Felipedsi97/development-board-CAD/PG/esquematico/Models and Datasheets/LD1117S33/LD1117S33CTR.step

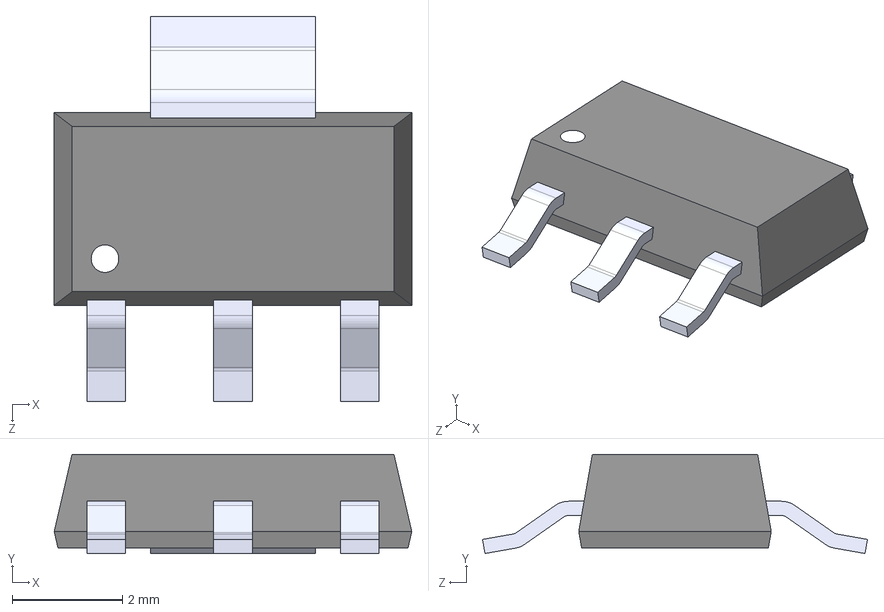
[picture p1: CAD file, 2023-08-02]
PG/esquematico/Models and Datasheets/LD1117S33/LD1117S33CTR.step
6.50 x 1.80 x 7.00 mm
