Felipedsi97/development-board-CAD/PG/esquematico/Models and Datasheets/PJ-002A/PJ-002A.step

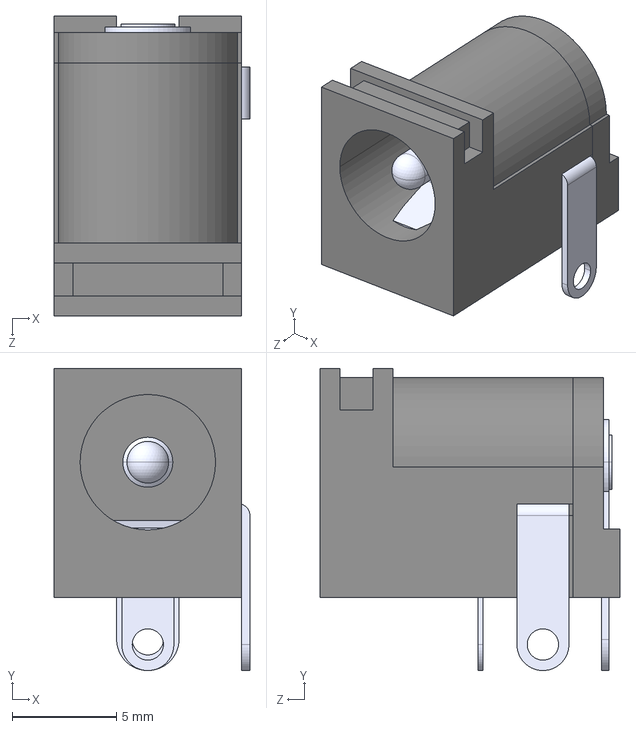
[picture p2: CAD file, 2023-08-02]
PG/esquematico/Models and Datasheets/PJ-002A/PJ-002A.step
9.40 x 14.5 x 14.4 mm
