Felipedsi97/development-board-CAD/PI/Schematics and Footprints/ATS08A-E/ATS08A-E.step

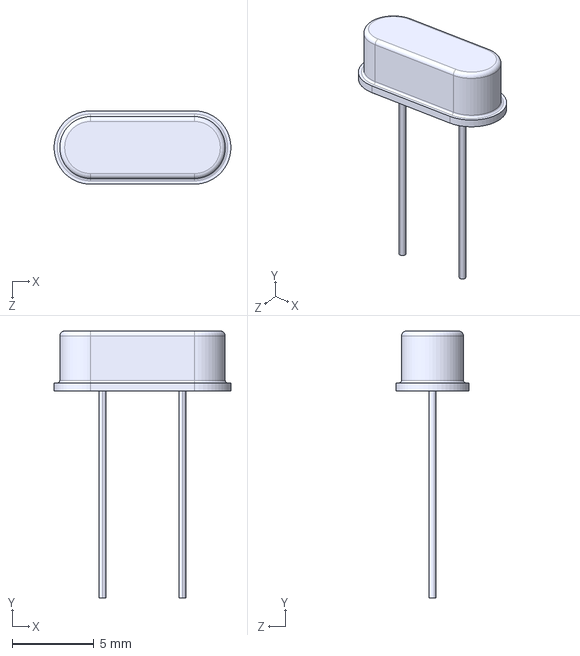
[picture p3: CAD file, 2023-08-02]
PI/Schematics and Footprints/ATS08A-E/ATS08A-E.step
10.9 x 16.4 x 4.50 mm
