Felipedsi97/development-board-CAD/PG/Manual.pdf

## PBLE01 Co-projeto de produtos eletrônicos

### Manual

Grupo 1

Rev 1 - Nov/2022

## Sumário

1 Introdução | 4
2 Requisitos | 4
3 Ambiente de desenvolvimento | 5
4 Esquema elétrico | 6
4.1 Circuito Geral | 6
4.2 Circuito de alimentação | 7
4.3 Circuito de gravação | 8
4.4 Circuito de relógio | 9
4.5 Circuito de chaves e LEDs | 9
4.6 Circuito de sinais analógicos | 10
4.7 Circuito do LCD | 11
4.8 Circuito de barras de expansão | 12
4.9 Relatório de verificação de erros de projeto elétrico | 13
5 Placa de circuito impresso | 14
5.1 Desenho da placa de circuito impresso | 15
5.2 Relatório de verificação de erros de projeto | 17
6 Características gerais | 18
6.1 Mapas de pinos | 18
6.1.1 Microcontrolador | 18
6.1.2 Interface | 19
6.2 Alimentação e consumo | 23
7 Programa embarcado de validação | 24
7.1 Modelo de operação geral | 24
7.2 Arquitetura | 24
7.3 Casos de uso | 30
8 Custos | 31
8.1 Materiais | 31
9 Apêndice | 32
9.1 Memorial de cálculos | 32
9.2 Código-fonte do programa de validação | 32
9.3 Lista de compras | 45
10 Bibliografia | 47
11 Anexo | 48
________________________________________________________________________ 2/49

## Identificação

Matrícula | Nome | Responsabilidade
2019002970 | Felipe dos Santos | Esquema elétrico
2017018748 | William Shoji Yokota | Placa de circuito impresso
2020025501 | Afonso Ambrósio Beiral Satolo Monteiro | Embarcado

Data:
28/11/22

________________________________________________________________________ 3/49

## 1 Introdução

Apresentar o objetivo deste documento.
O objetivo deste documento é apresentar os detalhes de projeto de uma placa de desenvolvimento de propósito geral desenvolvida ao decorrer do curso. Detalhes de projeto como cálculos das especificações de componentes, custos e modo de uso do circuito final serão explicitados.

## 2 Requisitos

Os requisitos elétricos do projeto estão dispostos na tabela a seguir.

Tabela 1: Requisitos técnicos quanto à alimentação
Requisito | Classe | Descrição
R1 | Alimentação | - Suportar tensão de entrada de 7 a 10V (CC); - Empregar conector de alimentação do tipo jack J4; - Possuir proteção contra tensão reversa; - Possuir regulador linear com saída de 5V (CC); - Possuir regulador linear com saída de 3.3V (CC); - Possuir LED de indicação de tensão de alimentação;
R2 | Operação/gravação do embarcado | - Empregar microcontrolador da família LCP1114; - Possuir barra de pinos para gravação do padrão JTAG; - Possuir circuito baseado em “jumper” para permitir a gravação serial através de transceptor USB-serial; - Chave tactil de reinício;
R3 | Interface de Usuário | - Possuir teclado numérico de cinco (5) teclas com disposição de controle (botões direcionais e de confirmação); - Possuir barra de pinos de conexão para visor LCD; - Possuir quatro (4) LEDs para sinalização diversa;
R4 | Periféricos e expansão | - Empregar relógio de tempo real; - Empregar conversor digital para analógico; - Possuir entrada para sinal analógico diferencial; - Possuir duas barras de expansão independentes cada qual com sinais de comunicação I²C, de referência (terra) e de alimentação; - Possuir barra de expansão de sinais para pinos não utilizados do microcontrolador e a contemplar os sinais de alimentação;
R5 | Comunicação | - Empregar conversor USB-serial;

________________________________________________________________________ 4/49

## 3 Ambiente de desenvolvimento

A tabela a seguir indica os recursos utilizados no projeto bem como suas versões,

Tabela 2: Recursos de desenvolvimento
Recurso | Descrição | Versão
1 | KiCad | 6.0.7
2 | MPLAB X IDE | 6.05
3 | PICSimLab | 0.8.11

________________________________________________________________________ 5/49

## 4 Esquema elétrico

A partir dos requisitos, uma representação do esquema elétrico foi montada na ferramenta KiCad. Todo o projeto pôde ser desenvolvido em uma única página, subdividido nos seguintes blocos funcionais: alimentação, gravação, periféricos (relógio, sinais analógicos e barras de expansão) e interface (visor LCD, teclado e LEDs). Tais blocos funcionais vêm descritos a seguir.

## 4.1 Circuito Geral

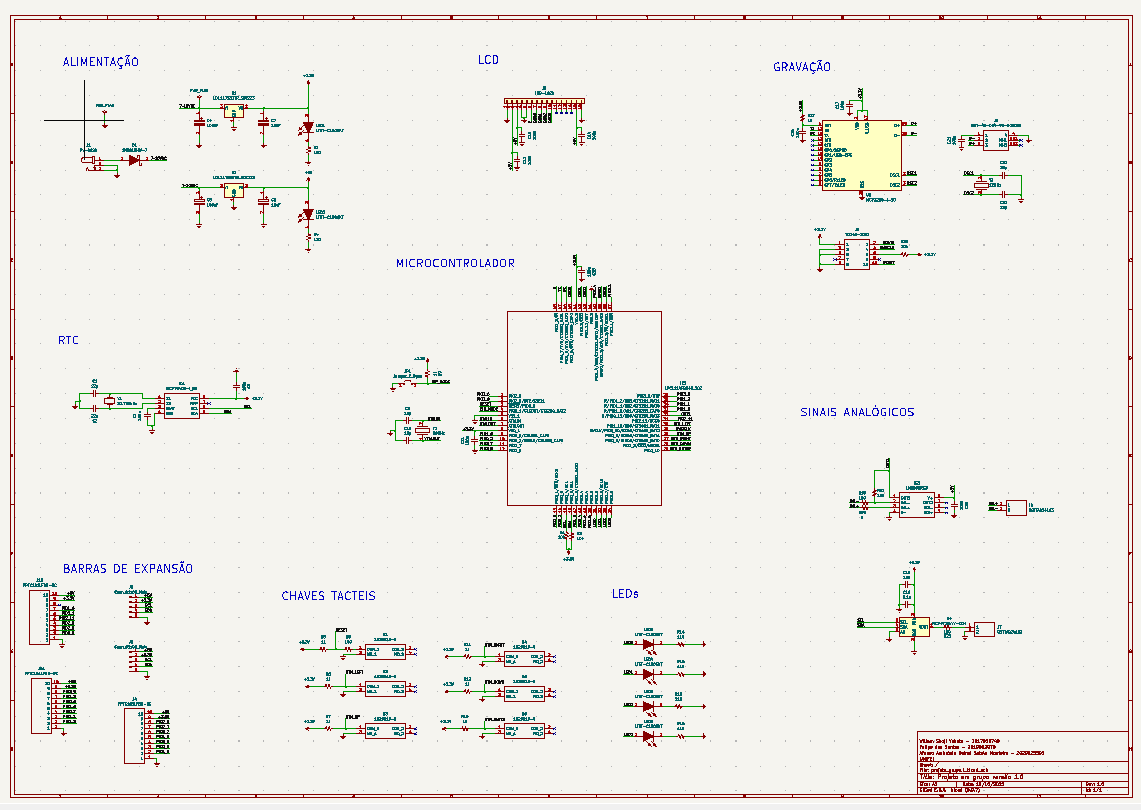
[picture p4: figure]

________________________________________________________________________ 6/49

## 4.2 Circuito de alimentação

O primeiro bloco funcional é responsável por receber a alimentação do sistema e gerar sinais estáveis de 5V e 3.3V em corrente contínua. Também conta com um diodo para proteção contra polarização reversa.

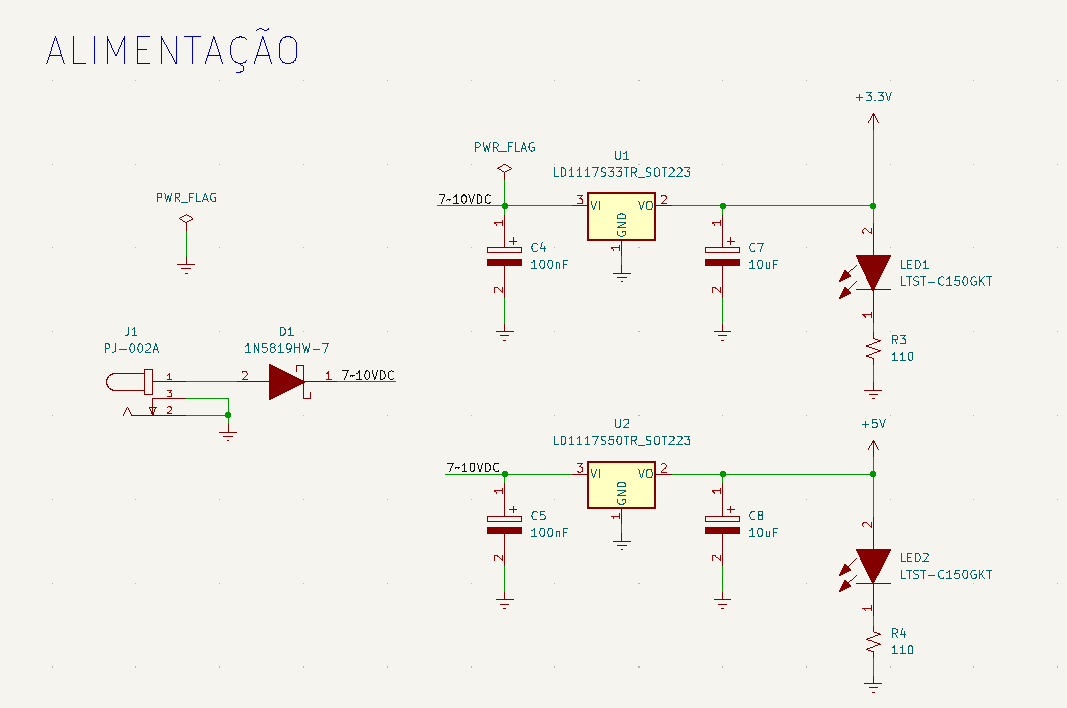
[picture p5: figure]

________________________________________________________________________ 7/49

## 4.3 Circuito de gravação

O circuito de gravação conta com conectores JTAG e USB possibilitando que o firmware possa ser gravado de duas formas diferentes no microcontrolador.

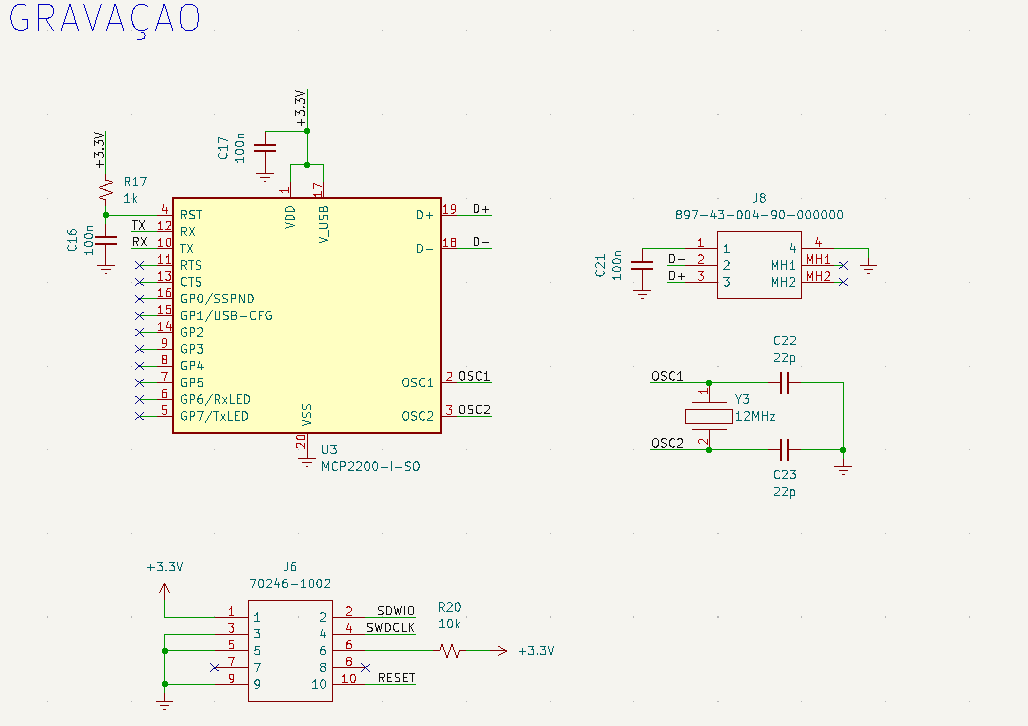
[picture p6: figure]

________________________________________________________________________ 8/49

## 4.4 Circuito de relógio

Um dos periféricos presentes é um relógio de tempo real (RTC) responsável por fornecer horários de forma mais precisa, possibilitando ainda a configuração de alarmes. A comunicação entre o RTC e o microcontrolador se dá pelo protocolo I²C.

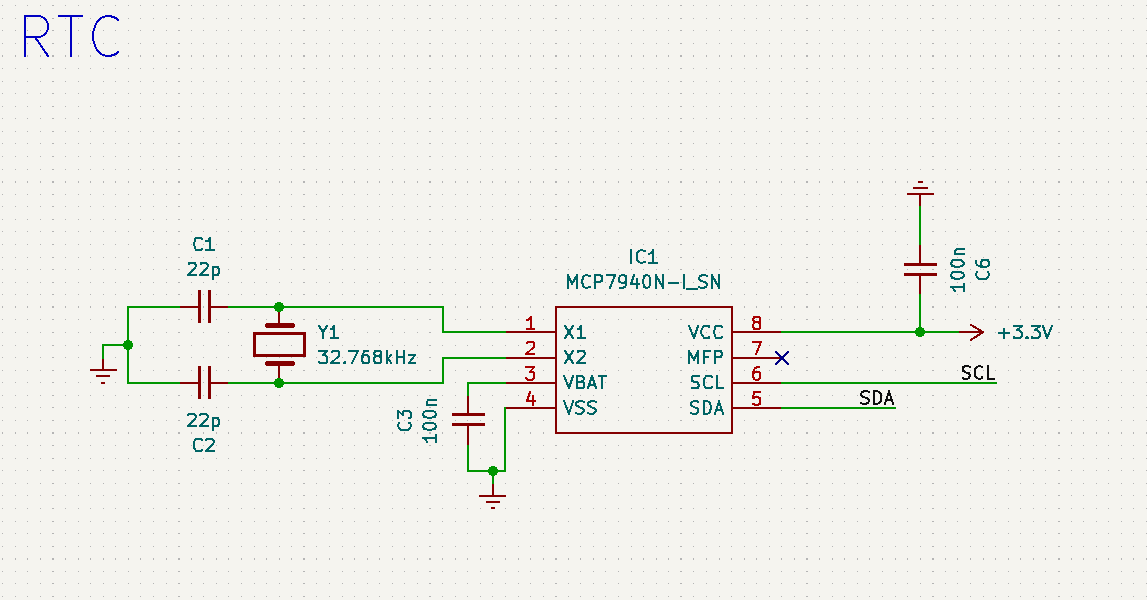
[picture p7: figure]

## 4.5 Circuito de chaves e LEDs

O circuito de teclado e LEDs é responsável pela interação com o usuário, possibilitando a navegação e seleção de funcionalidades no menu de controle do sistema, além de indicar estados através dos LEDs.

________________________________________________________________________ 9/49

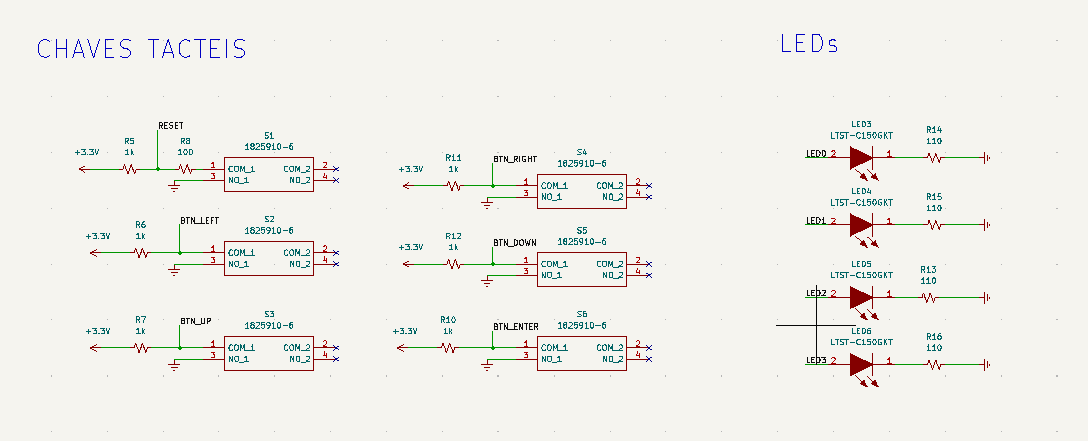
[picture p8: figure]

## 4.6 Circuito de sinais analógicos

O circuito de sinais analógicos conta com duas funcionalidades: ler dados de forma analógica e converter sinais digitais em analógicos. A entrada analógica é realizada por meio de um amplificador operacional com ganho equivalente às tensões de trabalho do microcontrolador (3.3V) e a saída analógica é realizada pelo conversor digital-analógico. Ambos possuem conectores diferenciais.

________________________________________________________________________ 10/49

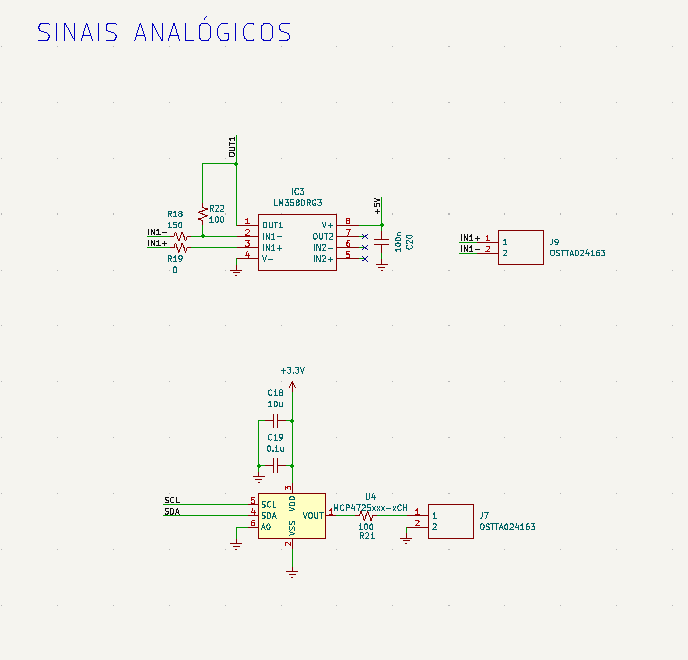
[picture p9: figure]

## 4.7 Circuito do LCD

O visor LCD é responsável pela interação com o usuário, sendo um dispositivo de saída.

________________________________________________________________________ 11/49

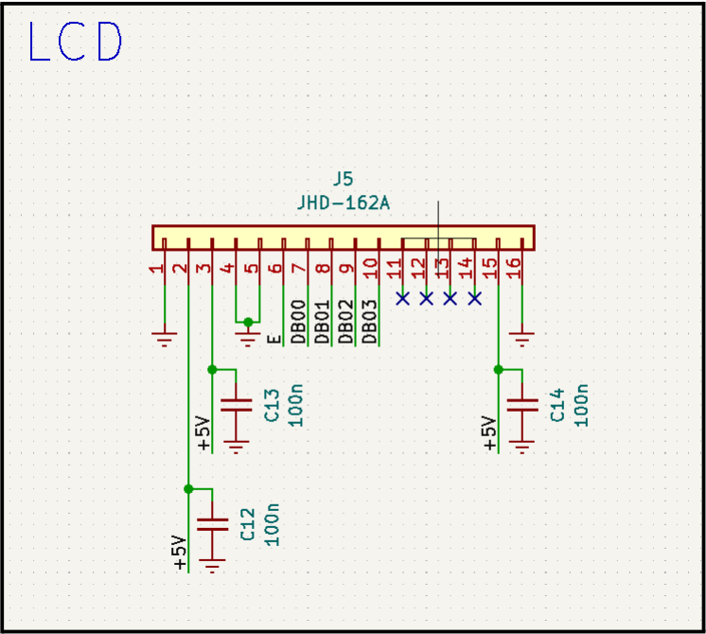
[picture p10: figure]

## 4.8 Circuito de barras de expansão

________________________________________________________________________ 12/49

As barras de expansão estão previstas para garantir a possibilidade de futuras adaptações no projeto, além de dois canais de comunicação I²C com o microcontrolador para propósitos do usuário.

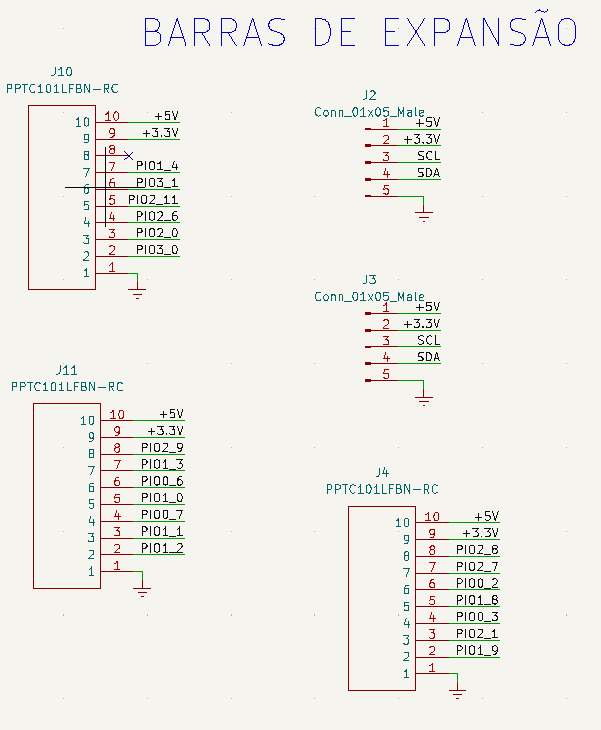
[picture p11: figure]

## 4.9 Relatório de verificação de erros de projeto elétrico

________________________________________________________________________ 13/49

O relatório não apresentou erros e os avisos são relacionados a questões do próprio ambiente de desenvolvimento.

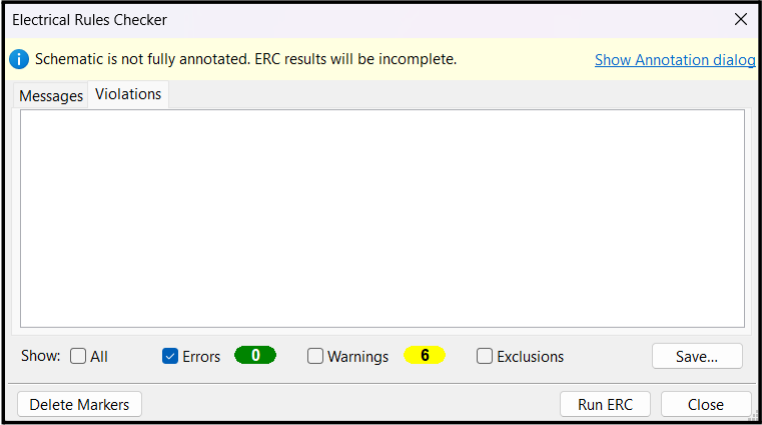
[picture p12: figure]

________________________________________________________________________ 14/49

## 5 Placa de circuito impresso

Descrever o desenvolvimento da PCI e listar (de forma tabular) os requisitos de projeto para tanto (distanciamentos, número de faces, etc). Especificar caso tenha sido utilizado planos de “terra”.
A PCI foi desenvolvida a partir do esquema elétrico englobando as funcionalidades e periféricos nele apresentados.

Tabela 3: Requisitos da PCI
Requisito | Classe | Descrição
R1 | Características gerais | - Ter dimensões de até 7x7cm; - Possuir dupla face de condução; - Utilizar a face inferior como plano de terra; - Possuir identificação dos componentes; - Possuir identificação do grupo de desenvolvimento; - Possuir identificação do pino de referência para conectores de programação e de alimentação; - Possuir identificação de pinos para demais conectores; - Possuir quatro furos de fixação posicionados nos cantos; - Possuir capacitores de supressão de tensão para todos os circuitos integrados;
R2 | Espaçamento | - Mínima largura para trilhas de sinais: 8 mils; - Mínima largura para trilhas de alimentação: 12 mils; - Mínimo espaçamento entre linhas, furos e ilhas: 8 mils; - Mínimo diâmetro de furo de vias: 12 mils; - Mínimo diâmetro de ilhas de vias: 25 mils; - Não utilizar microvias;

Tabela 4: Lista de componentes disponíveis

Item | Part number | Fabricante
Processador | LPC1114FBD48/302 | NXP
Relógio de tempo real | MCP7940N–I/SN | Microchip
Transceptor USB–serial | MCP2200–I/SO | Microchip
Conversor digital para analógico | MCP4725A0T-E/CH | Microchip
Resistores diversos (100, 470, 1k, 4k7, 10k, 100k e 1 M) | SMD 0805 | -
Capacitores cerâmicos (22 e 39 pF, 10 nF, 100 nF e 220 nF) | SMD 0805 | -
Capacitores (regulador de tensão) | 710-865090368008 | Wurth Elektronik
________________________________________________________________________ 15/49

Trimpot de 10k | P160KN–0QC15B100K | TT Electronics
Trimmer de 10k | 3296W–1–103RLF | Bourns Inc.
Barra de pinos | PPTC101LFBN–RC | Sullins Connector Solutions
Conector de energia | PJ–002A | CUI Devices
Diodos emissores de luz | LTST–C150GKT | Lite On
Amplificador operacional | LM358DR/LM358DG | On Semi
Conector USB | 897–43–004–90–000000 | Mill–Max
Chaves tácteis | 1825910–6 | TE Connectivity
Reguladores de tensão | LD1117AS33TR (3.3V) e LD1117AS50TR (5.0V) | STMicroelectronics
Cristal de 32.768 kHz | AB38T–32.768KHZ | ABRACON
Cristal de 20 MHz | ATS20A | CTS Electronic Components
Cristal de 12 MHz | ATS12A | CTS Electronic Components
Conector para entradas diferenciais | OSTTA024163 | On Shore Technology Inc.
Conector para barra de expansão | 3–644456–2 (por exemplo) | TE Connectivity
Diodo retificador | 1N5819HW–7 | Diodes Incorporated
Visor de 16x2 pontos | JHD162A | –
Conector JTAG (SWD) | 70246-1002 | Molex

## 5.1 Desenho da placa de circuito impresso

- Face superior:

________________________________________________________________________ 16/49

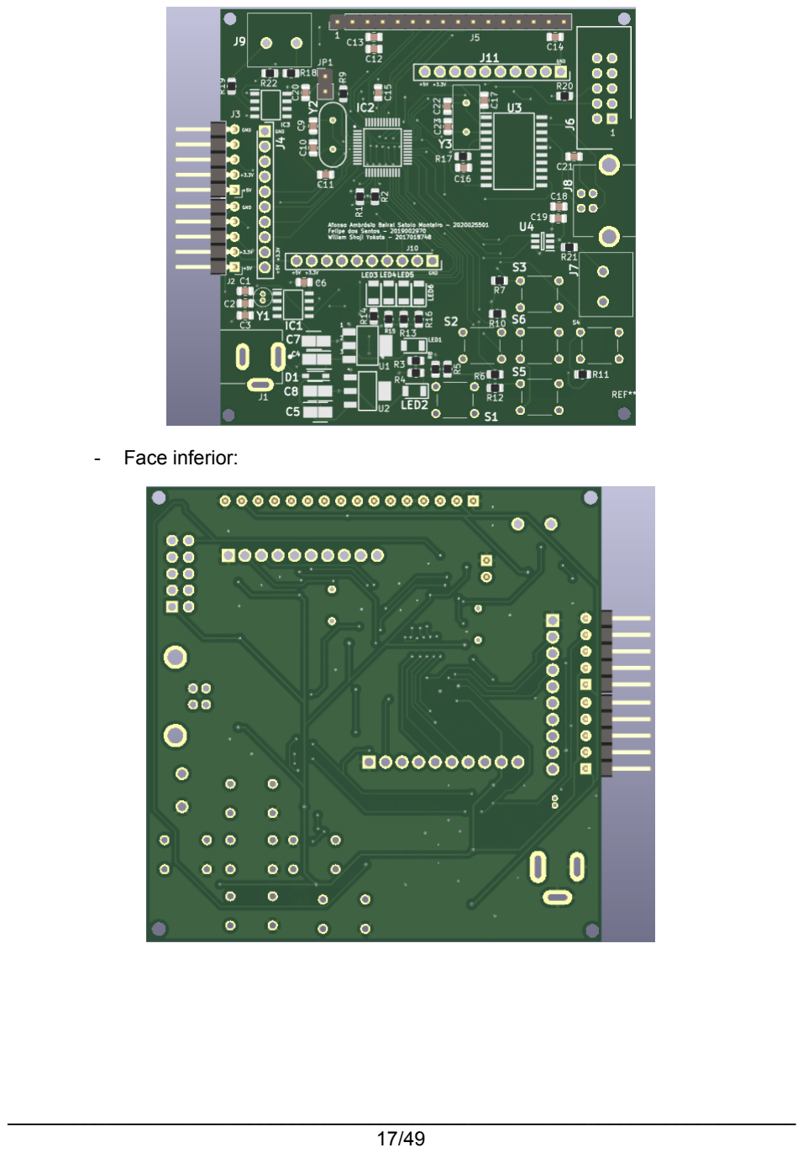
[picture p13: page 17]

- Face inferior:

________________________________________________________________________ 17/49

## 5.2 Relatório de verificação de erros de projeto

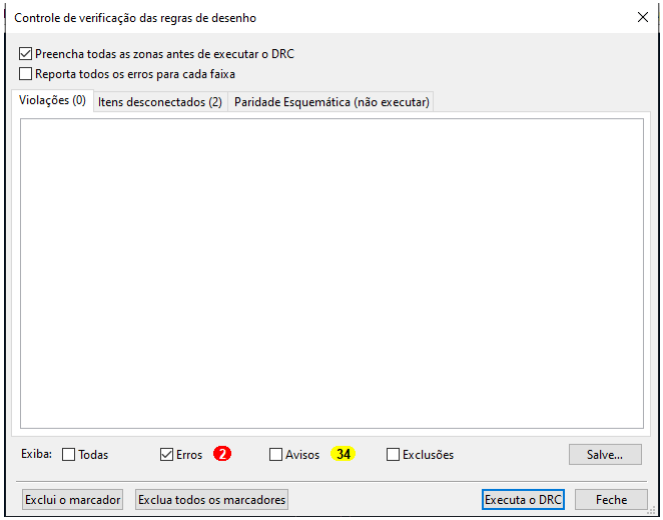
[picture p14: figure]

________________________________________________________________________ 18/49

## 6 Características gerais

## 6.1 Mapas de pinos

### 6.1.1 Microcontrolador

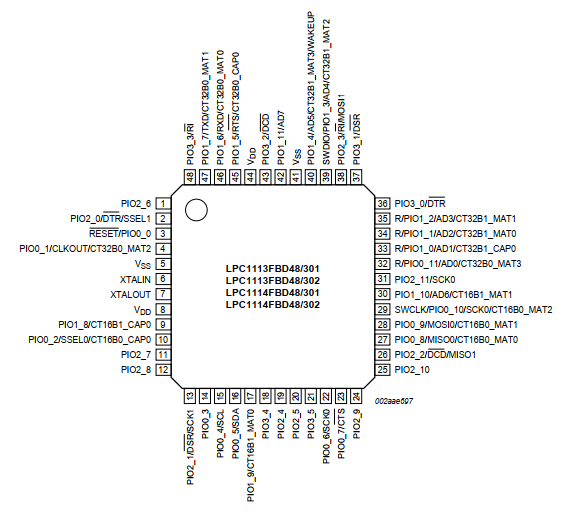
[picture p15: figure]

Pino | Conexão | Pino | Conexão | Pino | Conexão | Pino | Conexão
01 | PIO2_6 | 13 | PIO2_1 | 25 | BTN_ENTER | 37 | PIO3_1
02 | PIO2_0 | 14 | PIO0_3 | 26 | BTN_DOWN | 38 | DB03
03 | RESET | 15 | SCL | 27 | BTN_RIGHT | 39 | SWDIO
04 | ISP_MODE | 16 | SDA | 28 | BTN_UP | 40 | PIO1_4
05 | Earth | 17 | PIO1_9 | 29 | SWDCLK | 41 | Earth

________________________________________________________________________ 19/49

06 | XTALIN | 18 | PIO3_4 | 30 | BTN_LEFT | 42 | DB02
07 | XTALOUT | 19 | PIO2_4 | 31 | PIO2_11 | 43 | DB01
08 | +3.3V | 20 | PIO2_5 | 32 | OUT1 | 44 | +3.3V
09 | PIO1_8 | 21 | LED0 | 33 | PIO1_0 | 45 | DB00
10 | PIO0_2 | 22 | LED1 | 34 | PIO1_1 | 46 | RX
11 | PIO2_7 | 23 | LED2 | 35 | PIO1_2 | 47 | TX
12 | PIO2_8 | 24 | LED3 | 36 | PIO3_0 | 48 | E

### 6.1.2 Interface

- Gravação:
a) MCP2200
Pinos | Conexão | Pinos | Conexão
1- VDD | 3.3V | 11 - RTS | N/C
2 - Oscilador | Crystal Y3 | 12 - RX | Micro (TX)
3 - Oscilador | Crystal Y3 | 13 - CTS | N/C
4 - RST | 3.3V | 14 - GP2 | N/C
5 - GP7 | N/C | 15 - GP1 | N/C
6 - GP6 | N/C | 16 - GP0 | N/C
7 - GP5 | N/C | 17 - V_USB | 3.3V
8 - GP4 | N/C | 18 - D- | USB 897-43-004-90-000000 (D-)
9 - GP3 | N/C | 19 - D+ | USB - 897-43-004-90-000000 (D+)
10 - TX | Micro (RX) | 20 - VSS | GND
b) J6
Pinos | Conexão | Pinos | Conexão
1 | 3.3V | 6 | 3.3V
2 | Micro (SWIO) | 7 | N/C

________________________________________________________________________ 20/49

3 | GND | 8 | N/C
4 | Micro (SWDCLK) | 9 | GND
5 | GND | 10 | Micro (RESET)
c) J8
Pinos | Conexão | Pinos | Conexão
1 | GND | 4 | GND
2 | D- | MH1 | N/C
3 | D+ | MH2 | N/C
- Relógio de tempo real (RTC - MCP7940N ):
Pinos | Conexão | Pinos | Conexão
1- X1 | Crystal Y1 | VCC | 3.3V
2 - X2 | Crystal Y1 | MFP | N/C
3 - VBAT | GND | SCL | Micro (SCL)
4 - VSS | GND | SDA | Micro (SDA)
- Sinais Analógicos:
a) MCP4725
Pinos | Conexão | Pinos | Conexão
1 - VOUT | J7 (1) | 4 - SDA | Micro (SDA)
2 - VSS | GND | 5 - SCL | Micro (SCL)
3 - VDD | 3.3V | 6 - A0 | GND
b) J7
Pinos | Conexão
1 | MCP4725 (VOUT)

________________________________________________________________________ 21/49

2 | GND
c) LM358
Pinos | Conexão | Pinos | Conexão
1 - OUT1 | Micro (OUT1) | 5 - IN2+ | N/C
2 - IN1- | J9 (2) | 6 - IN2- | N/C
3 - IN1+ | J9 (1) | 7 - OUT2 | N/C
4 - V- | GND | 8 - V+ | 5V
d) J9
Pinos | Conexão
1 | LM358 (IN1+)
2 | LM358 (IN1-)
- Barras de Expansão:
a) J2 e J3
Pinos | Conexão | Pinos | Conexão
1 | 5V | 4 | Micro (SDA)
2 | 3.3V | 5 | GND
3 | Micro(SCL)
b) J4
Pinos | Conexão | Pinos | Conexão
1 | GND | 6 | Micro (PIO0_2)
2 | Micro (PIO1_9) | 7 | Micro (PIO2_7)
3 | Micro (PIO2_1) | 8 | Micro (PIO2_8)
4 | Micro (PIO0_3) | 9 | 3.3V

________________________________________________________________________ 22/49

5 | Micro (PIO1_8) | 10 | 5V
c) J10
Pinos | Conexão | Pinos | Conexão
1 | GND | 6 | Micro (PIO3_1)
2 | Micro (PIO3_0) | 7 | Micro (PIO1_4)
3 | Micro (PIO2_0) | 8 | N/C
4 | Micro (PIO2_6) | 9 | 3.3V
5 | Micro (PIO2_11) | 10 | 5V
d) J11
Pinos | Conexão | Pinos | Conexão
1 | GND | 6 | Micro (PIO0_6)
2 | Micro (PIO1_2) | 7 | Micro (PIO1_3)
3 | Micro (PIO1_1) | 8 | Micro (PIO2_9)
4 | Micro (PIO0_7) | 9 | 3.3V
5 | Micro (PIO1_0) | 10 | 5V
- LCD:
Pinos | Conexão | Pinos | Conexão
1 | GND | 9 | Micro (DBO2)
2 | 5V | 10 | Micro (DBO3)
3 | 5V | 11 | N/C
4 | GND | 12 | N/C
5 | GND | 13 | N/C
6 | E | 14 | N/C
________________________________________________________________________ 23/49

7 | Micro (DBO0) | 15 | 5V
8 | Micro (DBO1) | 16 | GND

## 6.2 Alimentação e consumo

A placa deve ser alimentada com uma tensão de entre +7V e +15V CC. O consumo estimado do sistema é de 1.2 watts.

________________________________________________________________________ 24/49

## 7 Programa embarcado de validação

O programa embarcado de validação tem por finalidade testar os componentes da placa. O programa desenvolvido testa o teclado, os LEDs de indicação, o visor de LCD e a entrada de sinal diferencial.

## 7.1 Modelo de operação geral

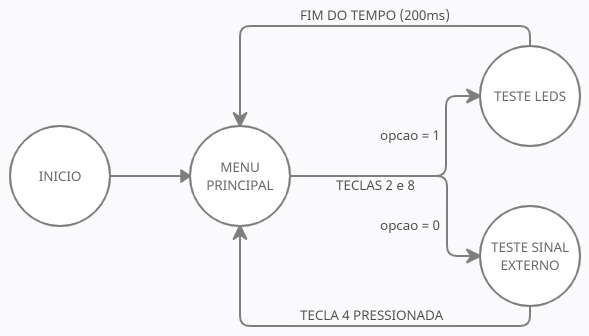
[picture p16: figure]

## 7.2 Arquitetura

delayX2ms [main.c - programa]

Parâmetros | unsigned char t
Retorno | void

Gera um atraso (delay) de 2 x t milisegundos

Dependência -

________________________________________________________________________ 25/49

bitSet [bits.h - driver]

Parâmetros | int arg, int bit
Retorno | 0 ou 1

Define o determinado bit (bit) de uma porta (arg) como ligado (high).

Dependência -

bitClr [bits.h - driver]

Parâmetros | int arg, int bit
Retorno | 0 ou 1

Define o determinado bit (bit) de uma porta (arg) como desligado (low).

Dependência -

bitTst [bits.h - driver]

Parâmetros | int arg, int bit
Retorno | 0 ou 1

Testa se determinado bit (bit) de uma porta (arg) está ligado ou desligado.

Dependência -

digitalWrite [io.c - driver]

Parâmetros | int pin, int value
Retorno | void

Escreve o valor recebido (value) na porta recebida (pin).

Dependência bitSet, bitClr

________________________________________________________________________ 26/49

pinMode [io.c - driver]

Parâmetros | int pin, int type
Retorno | void

Configura um determinado pino como entrada ou saída.

Dependência bitSet, bitClr

Delay2ms [lcd.c - driver]

Parâmetros | -
Retorno | void

Gera um atraso de 2 milissegundos

Dependência -

Delay40us [lcd.c - driver]

Parâmetros | -
Retorno | void

Gera um atraso de 40 microsegundos.

Dependência -

lcdCommand [lcd.c - driver]

Parâmetros | unsigned char opcao
Retorno | void

Responsável por enviar comandos ao visor, como posição do cursor e limpar o display.

Dependência digitalWrite, Delay2ms, Delay40us

________________________________________________________________________ 27/49

lcdInit [lcd.c - driver]

Parâmetros | -
Retorno | void

Configura as portas responsáveis por se comunicar com o display e envia os comandos iniciais configurando o modo de operação do mesmo.

Dependência pinMode, Delay2ms, lcdCommand

lcdData [lcd.c - driver]

Parâmetros | unsigned char opcao
Retorno | void

Envia dados a serem impressos no display de acordo com a tabela ASCII.

Dependência digitalWrite, Delay40us

kpInit [keypad.c - driver]

Parâmetros | -
Retorno | void

Inicializa as portas responsáveis pelo teclado matricial.

Dependência -

kpDebounce [keypad.c - driver]

Parâmetros | -
Retorno | void

Verifica se há alguma tecla pressionada e armazena o endereço da tecla em uma variável interna.

Dependência bitSet, bitClr, bitTst

________________________________________________________________________ 28/49 kpRead [keypad.c - driver]

Parâmetros | -
Retorno | unsigned int

Retorna o valor que representa o endereço da tecla pressionada.

Dependência -

adcInit [adc.c - driver]

Parâmetros | -
Retorno | void

Inicializa o conversor analógico-digital.

Dependência pinMode, bitSet

adcRead [adc.c - driver]

Parâmetros | unsigned int channel
Retorno | int

Lê o valor presente no conversor analógico-digital e retorna um inteiro que varia de 0 a 100.

Dependência bitTst

menuLcd [main.c - programa]

Parâmetros | unsigned char opcao
Retorno | void

Aciona o visor de LCD imprimindo o menu de opções. Recebe o parâmetro “opcao” representando a opção selecionada no menu. Se “opcao” for igual a 0, a seta indicando

________________________________________________________________________ 29/49 a opção selecionada será impressa na primeira linha, caso contrário, a seta é impressa na segunda linha.

Dependência lcdCommand, lcdData

proxMenu [main.c - programa]

Parâmetros | unsigned char opcao
Retorno | void

“Move” a seta para cima ou para baixo a depender do valor recebido em “opcao”.

Dependência lcdCommand, lcdData

testeLed [main.c - programa]

Parâmetros | -
Retorno | void

Acende os 4 LEDs por aproximadamente 100 milissegundos e então os apaga enquanto exibe uma barra de progresso no visor. Retorna ao menu principal ao término do teste.

Dependência lcdCommand, lcdData, delayX2ms

testeSinalExt [main.c - programa]

Parâmetros | -
Retorno | void

Imprime o valor recebido do conversor analógico-digital no display de LCD o valor é lido e atualizado de forma indefinida até que a tecla referente à seta esquerda seja pressionada, retornando ao menu principal.

Dependência lcdCommand, lcdData, kpDebounce, kpRead, adcRead,

________________________________________________________________________ 30/49

## 7.3 Casos de uso

Estado inicial | Após ser energizada, a placa é inicializada com todos os leds apagados, no display é exibido o menu principal com as seguintes opções: - Teste LEDs - Teste sinal ext Por padrão a primeira opção estará selecionada, sendo indicado por uma seta para a direita;
Navegação | Pressionando as teclas 2 (seta para cima) e 8 (seta para baixo) do teclado numérico é possível subir e descer, respectivamente. Ao atingir o fim da lista, a seta volta ao topo;
Selecionar | Para selecionar uma opção do menu, basta pressionar as teclas 5 (enter) ou 6 (direita);
Teste LEDs | Ao acessar esta opção, os 4 leds (B4-B7) serão ligados; O display exibirá a mensagem “Teste LEDs” seguida de uma barra de progresso; Ao término o programa retorna ao menu inicial;
Teste sinal ext | Ao acessar esta opção, o display exibirá o valor lido pelo potenciômetro P1 em uma escala de 0 a 3.3 V; Para retornar ao menu principal, pressione a tecla 4 (seta para esquerda);

________________________________________________________________________ 31/49

## 8 Custos

## 8.1 Materiais

A estimativa de custo em materiais é de U$ 30,64 em componentes;

________________________________________________________________________ 32/49

## 9 Apêndice

## 9.1 Memorial de cálculos

Os cálculos dos resistores de pull-up e outros foram realizados utilizando a 1ª Lei de Ohm (U = R*I) com base nos parâmetros de funcionamento do microcontrolador listados abaixo.
Vih (min) = 0.7*Vdd
Vil (max) = 0.3*Vdd
Voh (min) = Vdd - 0.4
Vol (max) = 0.3*Vdd
Para os capacitores, foram utilizados valores estipulados pelo professor e valores sugeridos nas folhas de dados dos componentes utilizados.

## 9.2 Código-fonte do programa de validação

A seguir estão os arquivos de código fonte do projeto, os drivers usados foram elaborados pelo professor Rodrigo Maximiano Antunes de Almeida.

### 9.2.1 main.c

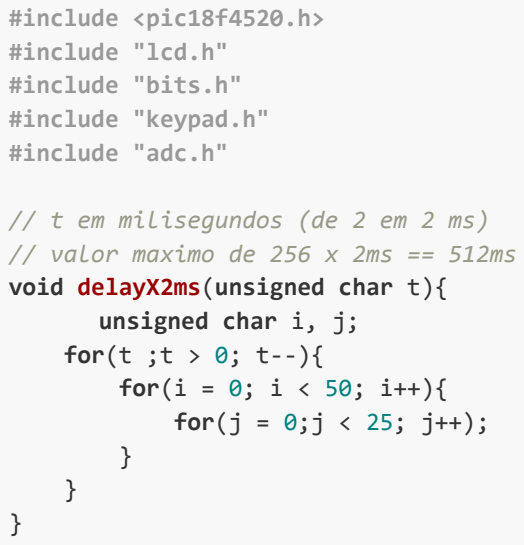
[picture p17: figure]
#include <pic18f4520.h> #include "lcd.h" #include "bits.h" #include "keypad.h" #include "adc.h"; // t em milisegundos (de 2 em 2 ms) // valor maximo de 256 x 2ms == 512ms void delayX2ms(unsigned char t){ unsigned char i, j; for(t ;t > 0; t--){ for(i = 0; i < 50; i++){ for(j = 0;j < 25; j++);

________________________________________________________________________ 33/49 void menuLcd(unsigned char opcao){ unsigned char i;
char menu0[10] = "Teste LEDs"; char menu1[15] = "Teste sinal ext";

// imprime o menu inicial
lcdCommand(0x0); // limpa o display lcdCommand(0x1);
lcdCommand(0x8); // leva para a primeira posicao lcdCommand(0x0);

if(opcao){
lcdData(0x7E);
}else{
lcdData(' ');
}

for(i = 0;i < 11;i++){
lcdData(menu0[i]);
}

// proxima linha
lcdCommand(0xC);
lcdCommand(0x0);

if(!opcao){
lcdData(0x7E);
}else{
lcdData(' ');
}

for(i = 0;i < 15;i++){
lcdData(menu1[i]);
}
}

void proxMenu(unsigned char opcao){ lcdCommand(0x8);
lcdCommand(0x0);

// faz troca a seta de posicao if(opcao){
lcdData(0x7E);
}else{
lcdData(' ');
}

________________________________________________________________________ 34/49

lcdCommand(0xc);
lcdCommand(0x0);

if(!opcao){
lcdData(0x7E);
}else{
lcdData(' ');
}
}

void testeLed(){
unsigned char i;
char titulo[13] = " Teste LEDs";

lcdCommand(0x0); // limpa o display lcdCommand(0x1);
lcdCommand(0x8); // leva para a primeira posicao lcdCommand(0x0);

// imprime o titulo
for(i = 0;i < 13;i++){
lcdData(titulo[i]);
}

// acende os LEDs
TRISB &= 0x0f;
PORTB |= 0xf0;

// proxima linha
lcdCommand(0xC);
lcdCommand(0x0);

// efeito barra de progresso for(i = 0;i < 16;i++){
lcdData(0xFF);
delayX2ms(50); // aprox 100ms }

// apaga os LEDs
PORTB = 0x00;
}

void testeSinalExt(){
unsigned char i;
unsigned int valor, botao = 0x0; char titulo[10] = "Sinal ext."; char sair[5] = " sair";

________________________________________________________________________ 35/49

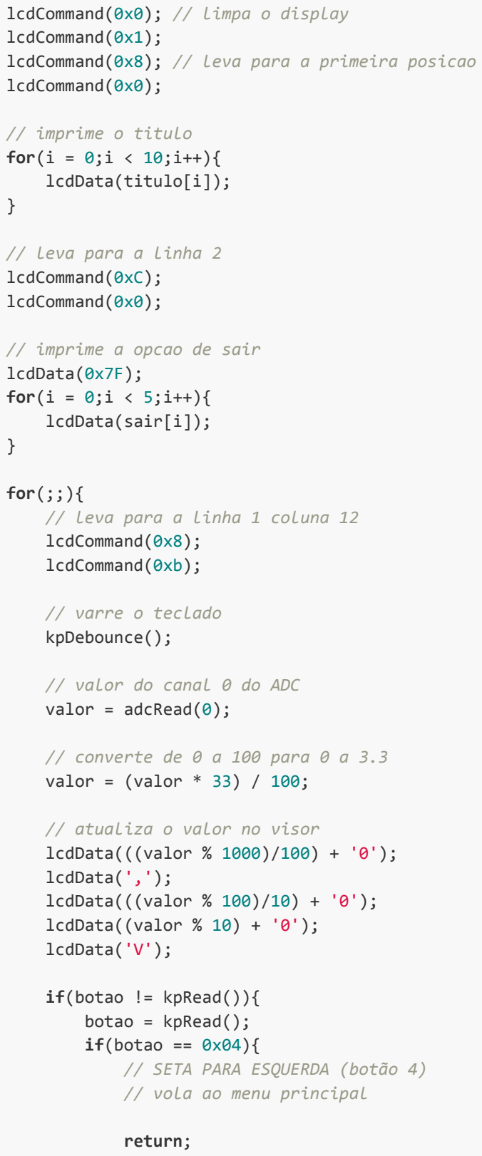
[picture p18: figure]
lcdCommand(0x0); // limpa o display lcdCommand(0x1);; lcdCommand(0x0);; // imprime o titulo for(i = 0;i < 10;i++){ lcdData(titulo[i]);; // leva para a linha 2 lcdCommand(0xC); lcdCommand(0x0);; // imprime a opcao de sair lcdData(0x7F); for(i = 0;i < 5;i++){ lcdData(sair[i]);; for(;;){ // leva para a linha 1 coluna 12 lcdCommand(0x8); lcdCommand(0xb);; // varre o teclado kpDebounce();; // valor do canal 0 do ADC valor = adcRead(0);; // converte de 0 a 100 para 0 a 3.3 valor = (valor * 33) / 100;; // atualiza o valor no visor lcdData(((valor % 1000)/100) + '0'); lcdData(','); lcdData(((valor % 100)/10) + '0'); lcdData((valor % 10) + '0'); lcdData('V');; if(botao != kpRead()){ botao = kpRead(); if(botao == 0x04){ // SETA PARA ESQUERDA (botão 4) // vola ao menu principal; return;

lcdCommand(0x8); // leva para a primeira posicao

________________________________________________________________________ 36/49

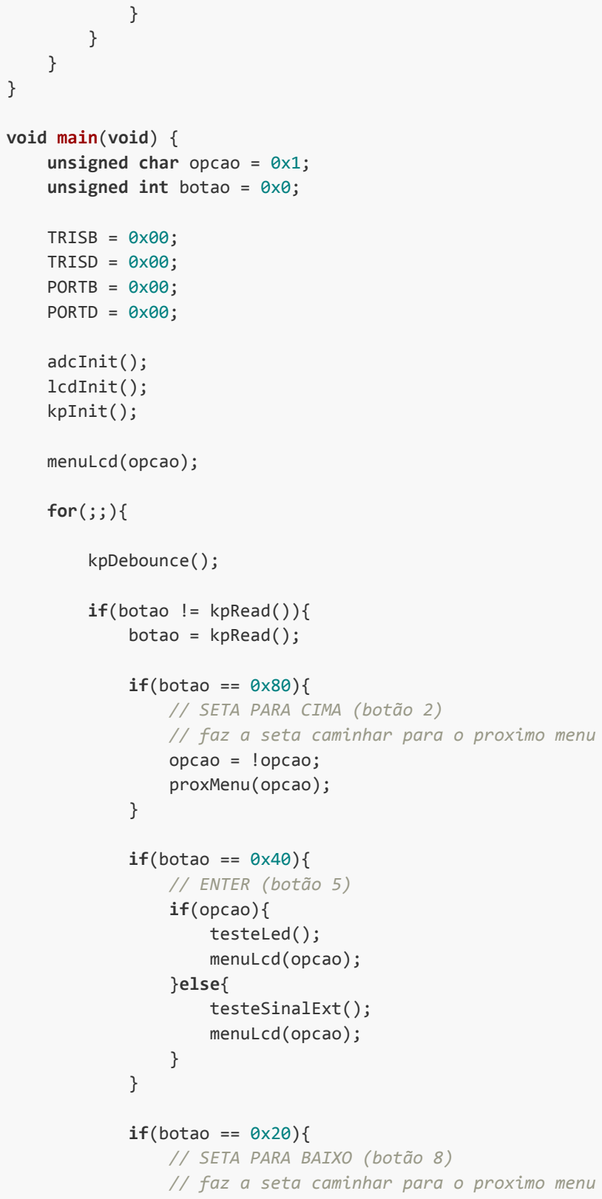
[picture p19: figure]
void main(void) { unsigned char opcao = 0x1; unsigned int botao = 0x0;; TRISB = 0x00; TRISD = 0x00; PORTB = 0x00; PORTD = 0x00;; adcInit(); lcdInit(); kpInit();; menuLcd(opcao);; for(;;){; kpDebounce();; if(botao != kpRead()){ botao = kpRead();; if(botao == 0x80){ // SETA PARA CIMA (botão 2); opcao = !opcao; proxMenu(opcao);; if(botao == 0x40){ // ENTER (botão 5) if(opcao){ testeLed(); menuLcd(opcao); }else{ testeSinalExt(); menuLcd(opcao);; if(botao == 0x20){ // SETA PARA BAIXO (botão 8)

// faz a seta caminhar para o proximo menu

// faz a seta caminhar para o proximo menu

________________________________________________________________________ 37/49

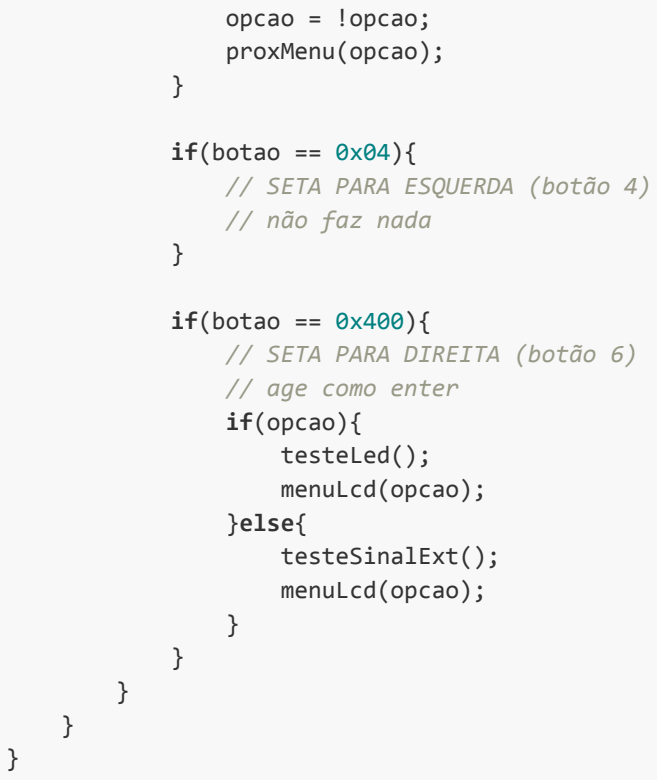
[picture p20: figure]
opcao = !opcao; proxMenu(opcao);; if(botao == 0x04){ // SETA PARA ESQUERDA (botão 4) // não faz nada; if(botao == 0x400){ // SETA PARA DIREITA (botão 6) // age como enter if(opcao){ testeLed(); menuLcd(opcao); }else{ testeSinalExt(); menuLcd(opcao);

### 9.2.2 adc.c

// -----------------------------------------------------------------------// Copyright (C) Rodrigo Almeida 2010
// -----------------------------------------------------------------------
// | Arquivo: adc.c
// | | Biblioteca do conversor AD para o PIC18F4520
// | Autor: | Rodrigo Maximiano Antunes de Almeida
// | | rodrigomax at unifei.edu.br
// | Licença: GNU GPL 2
// -----------------------------------------------------------------------
// | This program is free software; you can redistribute it and/or modify
// | it under the terms of the GNU General Public License as published by
// | the Free Software Foundation; version 2 of the License.
//
// | This program is distributed in the hope that it will be useful,
// | but WITHOUT ANY WARRANTY; without even the implied warranty of
// | MERCHANTABILITY or FITNESS FOR A PARTICULAR PURPOSE. See the
// | GNU General Public License for more details.
// -----------------------------------------------------------------------

#include "adc.h"

#include <pic18f4520.h>

#include "io.h"

________________________________________________________________________ 38/49

#include "bits.h"

void adcInit(void) {
//AN0-A0, AN1-A1 e AN2-A2 são analógicos e entradas pinMode(PIN_A0, INPUT);
pinMode(PIN_A1, INPUT);
//temperatura compartilhado com Display //removido da biblioteca
// pinMode(PIN_A2, INPUT);

bitSet(ADCON0, 0); //liga ADC
//config an0-2 como analógico
//ADCON1 = 0b00001100; //apenas AN0 é analogico, a referencia é baseada na fonte ADCON2 = 0b10101010; //FOSC /32, 12 TAD, Alinhamento à direita e tempo de conv =

### 12 TAD

}

int adcRead(unsigned int channel) {
unsigned int ADvalor;
ADCON0 &= 0b11000011; //zera os bits do canal if (channel < 3) {
ADCON0 |= channel << 2;
}

ADCON0 |= 0b00000010; //inicia conversao

while (bitTst(ADCON0, 1)); // espera terminar a conversão;

ADvalor = ADRESH; // le o resultado
ADvalor <<= 8;
ADvalor += ADRESL;
return ADvalor;
}

### 9.2.3 bits.h

#ifndef BIT_H

#define | BIT_H

//funções de bit
#define bitSet(arg,bit) ((arg) |= (1<<(bit))) #define bitClr(arg,bit) ((arg) &= ~(1<<(bit))) #define bitFlp(arg,bit) ((arg) ^= (1<<(bit))) #define bitTst(arg,bit) ((arg) & (1<<(bit)))

#endif /* XC_HEADER_TEMPLATE_H */

________________________________________________________________________ 39/49

### 9.2.4 io.c

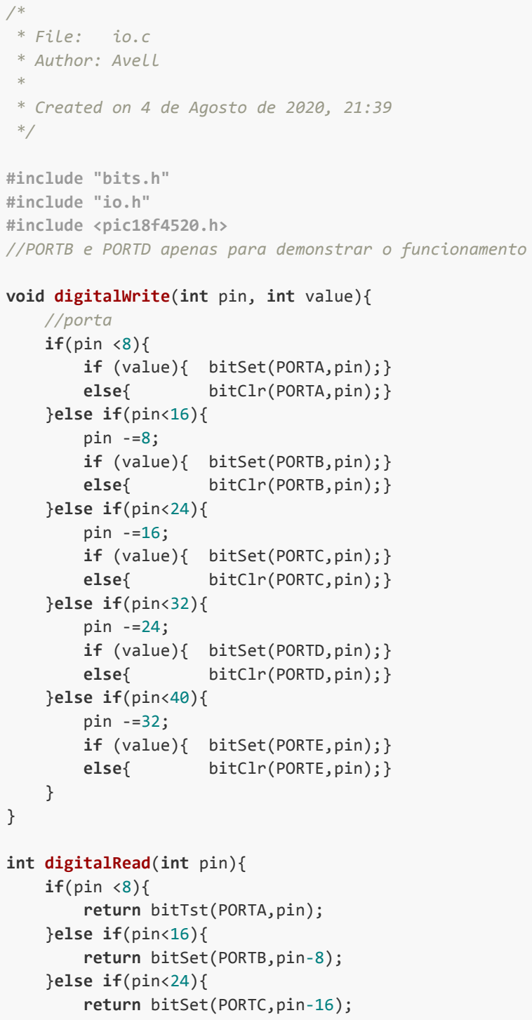
[picture p21: figure]
* File:; * Author: Avell * * Created on 4 de Agosto de 2020, 21:39 */; #include "bits.h" #include "io.h" #include <pic18f4520.h>; void digitalWrite(int pin, int value){ //porta if(pin <8){ if (value){ bitSet(PORTA,pin);}; else{; bitClr(PORTA,pin);}; }else if(pin<16){ pin -=8; if (value){ bitSet(PORTB,pin);}; bitClr(PORTB,pin);}; }else if(pin<24){ pin -=16; if (value){ bitSet(PORTC,pin);}; bitClr(PORTC,pin);}; }else if(pin<32){ pin -=24; if (value){ bitSet(PORTD,pin);}; bitClr(PORTD,pin);}; }else if(pin<40){ pin -=32; if (value){ bitSet(PORTE,pin);}; bitClr(PORTE,pin);}; int digitalRead(int pin){ if(pin <8){ return bitTst(PORTA,pin); }else if(pin<16){ return bitSet(PORTB,pin-8); }else if(pin<24){ return bitSet(PORTC,pin-16);

//PORTB e PORTD apenas para demonstrar o funcionamento

________________________________________________________________________ 40/49

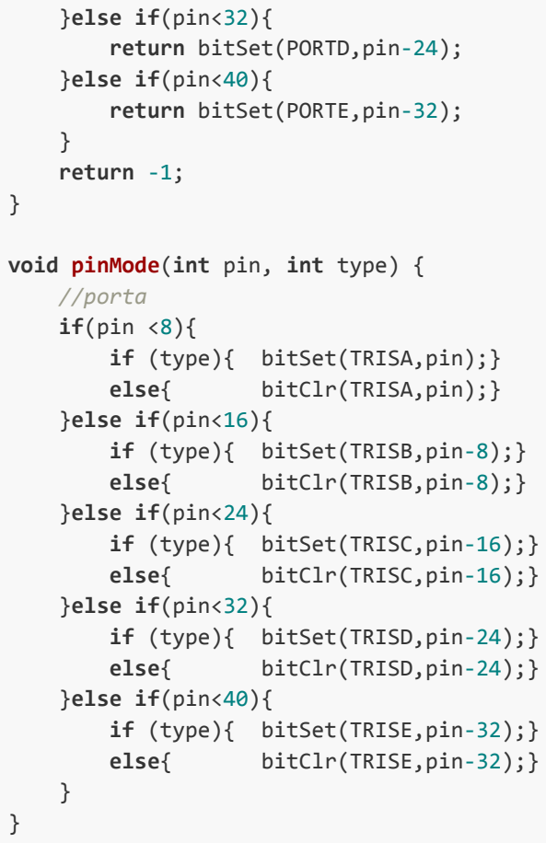
[picture p22: figure]
}else if(pin<32){ return bitSet(PORTD,pin-24); }else if(pin<40){ return bitSet(PORTE,pin-32);; } return -1;; void pinMode(int pin, int type) { //porta if(pin <8){ if (type){ bitSet(TRISA,pin);}; else{; bitClr(TRISA,pin);}; }else if(pin<16){ if (type){ bitSet(TRISB,pin-8);}; bitClr(TRISB,pin-8);}; }else if(pin<24){ if (type){ bitSet(TRISC,pin-16);}; bitClr(TRISC,pin-16);}; }else if(pin<32){ if (type){ bitSet(TRISD,pin-24);}; bitClr(TRISD,pin-24);}; }else if(pin<40){ if (type){ bitSet(TRISE,pin-32);}; bitClr(TRISE,pin-32);}

### 9.2.5 keypad.c

// -----------------------------------------------------------------------// Copyright (C) Rodrigo Almeida 2014
// -----------------------------------------------------------------------
// | Arquivo: keypad.c
// | | Biblioteca de operação de um teclado matricial
// | Autor: | Rodrigo Maximiano Antunes de Almeida
// | | rodrigomax at unifei.edu.br
// | Licença: GNU GPL 2
// -----------------------------------------------------------------------
// | This program is free software; you can redistribute it and/or modify
// | it under the terms of the GNU General Public License as published by
// | the Free Software Foundation; version 2 of the License.
//
// | This program is distributed in the hope that it will be useful,
// | but WITHOUT ANY WARRANTY; without even the implied warranty of
// | MERCHANTABILITY or FITNESS FOR A PARTICULAR PURPOSE. See the
// | GNU General Public License for more details.
// -----------------------------------------------------------------------
________________________________________________________________________ 41/49

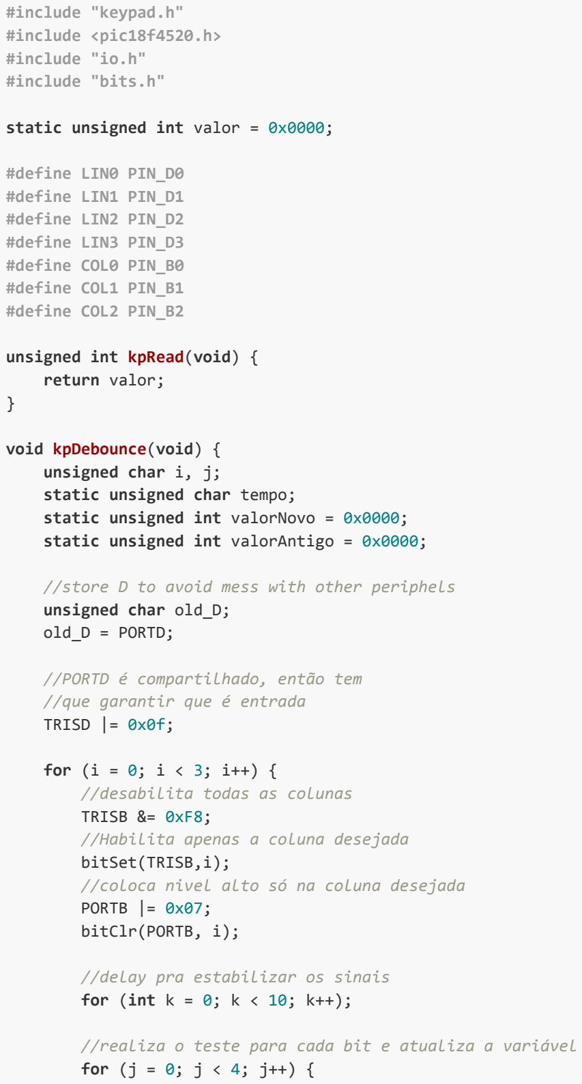
[picture p23: figure]
#include "keypad.h" #include <pic18f4520.h> #include "io.h" #include "bits.h"; static unsigned int valor = 0x0000;; #define LIN0 PIN_D0 #define LIN1 PIN_D1 #define LIN2 PIN_D2 #define LIN3 PIN_D3 #define COL0 PIN_B0 #define COL1 PIN_B1 #define COL2 PIN_B2; unsigned int kpRead(void) { return valor;; void kpDebounce(void) { unsigned char i, j; static unsigned char tempo; static unsigned int valorNovo = 0x0000;; unsigned char old_D; old_D = PORTD;; //PORTD é compartilhado, então tem //que garantir que é entrada TRISD |= 0x0f;; for (i = 0; i < 3; i++) { //desabilita todas as colunas TRISB &= 0xF8; //Habilita apenas a coluna desejada bitSet(TRISB,i);; PORTB |= 0x07; bitClr(PORTB, i);; //delay pra estabilizar os sinais for (int k = 0; k < 10; k++);; for (j = 0; j < 4; j++) {

static unsigned int valorAntigo = 0x0000;

//store D to avoid mess with other periphels

//coloca nivel alto só na coluna desejada

//realiza o teste para cada bit e atualiza a variável

________________________________________________________________________ 42/49

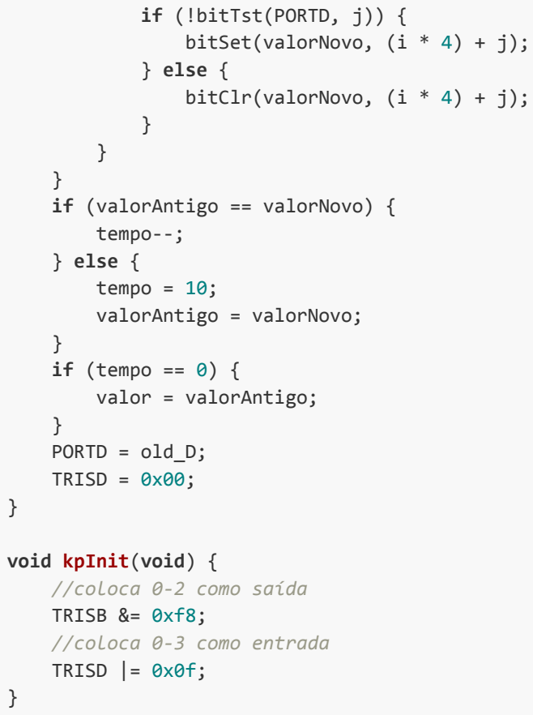
[picture p24: figure]
if (!bitTst(PORTD, j)) { bitSet(valorNovo, (i * 4) + j); } else { bitClr(valorNovo, (i * 4) + j);; } if (valorAntigo == valorNovo) { tempo--; } else { tempo = 10; valorAntigo = valorNovo;; } if (tempo == 0) { valor = valorAntigo;; } PORTD = old_D; TRISD = 0x00;; void kpInit(void) { //coloca 0-2 como saída TRISB &= 0xf8; //coloca 0-3 como entrada TRISD |= 0x0f;

### 9.2.6 lcd.c

Biblioteca alterada para comunicação com 4 bits entre o microcontrolador e o display.

// -----------------------------------------------------------------------
// Copyright (C) Rodrigo Almeida 2010
// -----------------------------------------------------------------------
// | Arquivo: lcd.c
// | | Biblioteca de manipulação do LCD
// | Autor: | Rodrigo Maximiano Antunes de Almeida
// | | rodrigomax at unifei.edu.br
// | Licença: GNU GPL 2
// -----------------------------------------------------------------------
// | This program is free software; you can redistribute it and/or modify
// | it under the terms of the GNU General Public License as published by
// | the Free Software Foundation; version 2 of the License.
//
// | This program is distributed in the hope that it will be useful,
// | but WITHOUT ANY WARRANTY; without even the implied warranty of
// | MERCHANTABILITY or FITNESS FOR A PARTICULAR PURPOSE. See the
// | GNU General Public License for more details.
// -----------------------------------------------------------------------
________________________________________________________________________ 43/49

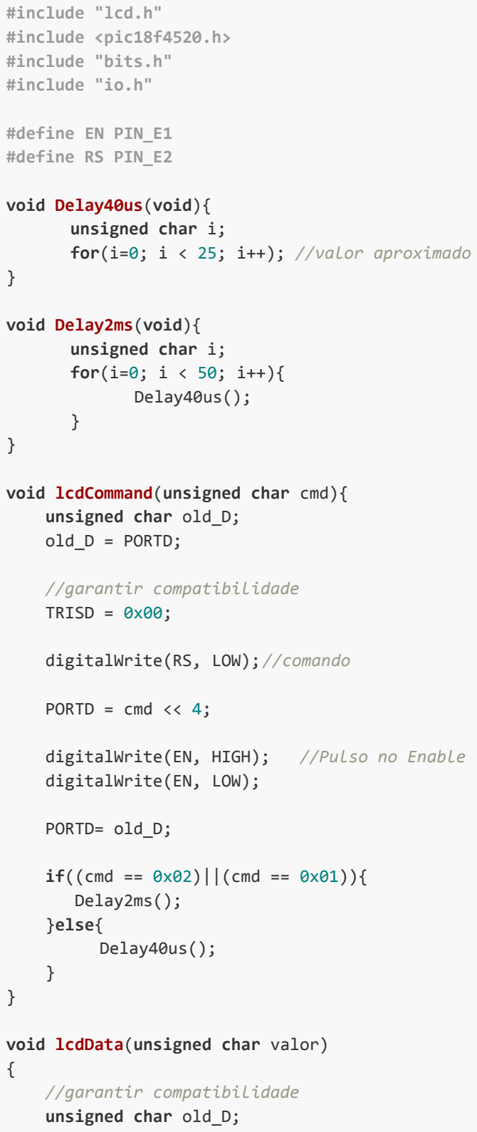
[picture p25: figure]
#include "lcd.h" #include <pic18f4520.h> #include "bits.h" #include "io.h"; #define EN PIN_E1 #define RS PIN_E2; void Delay40us(void){ unsigned char i;; void Delay2ms(void){ unsigned char i; for(i=0; i < 50; i++){ Delay40us();; void lcdCommand(unsigned char cmd){ unsigned char old_D; old_D = PORTD;; //garantir compatibilidade TRISD = 0x00;; digitalWrite(RS, LOW);//comando; PORTD = cmd << 4;; digitalWrite(EN, LOW);; PORTD= old_D;; if((cmd == 0x02)||(cmd == 0x01)){ Delay2ms(); }else{ Delay40us();; void lcdData(unsigned char valor) {; //garantir compatibilidade unsigned char old_D;

for(i=0; i < 25; i++); //valor aproximado

digitalWrite(EN, HIGH); //Pulso no Enable

________________________________________________________________________ 44/49

old_D = PORTD;

TRISD = 0x00;
digitalWrite(RS, HIGH); //comando

PORTD = valor;

digitalWrite(EN, HIGH); //Pulso no Enable digitalWrite(EN, LOW);

PORTD = valor << 4;

digitalWrite(EN, HIGH); //Pulso no Enable digitalWrite(EN, LOW);

PORTD = old_D;

Delay40us();
}

void lcdInit(void){
// configurações de direção dos terminais pinMode(RS, OUTPUT);
pinMode(EN, OUTPUT);
TRISD = 0x00; | //dados

// garante inicialização do LCD (+-10ms)
Delay2ms(); Delay2ms(); Delay2ms(); Delay2ms(); Delay2ms();

//precisa enviar 4x pra garantir 4 bits
// 0 0 1 0 1 0 0 0
lcdCommand(0x03); | // 8 bits
Delay2ms(); | Delay2ms();
lcdCommand(0x03); | // 8 bits
Delay2ms();
lcdCommand(0x03); | // 8 bits
lcdCommand(0x02); | // 4 bits
lcdCommand(0x02); | // 4 bits
lcdCommand(0x08); | // 2 linhas, 5x8

lcdCommand(0x00);
lcdCommand(0x06); //modo incremental

//habilitar o cursor, trocar 0x0C por 0x0F; lcdCommand(0x00);
lcdCommand(0x0C); //display e cursor on, com blink

________________________________________________________________________ 45/49

lcdCommand(0x00);
lcdCommand(0x01); //limpar display }

## 9.3 Lista de compras

Relação tabular a conter a identificação do item (1, 2, 3, etc), a identificação do item na PCI (R1, C10, etc), a identificação do fabricante (partnumber), a quantidade necessária, um fornecedor e o preço por unidade (em dólar norte-americano).

ID | Identificação na PCI | Part number | Qtd | Fornecedor | Preço un. (USD)
1 | IC2 | LPC1114FBD48/302 | 1 | Future Electronics | 3.24
2 | IC1 | MCP7940N–I/SN | 1 | Mouser Electronics | 0.86
3 | U3 | MCP2200–I/SO | 1 | Microchip | 2.47
4 | U4 | MCP4725A0T-E/CH | 1 | Mouser Electronics | 1.29
5 | R19 | 0 ohm SMD 0805 | 1 | Mouser Electronics | 0.10
6 | R8, R21, R22 | 100 ohm SMD 0805 | 3 | Mouser Electronics | 0.10
7 | R3, R4, R13, R14, R15, R16 | 110 ohm SMD 0805 | 6 | Mouser Electronics | 0.10
8 | R18 | 150 ohm SMD 0805 | 1 | Mouser Electronics | 0.10
9 | R5, R6, R7, R9, R10, R11, R12, R17 | 1k ohm SMD 0805 | 8 | Mouser Electronics | 0.10
10 | R1, R2, R20 | 10k ohm SMD 0805 | 3 | Mouser Electronics | 0.10
11 | C9, C10 | 18 pF SMD 0805 | 2 | Mouser Electronics | 0.11
12 | C1, C2, C22, C23 | 22 pF SMD 0805 | 4 | Mouser Electronics | 0.10
13 | C3, C6, C11, C12, C13, C14, C15, C16, C17, C20, C21 | 100 nF SMD 0805 | 11 | Mouser Electronics | 0.10
14 | C19 | 0.1 uF SMD 0805 | 1 | Mouser Electronics | 0.10
15 | C18 | 10 uF SMD 0805 | 1 | Mouser Electronics | 0.12
16 | C4, C5. C7, C8 | 710-865090368008 | 4 | Mouser Electronics | 0,31
17 | J1 | PJ–002A | 1 | Mouser Electronics | 0.77
18 | LED1, LED2, LED3, LED4, LED5, LED6 | LTST–C150GKT | 6 | Digi-Key | 0.31

________________________________________________________________________ 46/49

19 | IC3 | LM358DR/LM358DG | 1 | Mouser Electronics | 0.37
20 | J8 | 897–43–004–90–000000 | 1 | Mouser Electronics | 1.70
21 | S1, S2, S3, S4, S5, S6 | 1825910–6 | 6 | TE Connectivity | 0.20
22 | U1 | LD1117AS33TR (3.3V) | 1 | Mouser Electronics | 0.90
23 | U2 | LD1117AS50TR (5V) | 1 | Mouser Electronics | 0.67
24 | Y1 | AB38T–32.768KHZ | 1 | Mouser Electronics | 0.17
25 | Y2 | ATS20A | 1 | Mouser Electronics | 0.36
26 | Y3 | ATS12A | 1 | Mouser Electronics | 0.36
27 | J7, J9 | OSTTA024163 | 2 | Digi-Key | 0.73
28 | J4, J10, J11 | PPTC101LFBN-RC | 3 | Digi-Key | 0.65
29 | D1 | 1N5819HW–7 | 1 | Mouser Electronics | 0.45
30 | J5 | JHD162A | 1 | My Techno Care | 2.30
31 | J6 | 70246-1002 | 1 | Digi-Key | 2.63
32 | JP1 | M20-9990546 | 1 | Mouser Electronics | 0.25

________________________________________________________________________ 47/49

## 10 Bibliografia

- Folhas de dados dos componentes

________________________________________________________________________ 48/49

## 11 Anexo

Em anexo seguem as folhas de rosto das folhas de dados referentes aos componentes utilizados.

________________________________________________________________________ 49/49

### 1. General description

The LPC1110/11/12/13/14/15 are an ARM Cortex-M0 based, low-cost 32-bit MCU family, designed for 8/16-bit microcontroller applications, offering performance, low power, simple instruction set and memory addressing together with reduced code size compared to existing 8/16-bit architectures.

The LPC1110/11/12/13/14/15 operate at CPU frequencies of up to 50 MHz.

The peripheral complement of the LPC1110/11/12/13/14/15 includes up to 64 kB of flash memory, up to 8 kB of data memory, one Fast-mode Plus I²C-bus interface, one RS-485/EIA-485 UART, up to two SPI interfaces with SSP features, four general purpose counter/timers, a 10-bit ADC, and up to 42 general purpose I/O pins.

Remark: The LPC111x series consists of the LPC1100 series (parts LPC111x/101/201/301), LPC1100L series (parts LPC111x/002/102/202/302), and the LPC1100XL series (parts LPC111x/103/203/303/323/333). The LPC1100L and LPC1100XL series include the power profiles, a windowed watchdog timer, and a configurable open-drain mode.

For related documentation, see Section 16 “References”.

### 2. Features and benefits

■ System:
- ARM Cortex-M0 processor, running at frequencies of up to 50 MHz.
- ARM Cortex-M0 built-in Nested Vectored Interrupt Controller (NVIC).
- Non-Maskable Interrupt (NMI) input selectable from several input sources (LPC1100XL series only).
- Serial Wire Debug.
- System tick timer.
■ Memory:
- 64 kB (LPC1115), 56 kB (LPC1114/333), 48 kB (LPC1114/323), 32 kB (LPC1114/102/201/202/203/301/302/303), 24 kB (LPC1113), 16 kB (LPC1112), 8 kB (LPC1111), or 4 kB (LPC1110) on-chip flash programming memory.
- 256 byte page erase function (LPC1100XL series only)
- 8 kB, 4 kB, 2 kB, or 1 kB SRAM.
- In-System Programming (ISP) and In-Application Programming (IAP) via on-chip bootloader software.

# LPC1110/11/12/13/14/15

32-bit ARM Cortex-M0 microcontroller; up to 64 kB flash and

### 8 kB SRAM

Rev. 9.2 — 26 March 2014 | Product data sheet

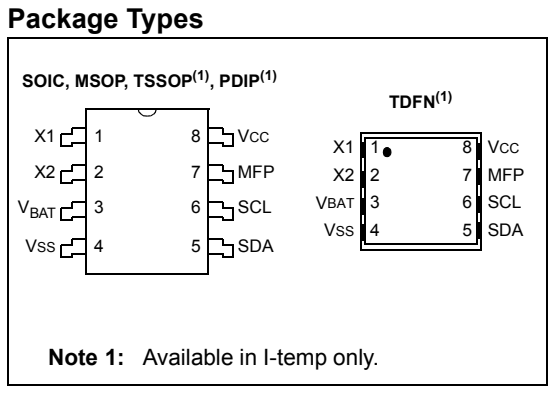
[picture p26: figure]
Package Types; SOIC, MSOP, TSSOP⁽¹⁾, PDIP⁽¹⁾; VBAT; VSS; VCC; MFP; SCL; SDA; TDFN⁽¹⁾; SCL 6; Note 1: Available in I-temp only.

ã 2010-2014 Microchip Technology Inc. | DS20005010F-page 1

# MCP7940N

Timekeeping Features:
- Real-Time Clock/Calendar (RTCC):
- Hours, Minutes, Seconds, Day of Week, Day, Month, Year
- Leap year compensated to 2399
- 12/24 hour modes
- Oscillator for 32.768 kHz Crystals:
- Optimized for 6-9 pF crystals
- On-Chip Digital Trimming/Calibration:
- ±1 PPM resolution
- ±129 PPM range
- Dual Programmable Alarms
- Versatile Output Pin:
- Clock output with selectable frequency
- Alarm output
- General purpose output
- Power-Fail Time-Stamp:
- Time logged on switchover to and from Battery mode
Low-Power Features:
- Wide Voltage Range:
- Operating voltage range of 1.8V to 5.5V
- Backup voltage range of 1.3V to 5.5V
- Low Typical Timekeeping Current:
- Operating from VCC: 1.2 µA at 3.3V
- Operating from battery backup: 925 nA at 3.0V
- Automatic Switchover to Battery Backup
User Memory:
- 64-byte Battery-Backed SRAM

Operating Ranges:
- 2-Wire Serial Interface, I²C™ Compatible -I²C clock rate up to 400 kHz
- Temperature Range:
- Industrial (I): -40°C to +85°C
- Extended (E): -40°C to +125°C
Packages:
- 8-Lead SOIC, MSOP, TSSOP, PDIP and 2x3
TDFN
General Description:
The MCP7940N Real-Time Clock/Calendar (RTCC) tracks time using internal counters for hours, minutes, seconds, days, months, years, and day of week. Alarms can be configured on all counters up to and including months. For usage and configuration, the MCP7940N supports I²C communications up to 400 kHz.
The open-drain, multi-functional output can be configured to assert on an alarm match, to output a selectable frequency square wave, or as a general purpose output.
The MCP7940N is designed to operate using a 32.768 kHz tuning fork crystal with external crystal load capacitors. On-chip digital trimming can be used to adjust for frequency variance caused by crystal tolerance and temperature.
SRAM and timekeeping circuitry are powered from the back-up supply when main power is lost, allowing the device to maintain accurate time and the SRAM contents. The times when the device switches over to the back-up supply and when primary power returns are both logged by the power-fail time-stamp.

### Battery-Backed I² C™ Real-Time Clock/Calendar with SRAM

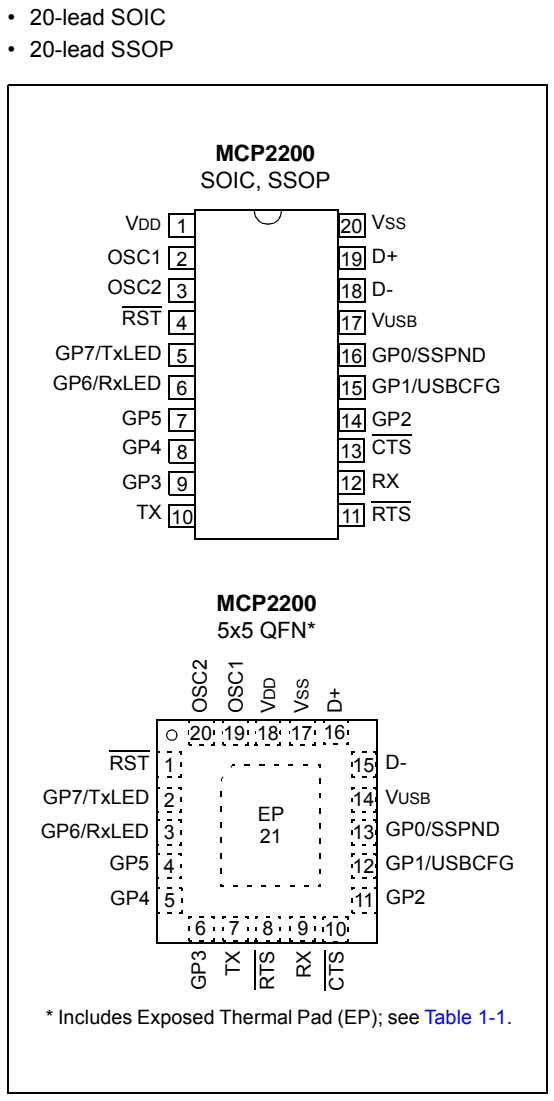
[picture p27: figure]
• 20-lead SOIC • 20-lead SSOP; MCP2200 SOIC, SSOP; OSC2; OSC1; RST; VDD; VSS; VUSB; GP7/TxLED; GP0/SSPND; GP6/RxLED; GP1/USBCFG; MCP2200 5x5 QFN*; GP6/RxLED GP5; VUSB GP³ GP0/SSPND; RTS; CTS; RX RTS; GP2 CTS

ã 2011 Microchip Technology Inc. | DS22228B-page 1

# MCP2200

Features

Universal Serial Bus (USB)
- Supports full-speed USB (12 Mb/s)
- Implements USB protocol composite device:
- Communication Device Class (CDC) for communications and configuration
- Human Interface Device (HID) for I/O control
- 128-byte buffer to handle data throughput at any UART baud rate:
- 64-byte transmit
- 64-byte receive
- Fully configurable VID and PID assignments, and string descriptors
- Bus powered or self-powered
- USB 2.0 Compliant: TID 40001150
USB Driver and Software Support
- Uses standard Windows® drivers for Virtual Com Port (VCP): Windows XP (SP2 or later), Vista, 7
- Configuration utility for initial configuration Universal Asynchronous Receiver/Transmitter (UART)
- Responds to SET LINE CODING commands to dynamically change baud rates
- Supports baud rates: 300-1000k
- Hardware flow control
- UART signal polarity option
General Purpose Input/Output (GPIO) Pins
- Eight general purpose I/O pins
EEPROM
- 256 bytes of user EEPROM
Other
- USB activity LED outputs (TxLED and RxLED)
- SSPND output pin
- USBCFG output pin (indicates when the enumer-ation is completed)
- Operating voltage: 3.0-5.5V
- Oscillator input: 12 MHz
- ESD protection: > 4 kV HBM
- Industrial (I) Operating Temperature: -40°C to +85°C

Package Types

The device will be offered in the following packages:
- 20-lead QFN (5 x 5 mm)

* Includes Exposed Thermal Pad (EP); see Table 1-1.

## USB 2.0 to UART Protocol Converter with GPIO

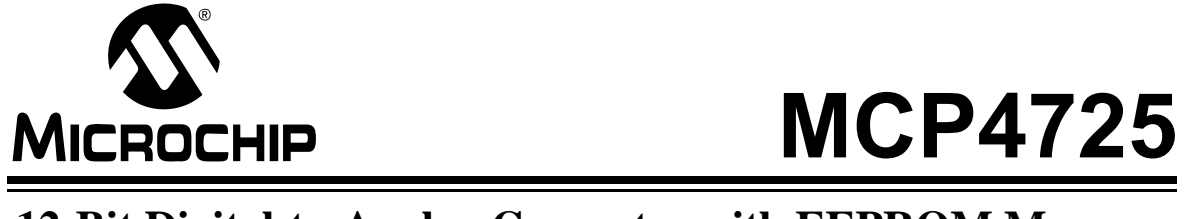
[picture p28: figure]
MCP4725

Features

- 12-Bit Resolution
- On-Board Non-Volatile Memory (EEPROM)
- ±0.2 LSB DNL (typical)
- External A0 Address Pin
- Normal or Power-Down Mode
- Fast Settling Time: 6 µs (typical)
- External Voltage Reference (VDD)
- Rail-to-Rail Output
- Low Power Consumption
- Single-Supply Operation: 2.7V to 5.5V •I²CTM Interface:
- Eight Available Addresses
- Standard (100 kbps), Fast (400 kbps), and High-Speed (3.4 Mbps) Modes
- Small 6-lead SOT-23 Package
- Extended Temperature Range: -40°C to +125°C
Applications
- Set Point or Offset Trimming
- Sensor Calibration
- Closed-Loop Servo Control

DESCRIPTION

The MCP4725 is a low-power, high accuracy, single channel, 12-bit buffered voltage output Digital-to-Analog Convertor (DAC) with non-volatile memory (EEPROM). Its on-board precision output amplifier allows it to achieve rail-to-rail analog output swing. The DAC input and configuration data can be programmed to the non-volatile memory (EEPROM) by the user using I²C interface command. The non-volatile memory feature enables the DAC device to hold the DAC input code during power-off time, and the DAC output is available immediately after power-up. This feature is very useful when the DAC device is used as a supporting device for other devices in the network. The device includes a Power-On-Reset (POR) circuit to ensure reliable power-up and an on-board charge pump for the EEPROM programming voltage. The DAC reference is driven from VDD directly. In power-down mode, the output amplifier can be configured to present a known low, medium, or high resistance output load.
The MCP4725 has an external A0 address bit selection pin. This A0 pin can be tied to VDD or VSS of the user’s application board.

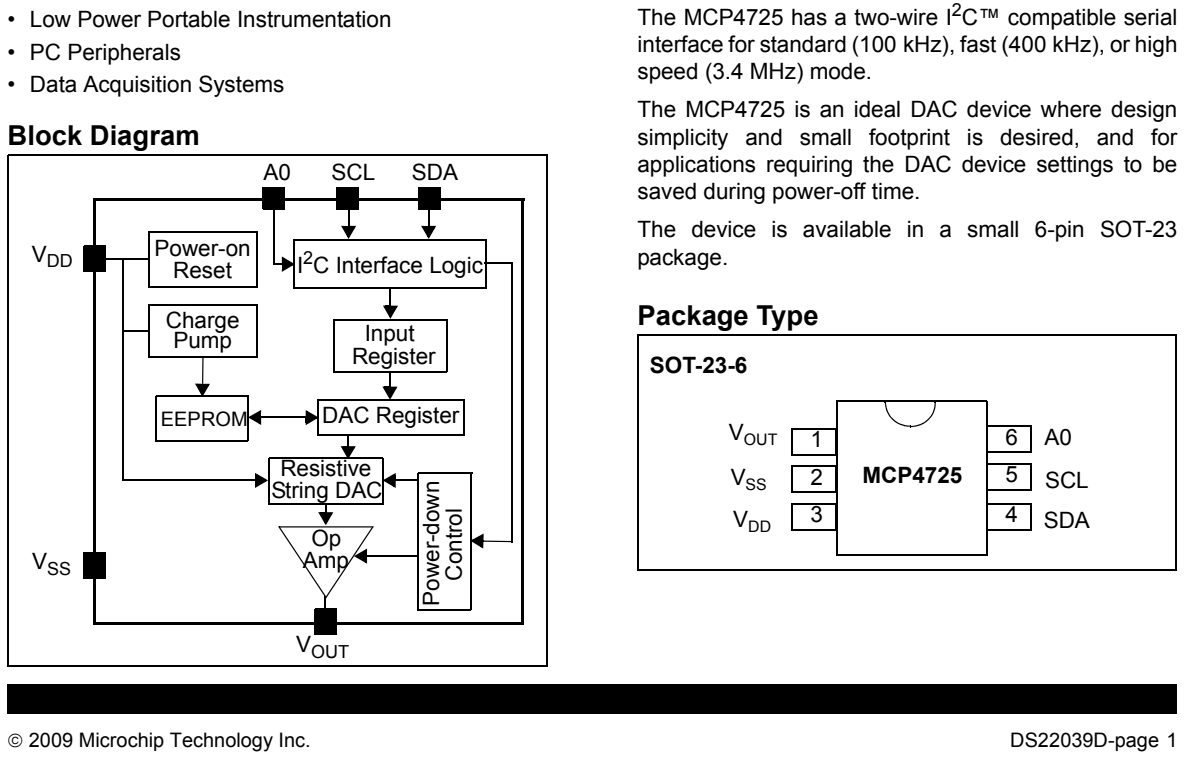
[picture p29: figure]
© 2009 Microchip Technology Inc.; DS22039D-page 1; • Low Power Portable Instrumentation • PC Peripherals • Data Acquisition Systems; Block Diagram; speed (3.4 MHz) mode.; saved during power-off time.; package.; Package Type; Resistive; Power-on Reset; Charge Pump; EEPROM; 2C Interface Logic; Input Register; DAC Register; Op Amp; Power-down Control; VDD; VSS; SCL; SDA; VOUT; String DAC; SOT-23-6; MCP4725

The MCP4725 has a two-wire I²C™ compatible serial interface for standard (100 kHz), fast (400 kHz), or high

The MCP4725 is an ideal DAC device where design simplicity and small footprint is desired, and for applications requiring the DAC device settings to be

The device is available in a small 6-pin SOT-23

## 12-Bit Digital-to-Analog Converter with EEPROM Memory in SOT-23-6

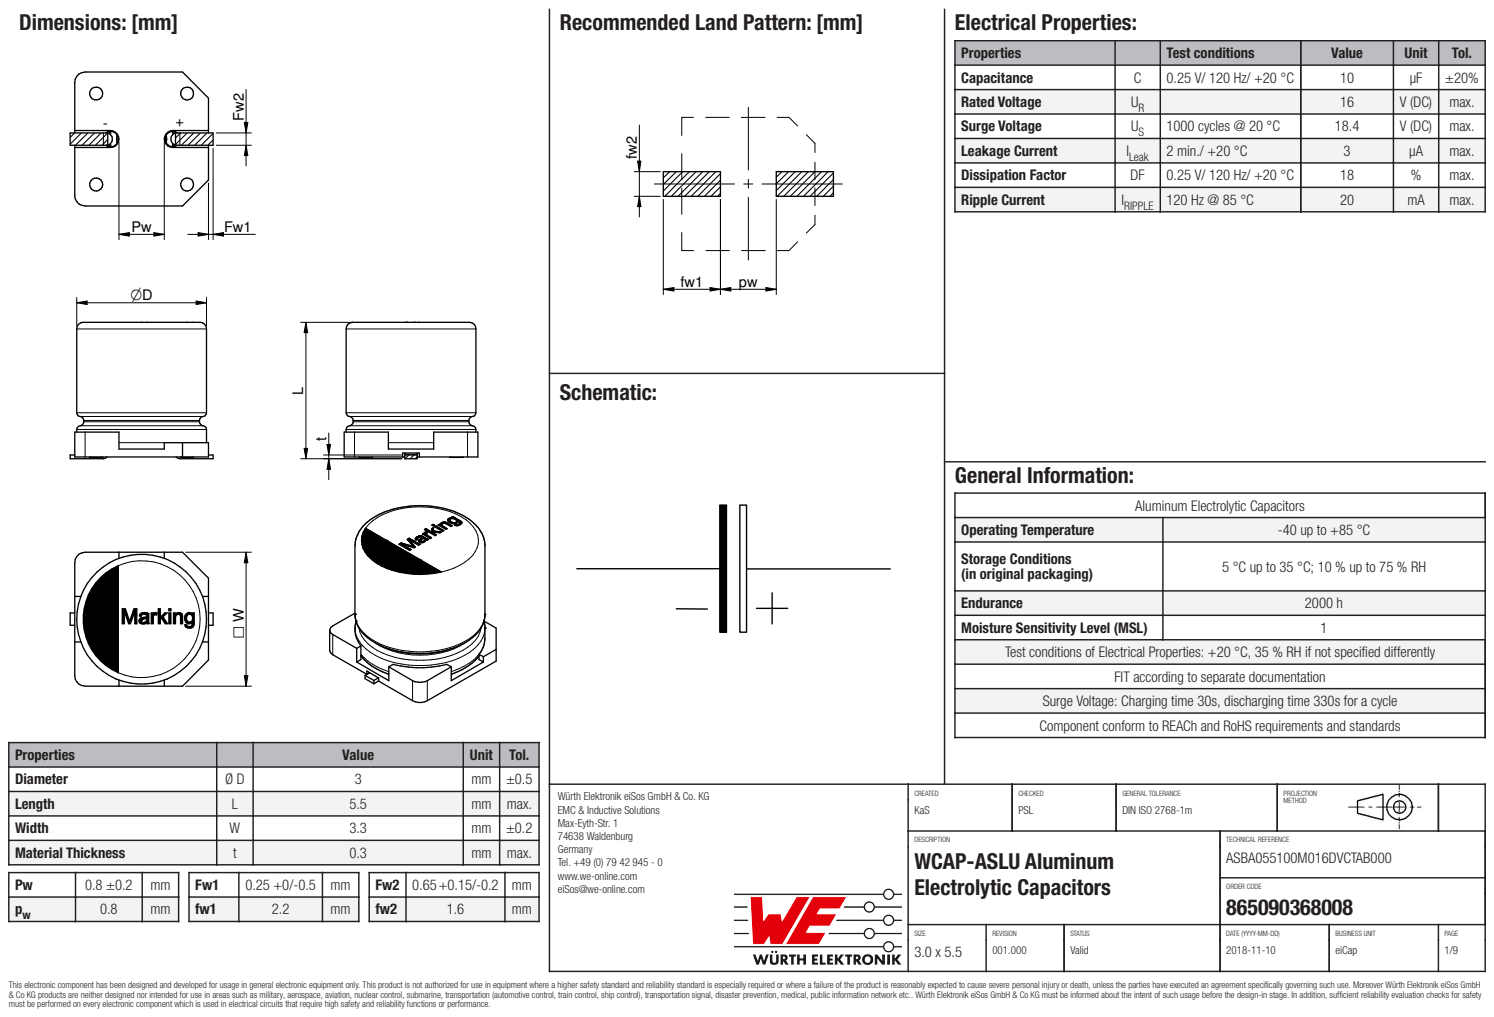
[picture p30: page 54]
Dimensions: [mm]; Fw1Fw²; Schematic:; Ripple Current; RIPPLE; max.; Electrical Properties:; General Information:; ORDER CODE 865090368008; SIZE; REVISION; STATUS; DATE (YYYY-MM-DD); BUSINESS UNIT; PAGE; Valid; eiCap

Recommended Land Pattern: [mm]

Properties | | Test conditions | Value | Unit | Tol.
Capacitance | C | 0.25 V/ 120 Hz/ +20 °C | 10 | µF | ±20%
Rated Voltage | UR | | 16 | V (DC) | max.
Surge Voltage | US | 1000 cycles @ 20 °C | 18.4 | V (DC) | max.
Leakage Current | I Leak | 2 min./ +20 °C | 3 | µA | max.
Dissipation Factor | DF | 0.25 V/ 120 Hz/ +20 °C | 18 | % | max.

Aluminum Electrolytic Capacitors

Operating Temperature | -40 up to +85 °C

Storage Conditions (in original packaging) | 5 °C up to 35 °C; 10 % up to 75 % RH

Endurance | 2000 h
Moisture Sensitivity Level (MSL) | 1

Test conditions of Electrical Properties: +20 °C, 35 % RH if not specified differently

FIT according to separate documentation

Surge Voltage: Charging time 30s, discharging time 330s for a cycle
Component conform to REACh and RoHS requirements and standards

Properties | | Value | Unit | Tol.
Diameter | Ø D | 3 | mm | ±0.5
Length | L | 5.5 | mm | max.
Width | W | 3.3 | mm | ±0.2
Material Thickness | t | 0.3 | mm | max.

Würth Elektronik eiSos GmbH & Co. KG EMC & Inductive Solutions Max-Eyth-Str. 1 74638 Waldenburg Germany Tel. +49 (0) 79 42 945 - 0 www.we-online.com eiSos@we-online.com | CREATED KaS | CHECKED PSL | GENERAL TOLERANCE DIN ISO 2768-1m | PROJECTION METHOD

DESCRIPTION WCAP-ASLU Aluminum Electrolytic Capacitors | TECHNICAL REFERENCE ASBA055100M016DVCTAB000

This electronic component has been designed and developed for usage in general electronic equipment only. This product is not authorized for use in equipment where a higher safety standard and reliability standard is especially required or where a failure of the product is reasonably expected to cause severe personal injury or death, unless the parties have executed an agreement specifically governing such use. Moreover Würth Elektronik eiSos GmbH
& Co KG products are neither designed nor intended for use in areas such as military, aerospace, aviation, nuclear control, submarine, transportation (automotive control, train control, ship control), transportation signal, disaster prevention, medical, public information network etc.. Würth Elektronik eiSos GmbH & Co KG must be informed about the intent of such usage before the design-in stage. In addition, sufficient reliability evaluation checks for safety
must be performed on every electronic component which is used in electrical circuits that require high safety and reliability functions or performance.

## Headers

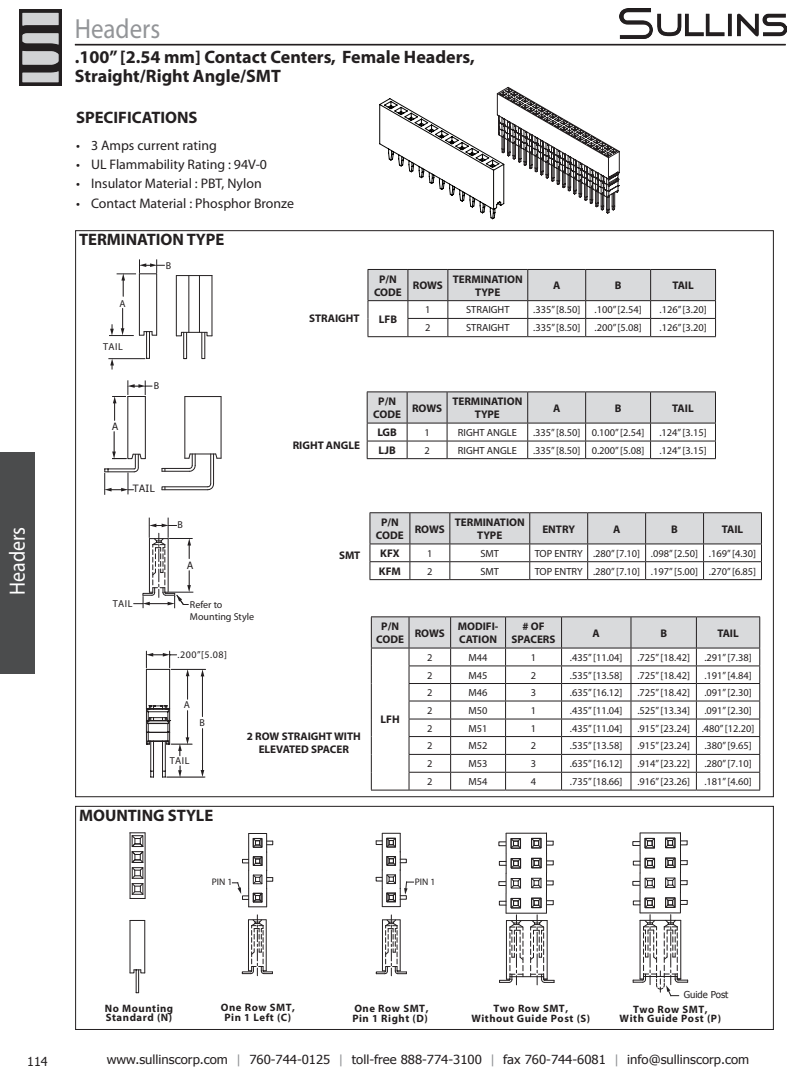
[picture p31: page 55]
www.sullinscorp.com | 760-744-0125 | toll-free 888-774-3100 | fax 760-744-6081 | info@sullinscorp.com; Headers; STRAIGHT; RIGHT ANGLE; SMT; TAIL; Refer to Mounting Style; MOUNTING STYLE; Without Guide Post (S); Two Row SMT,; Guide Post; PIN 1

.100” [2.54 mm] Contact Centers, Female Headers,
Straight/Right Angle/SMT
SPECIFICATIONS
• 3 Amps current rating
• UL Flammability Rating : 94V-0
• Insulator Material : PBT, Nylon
• Contact Material : Phosphor Bronze
TERMINATION TYPE

CODE P/N | ROWS | TERMINATION TYPE | A | B | TAIL

LFB | 1 | STRAIGHT | .335”[8.50] | .100”[2.54] | .126”[3.20]

2 | STRAIGHT | .335”[8.50] | .200”[5.08] | .126”[3.20]

LGB | 1 | RIGHT ANGLE | .335” [8.50] | 0.100” [2.54] | .124” [3.15]
LJB | 2 | RIGHT ANGLE | .335” [8.50] | 0.200” [5.08] | .124” [3.15]

CODE P/N | ROWS | TERMINATION TYPE | ENTRY | A | B | TAIL

KFX | 1 | SMT | TOP ENTRY | .280” [7.10] | .098” [2.50] | .169” [4.30]
KFM | 2 | SMT | TOP ENTRY | .280” [7.10] | .197” [5.00] | .270” [6.85]

CODE P/N | ROWS | MODIFI-CATION | # OF SPACERS | A | B | TAIL

LFH | 2 | M44 | 1 | .435” [11.04] | .725” [18.42] | .291” [7.38]

2 | M45 | 2 | .535” [13.58] | .725” [18.42] | .191” [4.84]
2 | M46 | 3 | .635” [16.12] | .725” [18.42] | .091” [2.30]
2 | M50 | 1 | .435” [11.04] | .525” [13.34] | .091” [2.30]
2 | M51 | 1 | .435” [11.04] | .915” [23.24] | .480” [12.20]
2 | M52 | 2 | .535” [13.58] | .915” [23.24] | .380” [9.65]
2 | M53 | 3 | .635” [16.12] | .914” [23.22] | .280” [7.10]
2 | M54 | 4 | .735” [18.66] | .916” [23.26] | .181” [4.60]

2 ROW STRAIGHT WITH
ELEVATED SPACER

Pin 1 Left (C) No Mounting
Standard (N)

One Row SMT,

Pin 1 Right (D)

Two Row SMT,

With Guide Post (P)

### MODEL: PJ-002A │ DESCRIPTION: DC POWER JACK

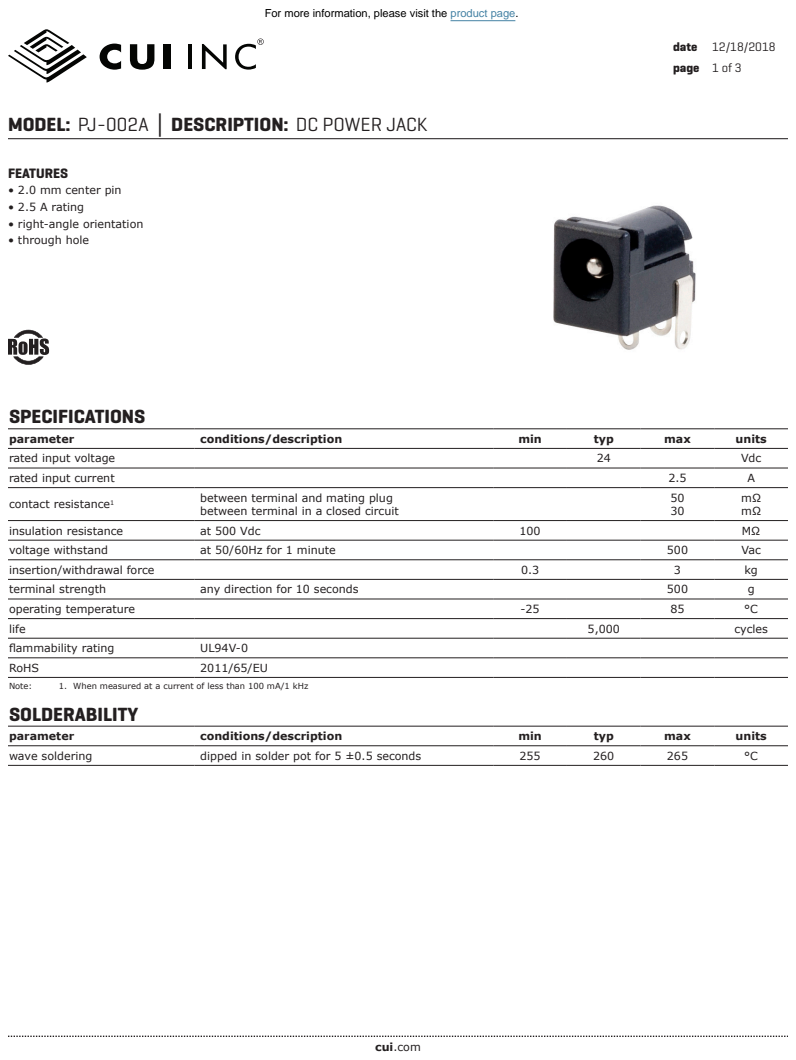
[picture p32: page 56]
date 12/18/2018 page 1 of 3; cui.com; SPECIFICATIONS; parameter; conditions/description; min; typ; max; units; rated input voltage; Vdc; rated input current; contact resistance¹; between terminal and mating plug; insulation resistance; at 500 Vdc; voltage withstand; at 50/60Hz for 1 minute; Vac; insertion/withdrawal force; terminal strength; any direction for 10 seconds; operating temperature; life; cycles; flammability rating; RoHS; Note: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

For more information, please visit the product page.

FEATURES
• 2.0 mm center pin
• 2.5 A rating
• right-angle orientation
• through hole

between terminal in a closed circuit

## LITE-ON TECHNOLOGY CORPORATION

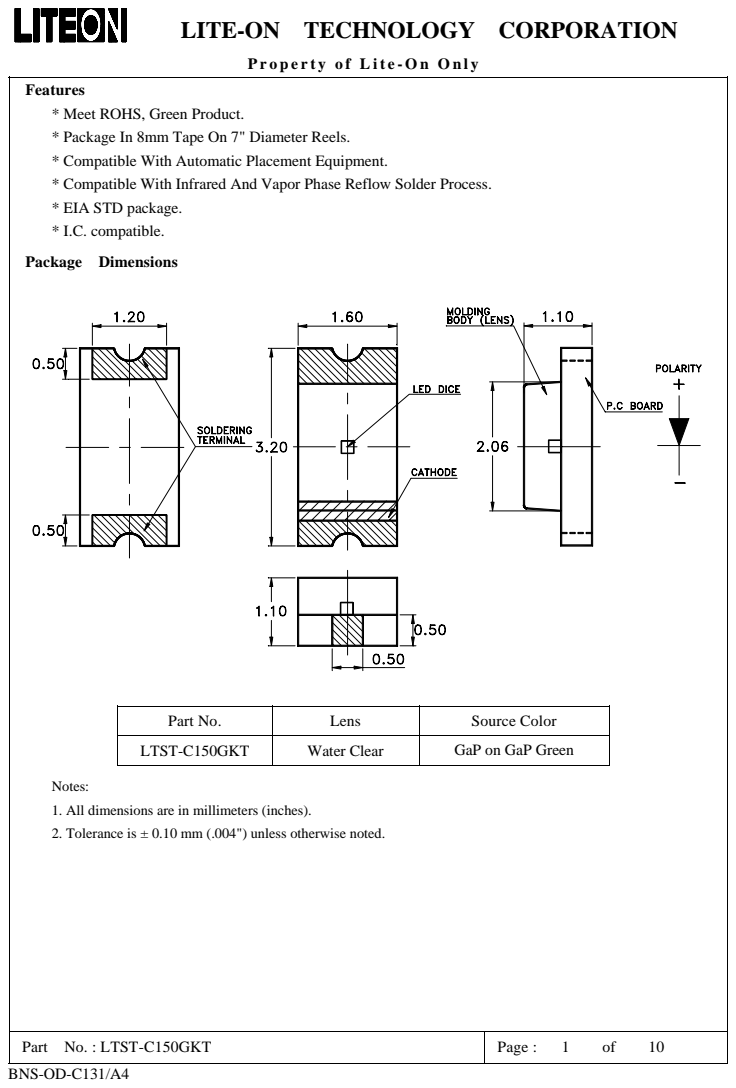
[picture p33: page 57]
Part No. : LTST-C150GKT; Page :; BNS-OD-C131/A4

Property of Lite-On Only

Features
* Meet ROHS, Green Product.
* Package In 8mm Tape On 7" Diameter Reels.
* Compatible With Automatic Placement Equipment.
* Compatible With Infrared And Vapor Phase Reflow Solder Process.
* EIA STD package.
* I.C. compatible.
Package Dimensions

Part No. | Lens | Source Color
LTST-C150GKT | Water Clear | GaP on GaP Green

Notes:
1. All dimensions are in millimeters (inches).
2. Tolerance is ± 0.10 mm (.004") unless otherwise noted.

### Industry-Standard Dual Operational Amplifiers

### 1 Features

- Wide supply range of 3 V to 36 V (B, BA versions)
- Quiescent current: 300 µA/ch (B, BA versions)
- Unity-gain bandwidth of 1.2 MHz (B, BA versions)
- Common-mode input voltage range includes ground, enabling direct sensing near ground
- 2-mV input offset voltage max. at 25°C (BA version)
- 3-mV input offset voltage max. at 25°C (A, B versions)
- Internal RF and EMI filter (B, BA versions)
- On products compliant to MIL-PRF-38535, all parameters are tested unless otherwise noted. On all other products, production processing does not necessarily include testing of all parameters.

### 2 Applications

- Merchant network and server power supply units
- Multi-function printers
- Power supplies and mobile chargers
- Motor control: AC induction, brushed DC, brushless DC, high-voltage, low-voltage, permanent magnet, and stepper motor
- Desktop PC and motherboard
- Indoor and outdoor air conditioners
- Washers, dryers, and refrigerators
- AC inverters, string inverters, central inverters, and voltage frequency drives
- Uninterruptible power supplies
- Electronic point-of-sale systems

### 3 Description

The LM358B and LM2904B devices are the next-generation versions of the industry-standard operational amplifiers (op amps) LM358 and LM2904, which include two high-voltage (36 V) op amps. These devices provide outstanding value for cost-sensitive applications, with features including low offset (300 µV, typical), common-mode input range to ground, and high differential input voltage capability. The LM358B and LM2904B op amps simplify circuit design with enhanced features such as unity-gain stability, lower offset voltage maximum of 3 mV (2 mV maximum for LM358BA and LM2904BA), and lower quiescent current of 300 µA per amplifier (typical). High ESD (2 kV, HBM) and integrated EMI and RF filters enable the LM358B and LM2904B devices to be used in the most rugged, environmentally challenging applications.
The LM358B and LM2904B amplifiers are available in micro-sized packaging, such as the SOT23-8, as well as industry standard packages including SOIC, TSSOP, and VSSOP.
Device Information
PART NUMBER⁽¹⁾ | PACKAGE | BODY SIZE (NOM)
LM358B, LM358BA, LM2904B, LM2904BA, LM358, LM358A, LM2904, LM2904V, LM258, LM258A | SOIC (8) | 4.90 mm × 3.90 mm
LM358B, LM358BA, LM2904B, LM2904BA, LM358, LM358A, LM2904, LM2490V | TSSOP (8) | 3.00 mm × 4.40 mm
LM358B, LM358BA, LM2904B, LM2904BA, LM358, LM358A, LM2904, LM2904V, LM258, LM258A | VSSOP (8) | 3.00 mm × 3.00 mm
LM358B, LM358BA, LM2904B, LM2904BA | SOT-23 (8) | 2.90 mm × 1.60 mm
LM358, LM2904 | SO (8) | 5.20 mm × 5.30 mm
LM358, LM2904, LM358A, LM258, LM258A | PDIP (8) | 9.81 mm × 6.35 mm
LM158, LM158A | CDIP (8) | 9.60 mm × 6.67 mm
LM158, LM158A | LCCC (20) | 8.89 mm × 8.89 mm

Family Comparison

Specification | LM358B LM358BA | LM2904B LM2904BA | LM358A LM358 | LM2904 | LM2904V LM2904AV | LM258 LM258A | LM158 LM158A | Units
Supply voltage | 3 to 36 | 3 to 36 | 3 to 30 | 3 to 26 | 3 to 30 | 3 to 30 | 3 to 30 | V
Offset voltage (max, 25°C) | ± 3 ± 2 | ± 3 ± 2 | ± 7 ± 3 | ± 7 | ± 7 ± 2 | ± 5 ± 3 | ± 5 ± 2 | mV
Input bias current (typ / max) | 10 / 35 | 10 / 35 | 20 / 250 15 / 100 | 20 / 250 | 20 / 250 | 20 / 150 15 / 80 | 20 / 150 15 / 50 | nA
Gain bandwidth product | 1.2 | 1.2 | 0.7 | 0.7 | 0.7 | 0.7 | 0.7 | MHz
Supply current (typ, per channel) | 0.3 | 0.3 | 0.35 | 0.35 | 0.35 | 0.35 | 0.35 | mA
ESD (HBM) | 2000 | 2000 | 500 | 500 | 500 | 500 | 500 | V
Operating ambient temperature | −40 to 85 | −40 to 125 | 0 to 70 | −40 to 125 | −40 to 125 | −25 to 85 | −55 to 125 | °C
(1) For all available packages, see the orderable addendum at the end of the data sheet.

SLOS068AA – JUNE 1976 – REVISED MARCH 2022

An IMPORTANT NOTICE at the end of this data sheet addresses availability, warranty, changes, use in safety-critical applications, intellectual property matters and other important disclaimers. PRODUCTION DATA.

Product Number: 897-43-004-90-000000

Description:
USB Socket
Type B
USB 2.0
Through Hole
Plating Code:
43
Shell Plating:
200 μ" Tin (matte finish) over 100 μ" Nickel
Inner Contact Plating:
30 μ" Gold over 50 μ" Nickel
# Of Pins | Qty. per Tube | Mill-Max Part Number | RoHS Compliant

4 | 150 | 897-43-004-90-000000

Certificate of Compliance: This is to Certify that the product described above is manufactured to Mill-Max quality standards in accordance with all applicable specifications and drawing. Mill-Max certifies this product to be free from defects of materials and workmanship.

This Certificate of Compliance covers the following requirements:

Dimensional (all features verified to be within tolerances described on the applicable drawing).
Raw Material (materials and properties verified to be as described on the applicable drawing).
Plating (platings as required, thickness verified, and performance including solderability per mil-standard). Performance (insertion extraction or other force requirements as described on the applicable drawing).

RoHS Compliance Statement for the restriction of lead, mercury, cadmium and hexavalent chromium PBB, PBDE, including Octa-BDE, Penta-BDE, Deca -BDE, in electronic equipment and use of PFOA
and PFOS in metal plating processes. Reference:
1. Directive 2002/95/EC of the European Parliament and of the Council of January 27 2003 on the restriction of the use of certain hazardous substances in electrical and electronic equipment.
2. Directive 2003/11/EC which amends Council Directive 76/769/EC to include pentabromodiphenyl ether and octabromodiphenyl ether.
3. Directive 2005/618/EC Commission decision of 18 August 2005 amending Directive 2002/95/EC. Establishes threshold limits for Lead, Mercury, Cadmium, Hexavalent Chromium, PBB, and PBDE.
4. Judgment of the Court (Grand Chamber) 1 April 2008, Directive 2002/95/EC-Electrical and electronic equipment -Decabromodiphenyl ether (Deca-BDE) Actions for annulment of exemption.
5. EU Directive 2006/122/EC of the European Parliament and of the Council of 12 December 2006, amending Council Directive 76/769/EEC on the restriction of Perfluorooctanoic Acid (PFOA) and Perfluorooctane Sulfanates (PFOS) used during metal plating processes.

Mill-Max Mfg. Corp. Datasheet — Last Modified 1/21/2018

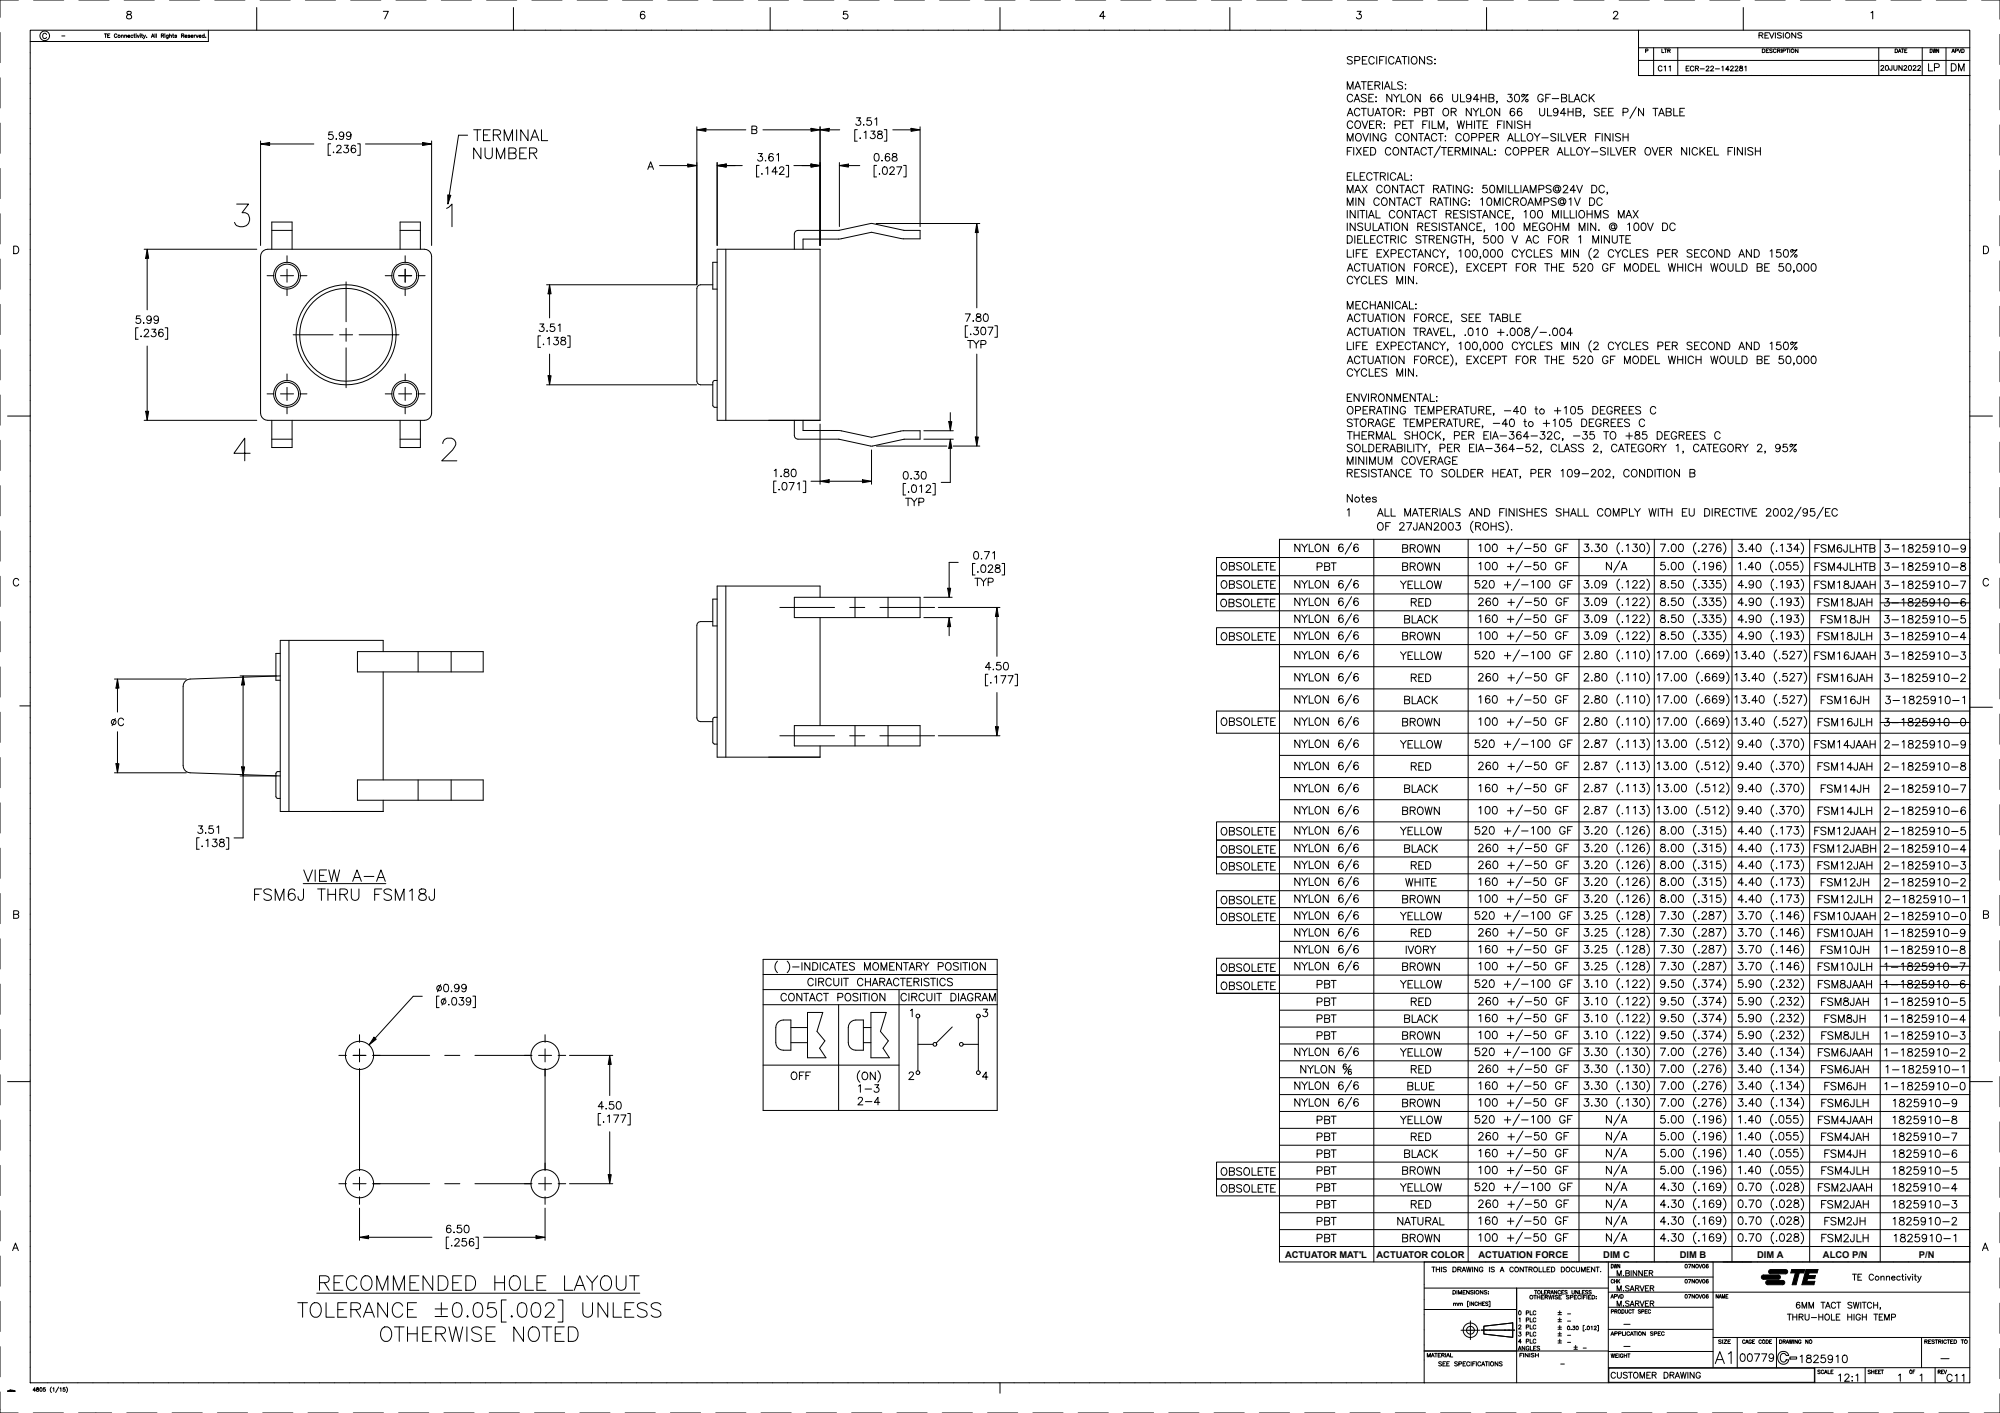
[picture p34: page 60]
ACTUATOR MAT'L; ACTUATOR COLOR; ACTUATION FORCE; DIM C; DIM B; DIM A; ALCO P/N

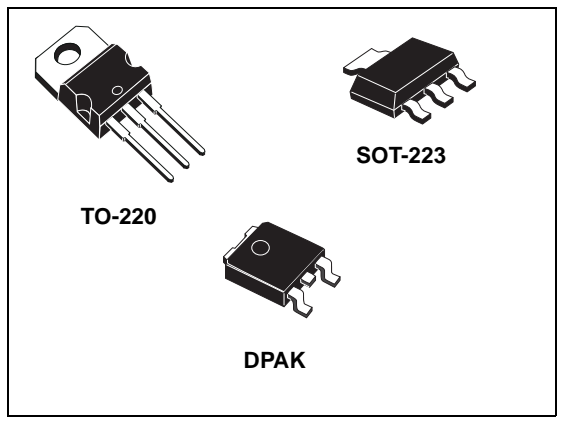
[picture p35: figure]
SOT-223; DPAK

This is information on a product in full production.

July 2013 | DocID7194 Rev 26 | 1/24

## LD1117A

Low drop fixed and adjustable positive voltage regulators

Datasheet - production data

Features

- Low dropout voltage:

– 1.15 V typ. @ IOUT = 1 A, 25 °C
- Very low quiescent current:

– 5 mA typ. @ 25 °C
- Output current up to 1 A
- Fixed output voltage of:

– 1.2 V, 1.8 V, 3.3 V
- Adjustable version availability (VREF = 1.25 V)
- Internal current and thermal limit
- Only 10 µF for stability
- Available in ± 2% (at 25 °C) and 4% in full temperature range
- High supply voltage rejection:

– 80 dB typ. (at 25 °C)
- Temperature range: 0 °C to 125 °C

Description

The LD1117A is a low drop voltage regulator able to provide up to 1 A of output current, available also in adjustable versions (VREF = 1.25 V). In fixed versions, the following output voltages are offered: 1.2 V, 1.8 V, and 3.3 V. The device is supplied in: SOT-223, DPAK and TO-220. Surface mounted packages optimize the thermal characteristics while offering a relevant space saving advantage. High efficiency is assured by an NPN pass transistor. Only a very common 10 µF minimum capacitor is needed for stability. Chip trimming allows the regulator to reach a very tight output voltage tolerance, within ± 2% at 25 °C.

Table 1. Device summary

Order codes | Output voltage
SOT-223 | DPAK | TO-220
LD1117AS12TR | LD1117ADT12TR | | 1.2 V
LD1117AS18TR | LD1117ADT18TR | | 1.8 V
LD1117AS33TR | LD1117ADT33TR | LD1117AV33 | 3.3 V
LD1117ASTR | LD1117ADT-TR | | Adjustable from 1.25 V

www.st.com

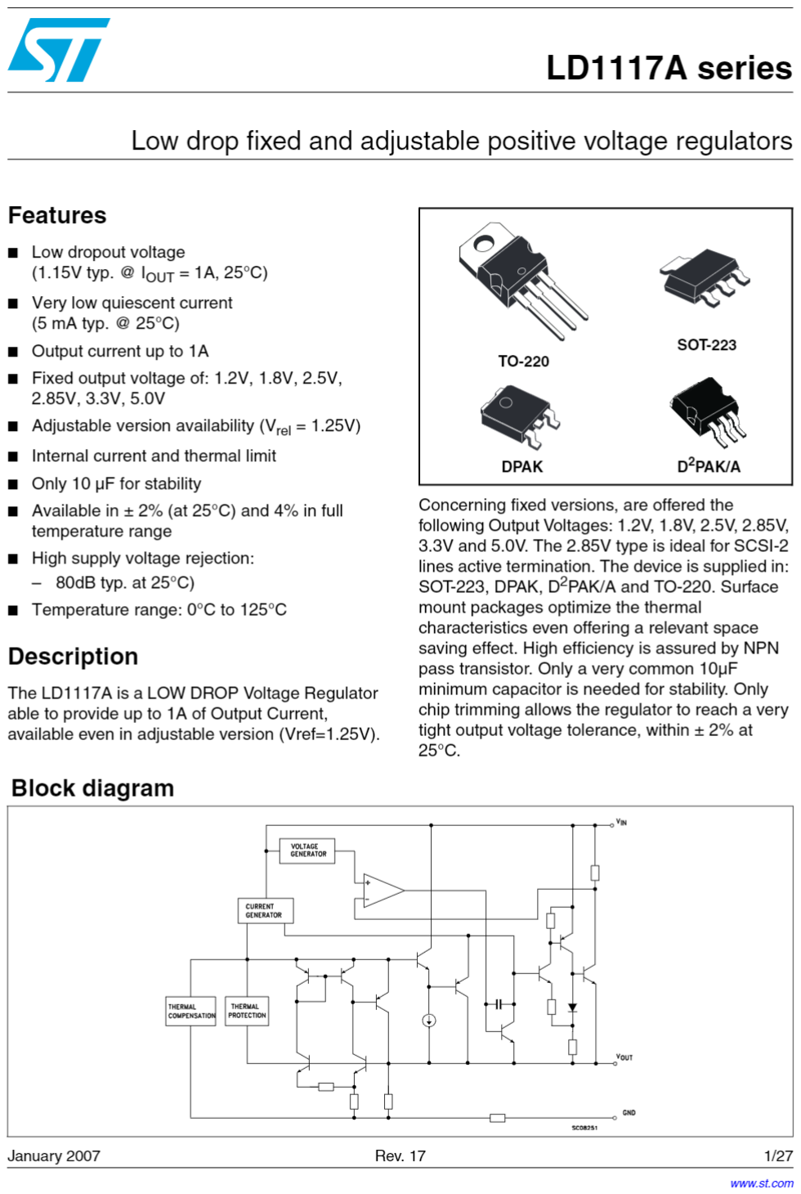
[picture p36: page 62]

## TUNING FORK CRYSTALS

# AB38T and AB26T

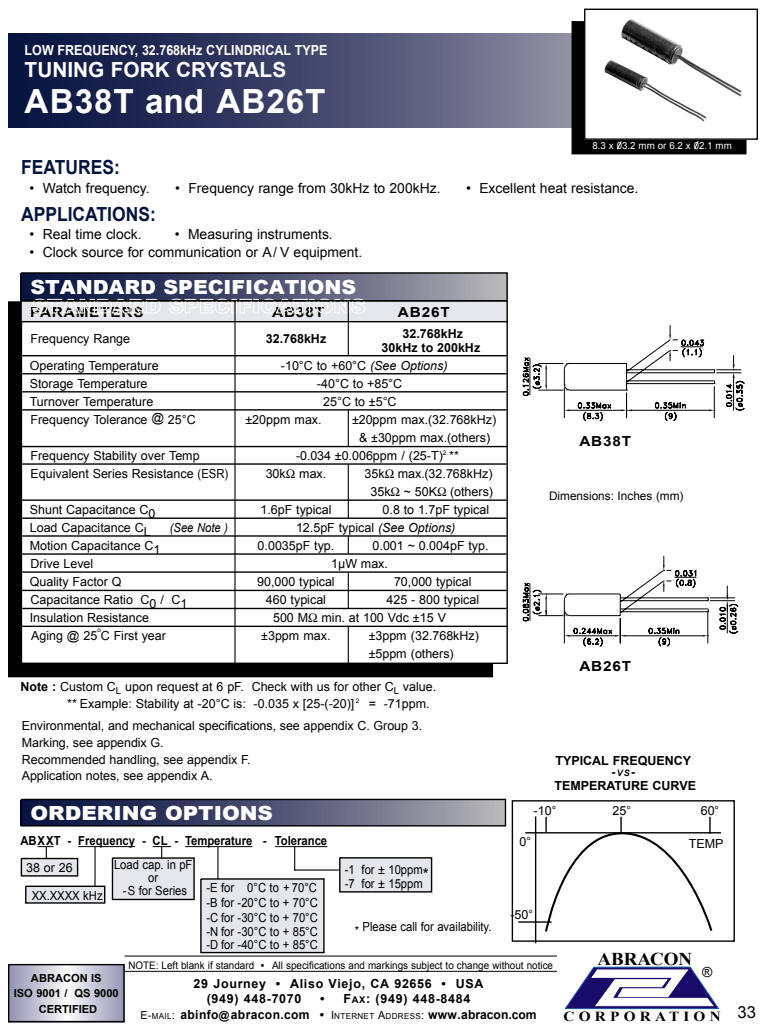
[picture p37: page 63]
FEATURES:; • Watch frequency.; • Frequency range from 30kHz to 200kHz.; • Excellent heat resistance.; -B for -20°C to + 70°C -C for -30°C to + 70°C -N for -30°C to + 85°C -D for -40°C to + 85°C; PARAMETERS; APPLICATIONS: • Real time clock.; • Measuring instruments.; TEMP; -1 for ± 10ppm* -7 for ± 15ppm; 32.768kHz Frequency Range; 32.768kHz; 30kHz to 200kHz; Operating Temperature; -10°C to +60°C (See Options); Storage Temperature; Turnover Temperature; Frequency Tolerance @ 25°C; ±20ppm max.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

LOW FREQUENCY, 32.768kHz CYLINDRICAL TYPE

• Clock source for communication or A/ V equipment.

Dimensions: Inches (mm)

Note : Custom CL upon request at 6 pF. Check with us for other CL value.
** Example: Stability at -20°C is: -0.035 x [25-(-20)] ² = -71ppm.
Environmental, and mechanical specifications, see appendix C. Group 3.
Marking, see appendix G.
Recommended handling, see appendix F.
Application notes, see appendix A.
ORDERING
ABXXT - Frequency - CL - Temperature - Tolerance
XX.XXXX kHz

TYPICAL FREQUENCY -VS-
TEMPERATURE CURVE

Load cap. in pF
-S for Series -E for 0°C to + 70°C

* Please call for availability.

29 Journey • Aliso Viejo, CA 92656 • USA
(949) 448-7070 • FAX: (949) 448-8484

E-MAIL: abinfo@abracon.com • INTERNET ADDRESS: www.abracon.com

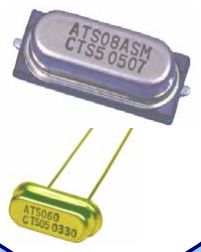
[picture p38: figure]
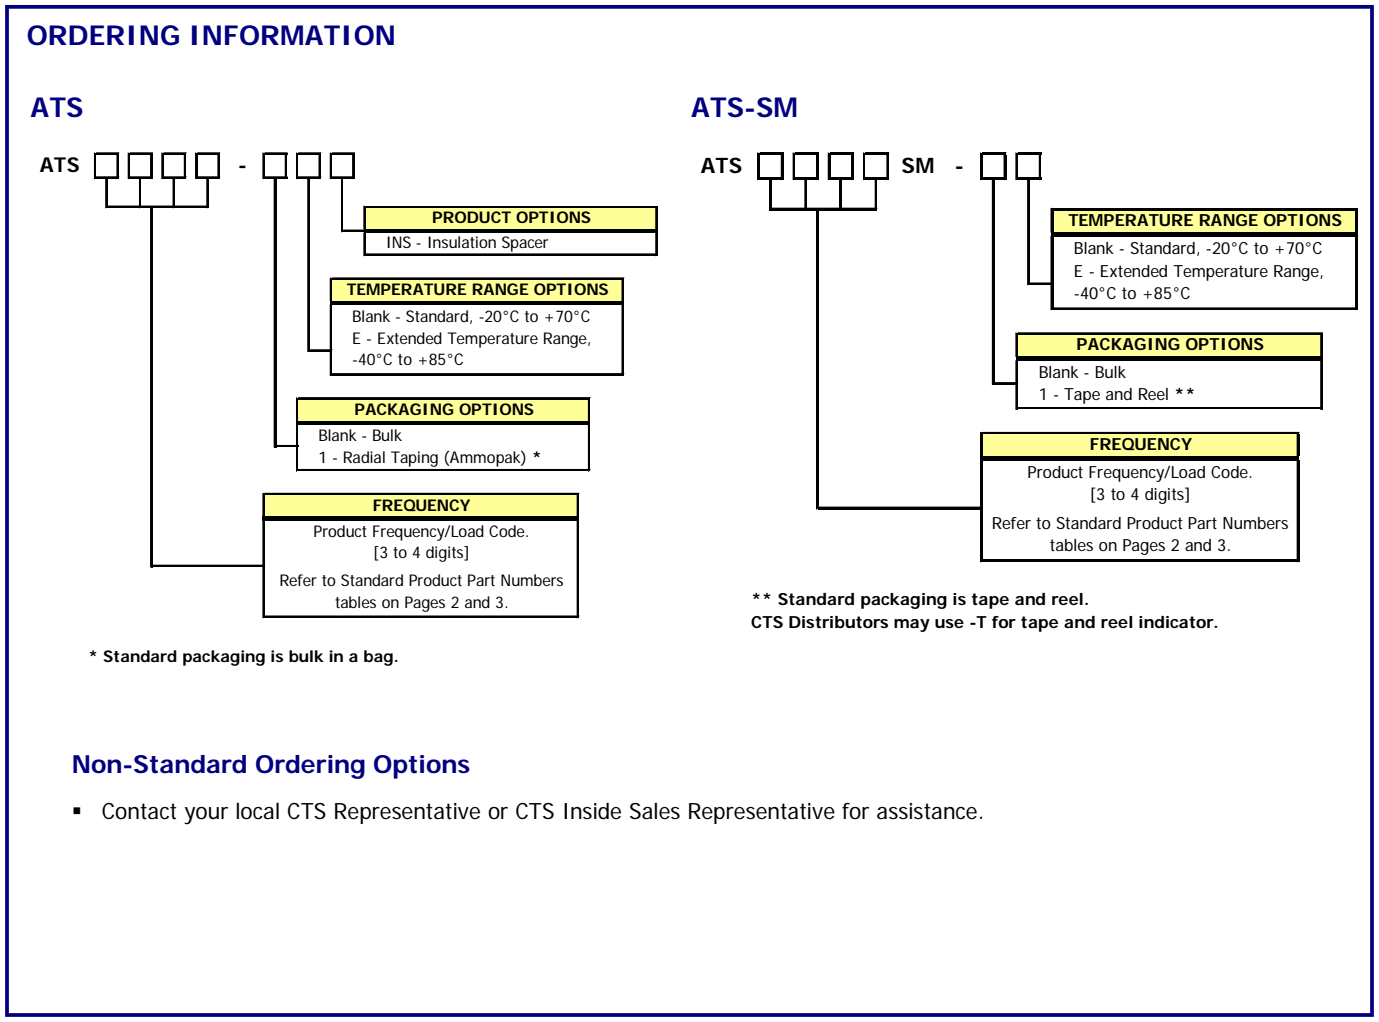
[picture p39: figure]
ORDERING INFORMATION; Non-Standard Ordering Options; ATS; Blank - Bulk 1 - Radial Taping (Ammopak) *; INS - Insulation Spacer; * Standard packaging is bulk in a bag.; TEMPERATURE RANGE OPTIONS Blank - Standard, -20°C to +70°C E - Extended Temperature Range, -40°C to +85°C; PACKAGING OPTIONS; Refer to Standard Product Part Numbers tables on Pages 2 and 3.; FREQUENCY Product Frequency/Load Code. [3 to 4 digits]; PRODUCT OPTIONS; ATS-SM; ** Standard packaging is tape and reel.; Blank - Standard, -20°C to +70°C E - Extended Temperature Range, -40°C to +85°C; TEMPERATURE RANGE OPTIONS; Blank - Bulk 1 - Tape and Reel **

Document No. 008-0309-0 | Page 1- 6 | Rev. L
www.ctscorp.com

# ATS/ATS-SM Series Quartz Crystal

FEATURES
- Standard HC-49/US [thru-hole] and HC-49/US-SM [surface mount] Packages
- Stable Frequency Over Temperature and Drive Level
- Fundamental and 3rd Overtone Crystals
- Frequency Range 3.2 – 64 MHz
- Frequency Tolerance, ±30 ppm Standard
- Frequency Stability, ±50 ppm Standard
- Operating Temperature, –20°C to +70°C Standard, -40°C to +85°C Available
- Tape & Reel Packaging Available
- RoHS/Green Compliant [6/6]

APPLICATIONS
The ATS/ATS-SM crystal series offers excellent long-term stability and reliability in a proven resistance-weld metal package. The excellent shock performance makes it suitable for microprocessor, telecommunication, industrial, consumer electronics and networking applications.

Contact your local CTS Representative or CTS Inside Sales Representative for assistance.

CTS Distributors may use -T for tape and reel indicator.

ORDERING INFORMATION; Non-Standard Ordering Options; ATS; Blank - Bulk 1 - Radial Taping (Ammopak) *; INS - Insulation Spacer; * Standard packaging is bulk in a bag.; TEMPERATURE RANGE OPTIONS Blank - Standard, -20°C to +70°C E - Extended Temperature Range, -40°C to +85°C; PACKAGING OPTIONS; Refer to Standard Product Part Numbers tables on Pages 2 and 3.; FREQUENCY Product Frequency/Load Code. [3 to 4 digits]; PRODUCT OPTIONS; ATS-SM; ** Standard packaging is tape and reel.; Blank - Standard, -20°C to +70°C E - Extended Temperature Range, -40°C to +85°C; TEMPERATURE RANGE OPTIONS; Blank - Bulk 1 - Tape and Reel **

Document No. 008-0309-0 | Page 1- 6 | Rev. L
www.ctscorp.com

# ATS/ATS-SM Series Quartz Crystal

FEATURES
- Standard HC-49/US [thru-hole] and HC-49/US-SM [surface mount] Packages
- Stable Frequency Over Temperature and Drive Level
- Fundamental and 3rd Overtone Crystals
- Frequency Range 3.2 – 64 MHz
- Frequency Tolerance, ±30 ppm Standard
- Frequency Stability, ±50 ppm Standard
- Operating Temperature, –20°C to +70°C Standard, -40°C to +85°C Available
- Tape & Reel Packaging Available
- RoHS/Green Compliant [6/6]

APPLICATIONS
The ATS/ATS-SM crystal series offers excellent long-term stability and reliability in a proven resistance-weld metal package. The excellent shock performance makes it suitable for microprocessor, telecommunication, industrial, consumer electronics and networking applications.

Contact your local CTS Representative or CTS Inside Sales Representative for assistance.

CTS Distributors may use -T for tape and reel indicator.

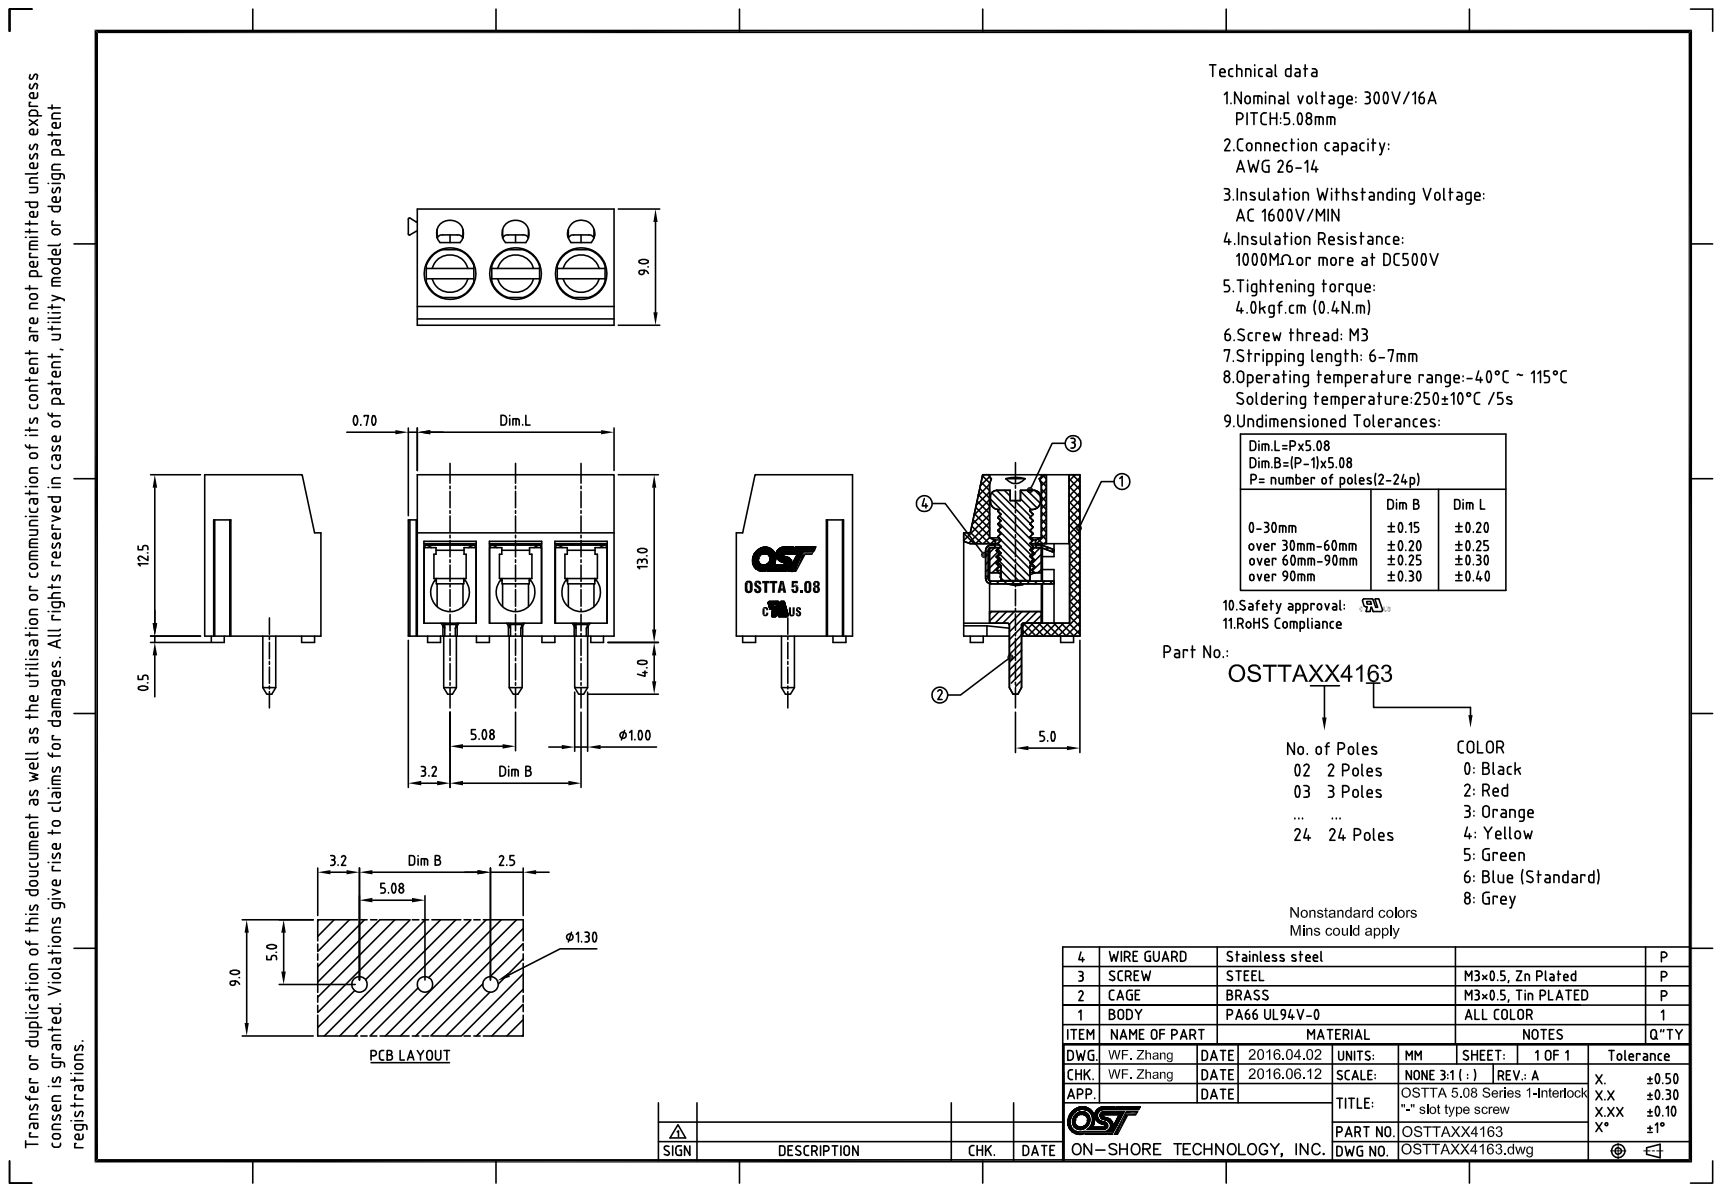
[picture p40: page 66]

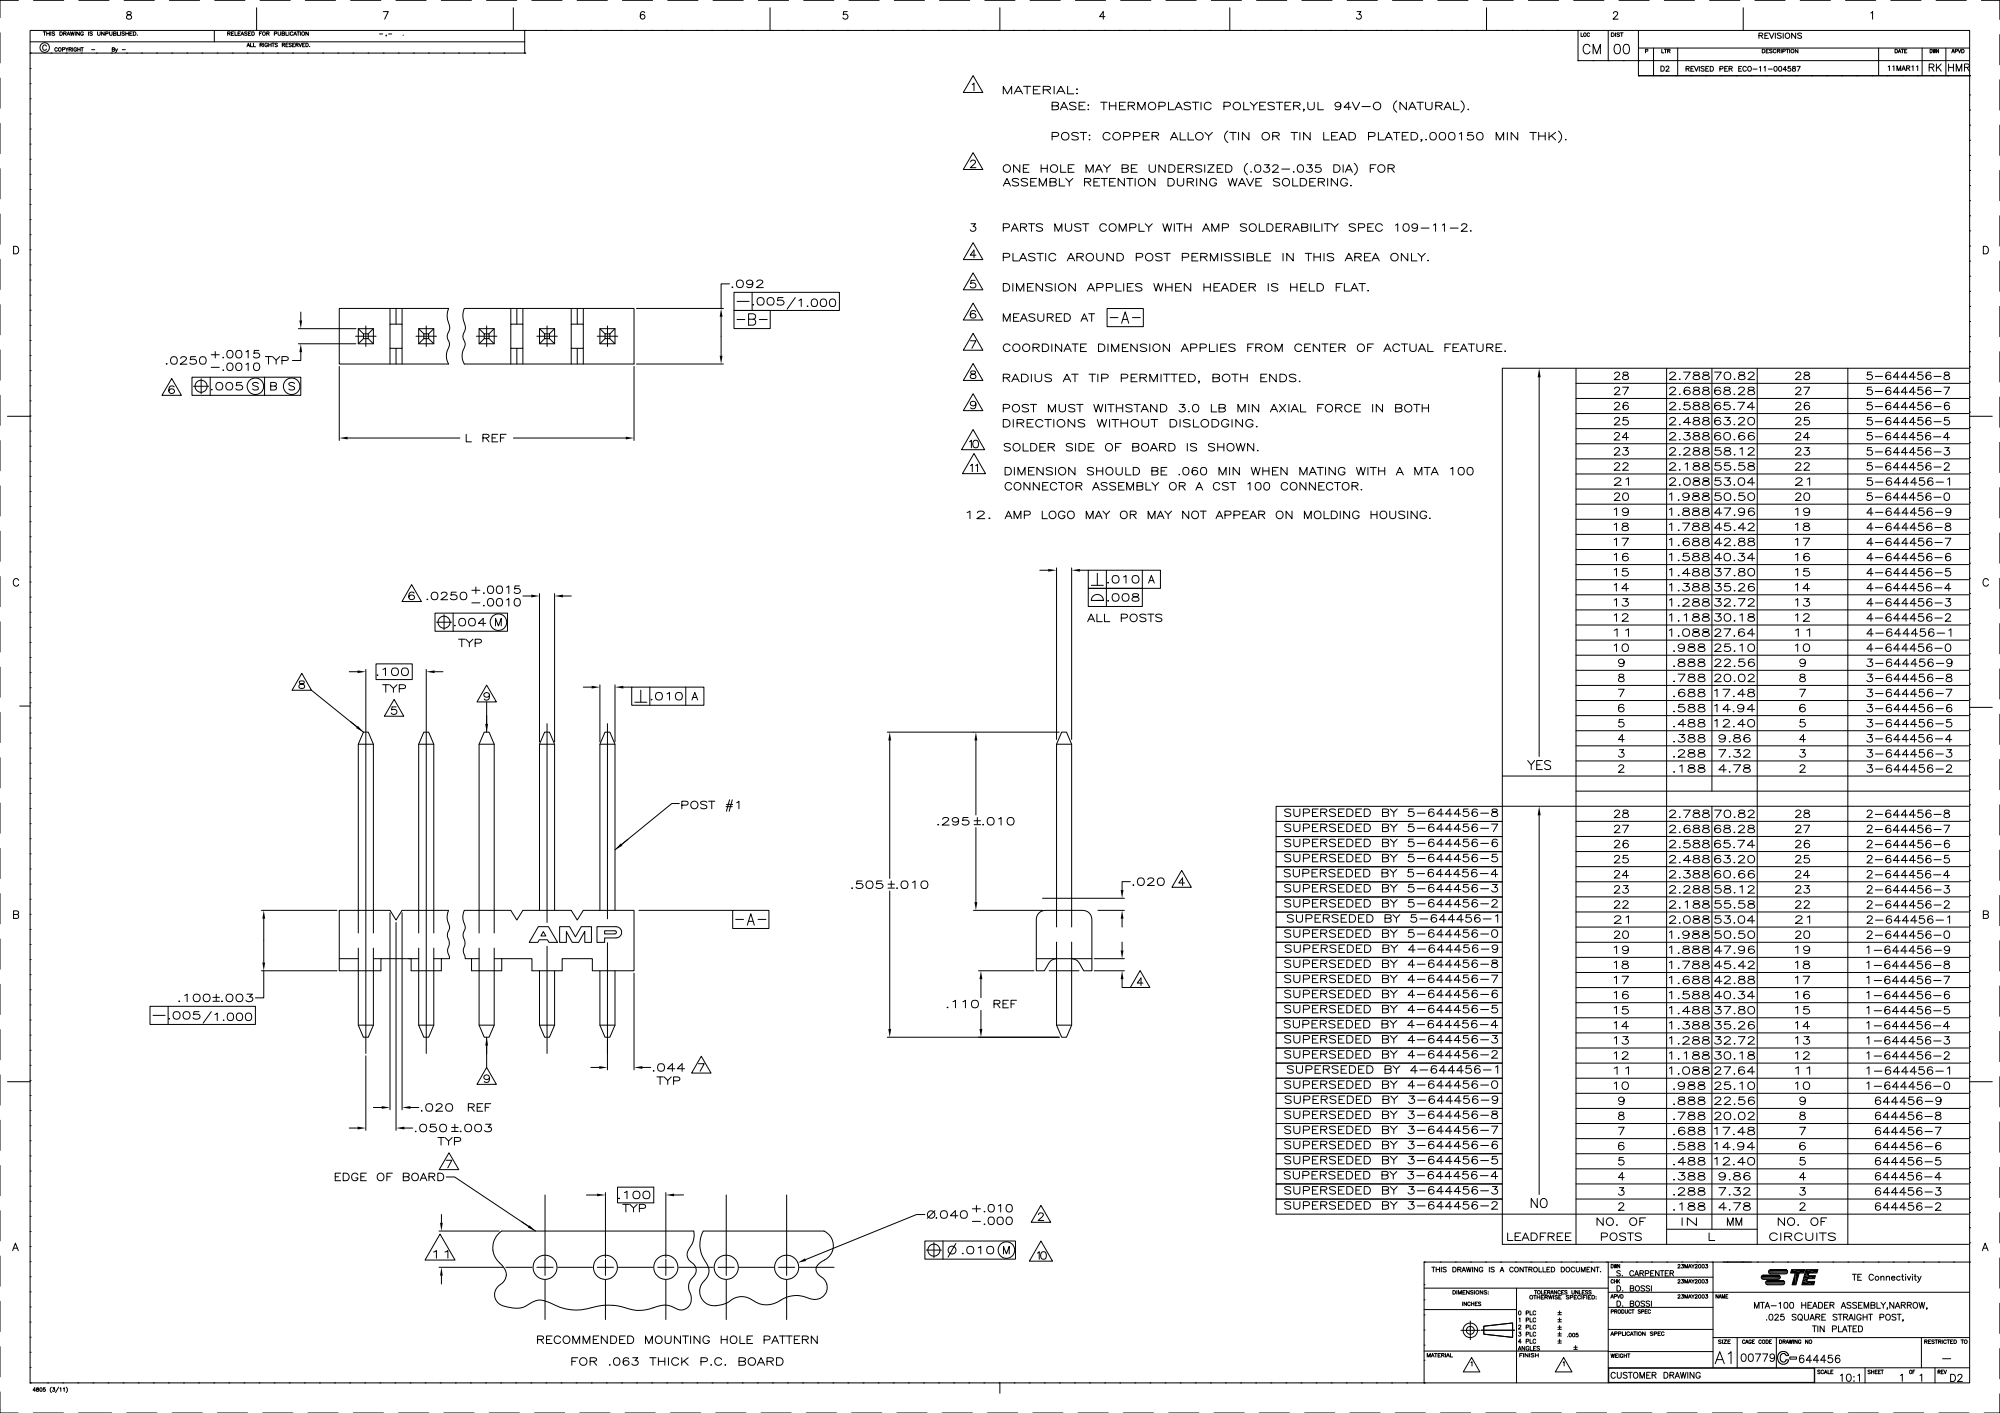
[picture p41: page 67]

1N5819HW
Document number: DS30217 Rev. 20 - 2

www.diodes.com

December 2020
© Diodes Incorporated

1N5819HW

1.0A SURFACE MOUNT SCHOTTKY BARRIER RECTIFIER

Product Summary (@ TA = +25°C)

VRRM (V) | IO (A) | VF(MAX) (mV) | IR(MAX) (µA)
40 | 1.0 | 450 | 50

Description and Applications

The device is a single rectifier offering low VF and excellent high temperature stability. This device is ideal for use in general rectification applications:
- For Use in Low Voltage, High Frequency Inverters
- Free Wheeling
- Polarity Protection Application

Features and Benefits

- High Surge Capability
- Low Power Loss, High Efficiency
- High Current Capability and Low Forward Voltage Drop
- Guard Ring Die Construction for Transient Protection
- Totally Lead-Free & Fully RoHS Compliant (Notes 1 & 2)
- Halogen and Antimony Free. “Green” Device (Note 3)
- For automotive applications requiring specific change control (i.e. parts qualified to AEC-Q100/101/200, PPAP capable, and manufactured in IATF 16949 certified facilities), please contact us or your local Diodes representative. https://www.diodes.com/quality/product-definitions/
- An Automotive-Compliant Part is Available Under Separate Datasheet (1N5819HWQ)

Mechanical Data

- Case: SOD123
- Plastic Material: Molded Plastic. UL Flammability Classification Rating 94V-0
- Moisture Sensitivity: Level 1 per J-STD-020
- Polarity: Cathode Band
- Leads: Matte Tin Finish Annealed over Alloy 42 Leadframe (Lead Free Plating) Solderable per MIL-STD-202, Method 208
- Weight: 0.01 grams (Approximate)

Ordering Information (Note 4)

Part Number | Case | Packaging
1N5819HW-7-F | SOD123 | 3000/Tape & Reel
Notes: | 1. No purposely added lead. Fully EU Directive 2002/95/EC (RoHS), 2011/65/EU (RoHS 2) & 2015/863/EU (RoHS 3) compliant.
2. See https://www.diodes.com/quality/lead-free/ for more information about Diodes Incorporated’s definitions of Halogen- and Antimony-free, "Green" and
| Lead-free.
3. Halogen and Antimony free "Green” products are defined as those which contain <900ppm bromine, <900ppm chlorine (<1500ppm total Br + Cl) and
| <1000ppm antimony compounds.
4. For packaging details, go to our website at https://www.diodes.com/design/support/packaging/diodes-packaging/.
Marking Information

Date Code Key
Year | 2003 | … | 2020 | 2021 | 2022 | 2023 | 2024 | 2025 | 2026 | 2027 | 2028 | 2029
Code | P | … | H | I | J | K | L | M | N | O | P | R
Month | Jan | Feb | Mar | Apr | May | Jun | Jul | Aug | Sep | Oct | Nov | Dec
Code | 1 | 2 | 3 | 4 | 5 | 6 | 7 | 8 | 9 | O | N | D

Top View

e3

SL = Product Type Marking Code YM & YM = Date Code Marking Y & Y = Year (ex: H = 2020)
M = Month (ex: 9 = September)

Device Schematic

LCD MOUDULE SPECIFICATION FOR APPROVAL | DATE | 18/03/04
| VER. | 1.0
| PAGE | 1

JHD162A

# CONTENTS

1. FEATURES |
2. MECHANICAL SPEC |
3. ABSOLUTE MAXIMUM RATING |
4. ELECTRICAL CHARACTERISTICS |
5. ELECTRO-OPTICAL CHARACTERISTICS . |
6. QC/QA PROCEDURE ...... |
7. RELIABILITY . |
8. BLOCK DIAGRAM .. |
9. POWER SUPPLY |
10. TIMIING DIAGRAM |
11. AC CHARACTERISTICS |
12. INSTRUCTION SET |
13. INITIALIZATION SEQUENCE |
14. FONT TABLE |
15. HANDLING PRECAUTION. |
16. EXTERNAL DIMENSION ..... |
17. INTERFACE ..... |

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
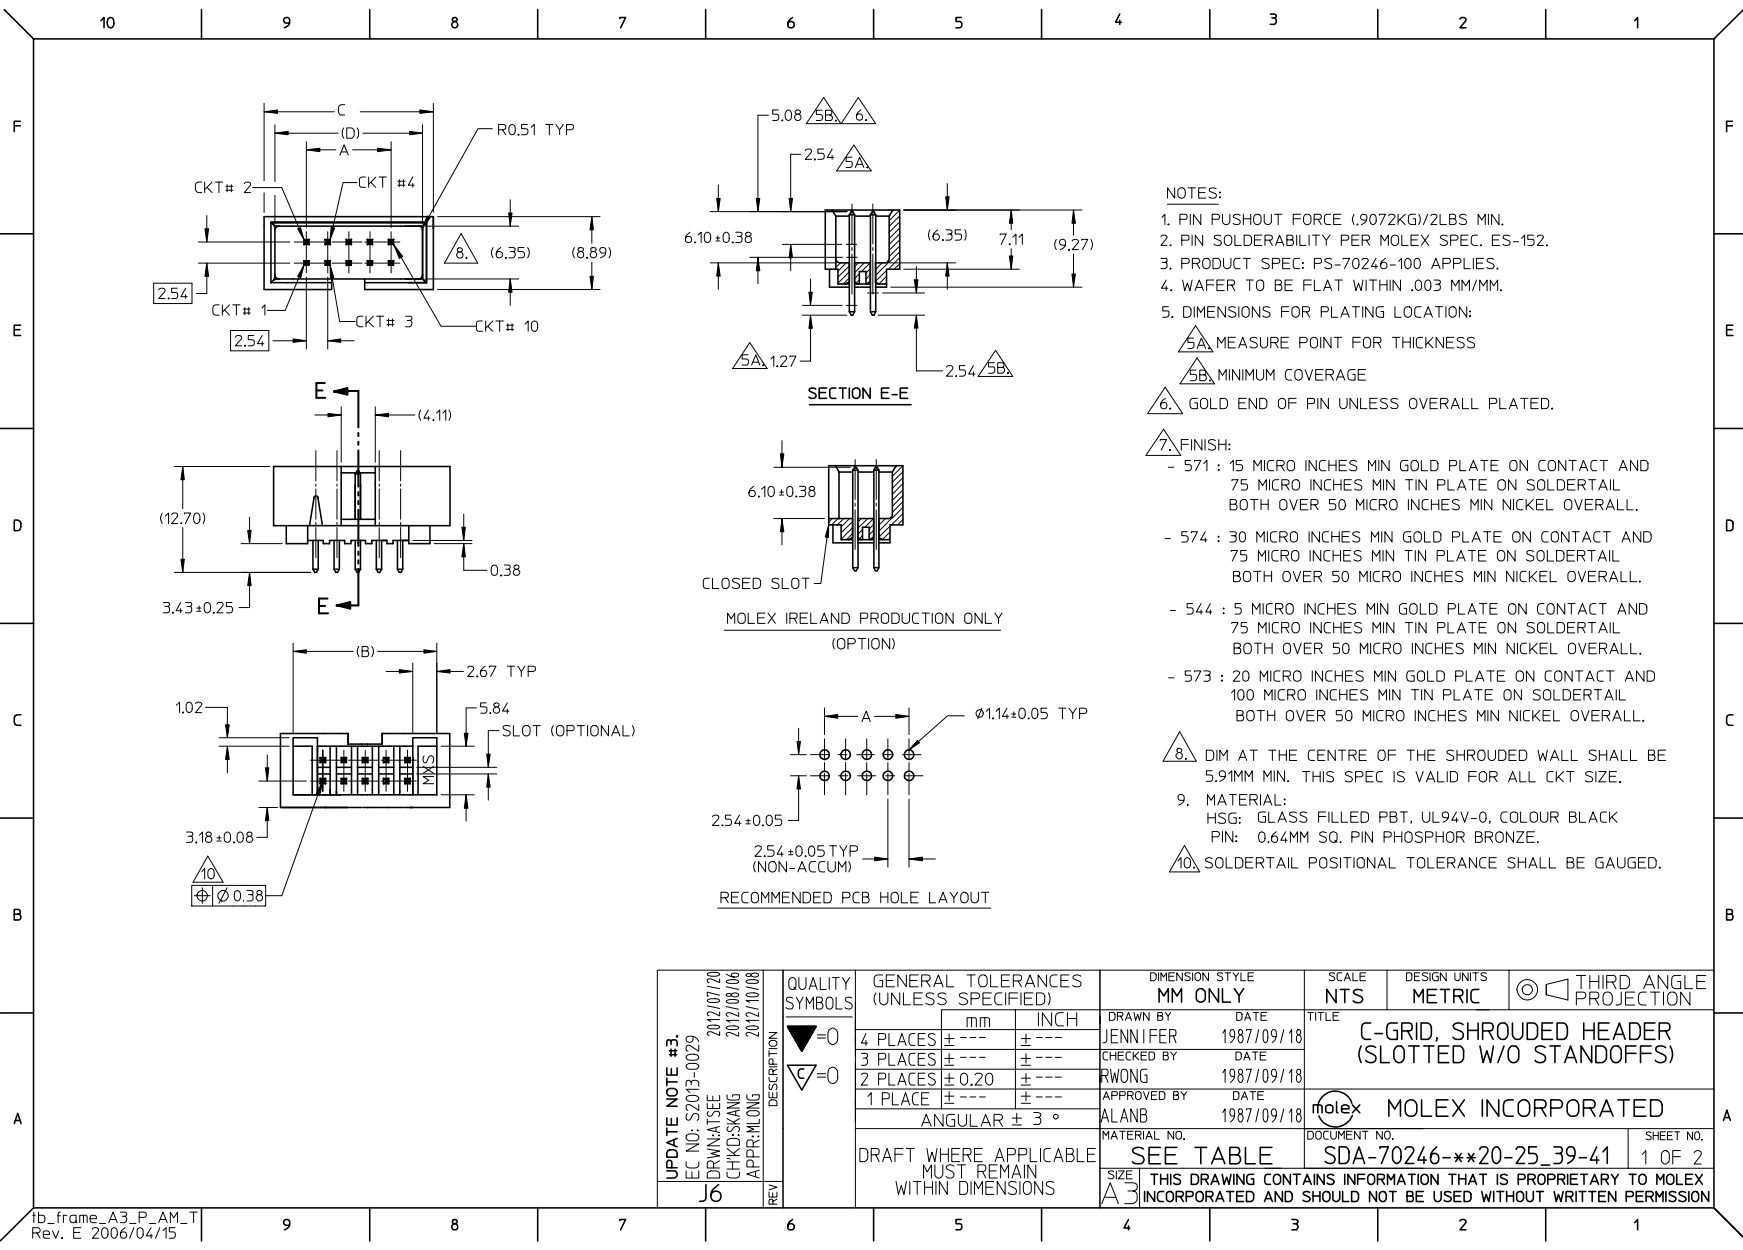
[picture p42: page 70]
