Felipedsi97/development-board-CAD/(list of files, drawings)

Other design files:
PI/projeto_individual.dsn
