Felipedsi97/development-board-CAD/PG/esquematico/projeto_grupo.1.kicad_pcb

## KiCad design PG/esquematico/projeto_grupo.1.kicad_pcb (2023-08-02)

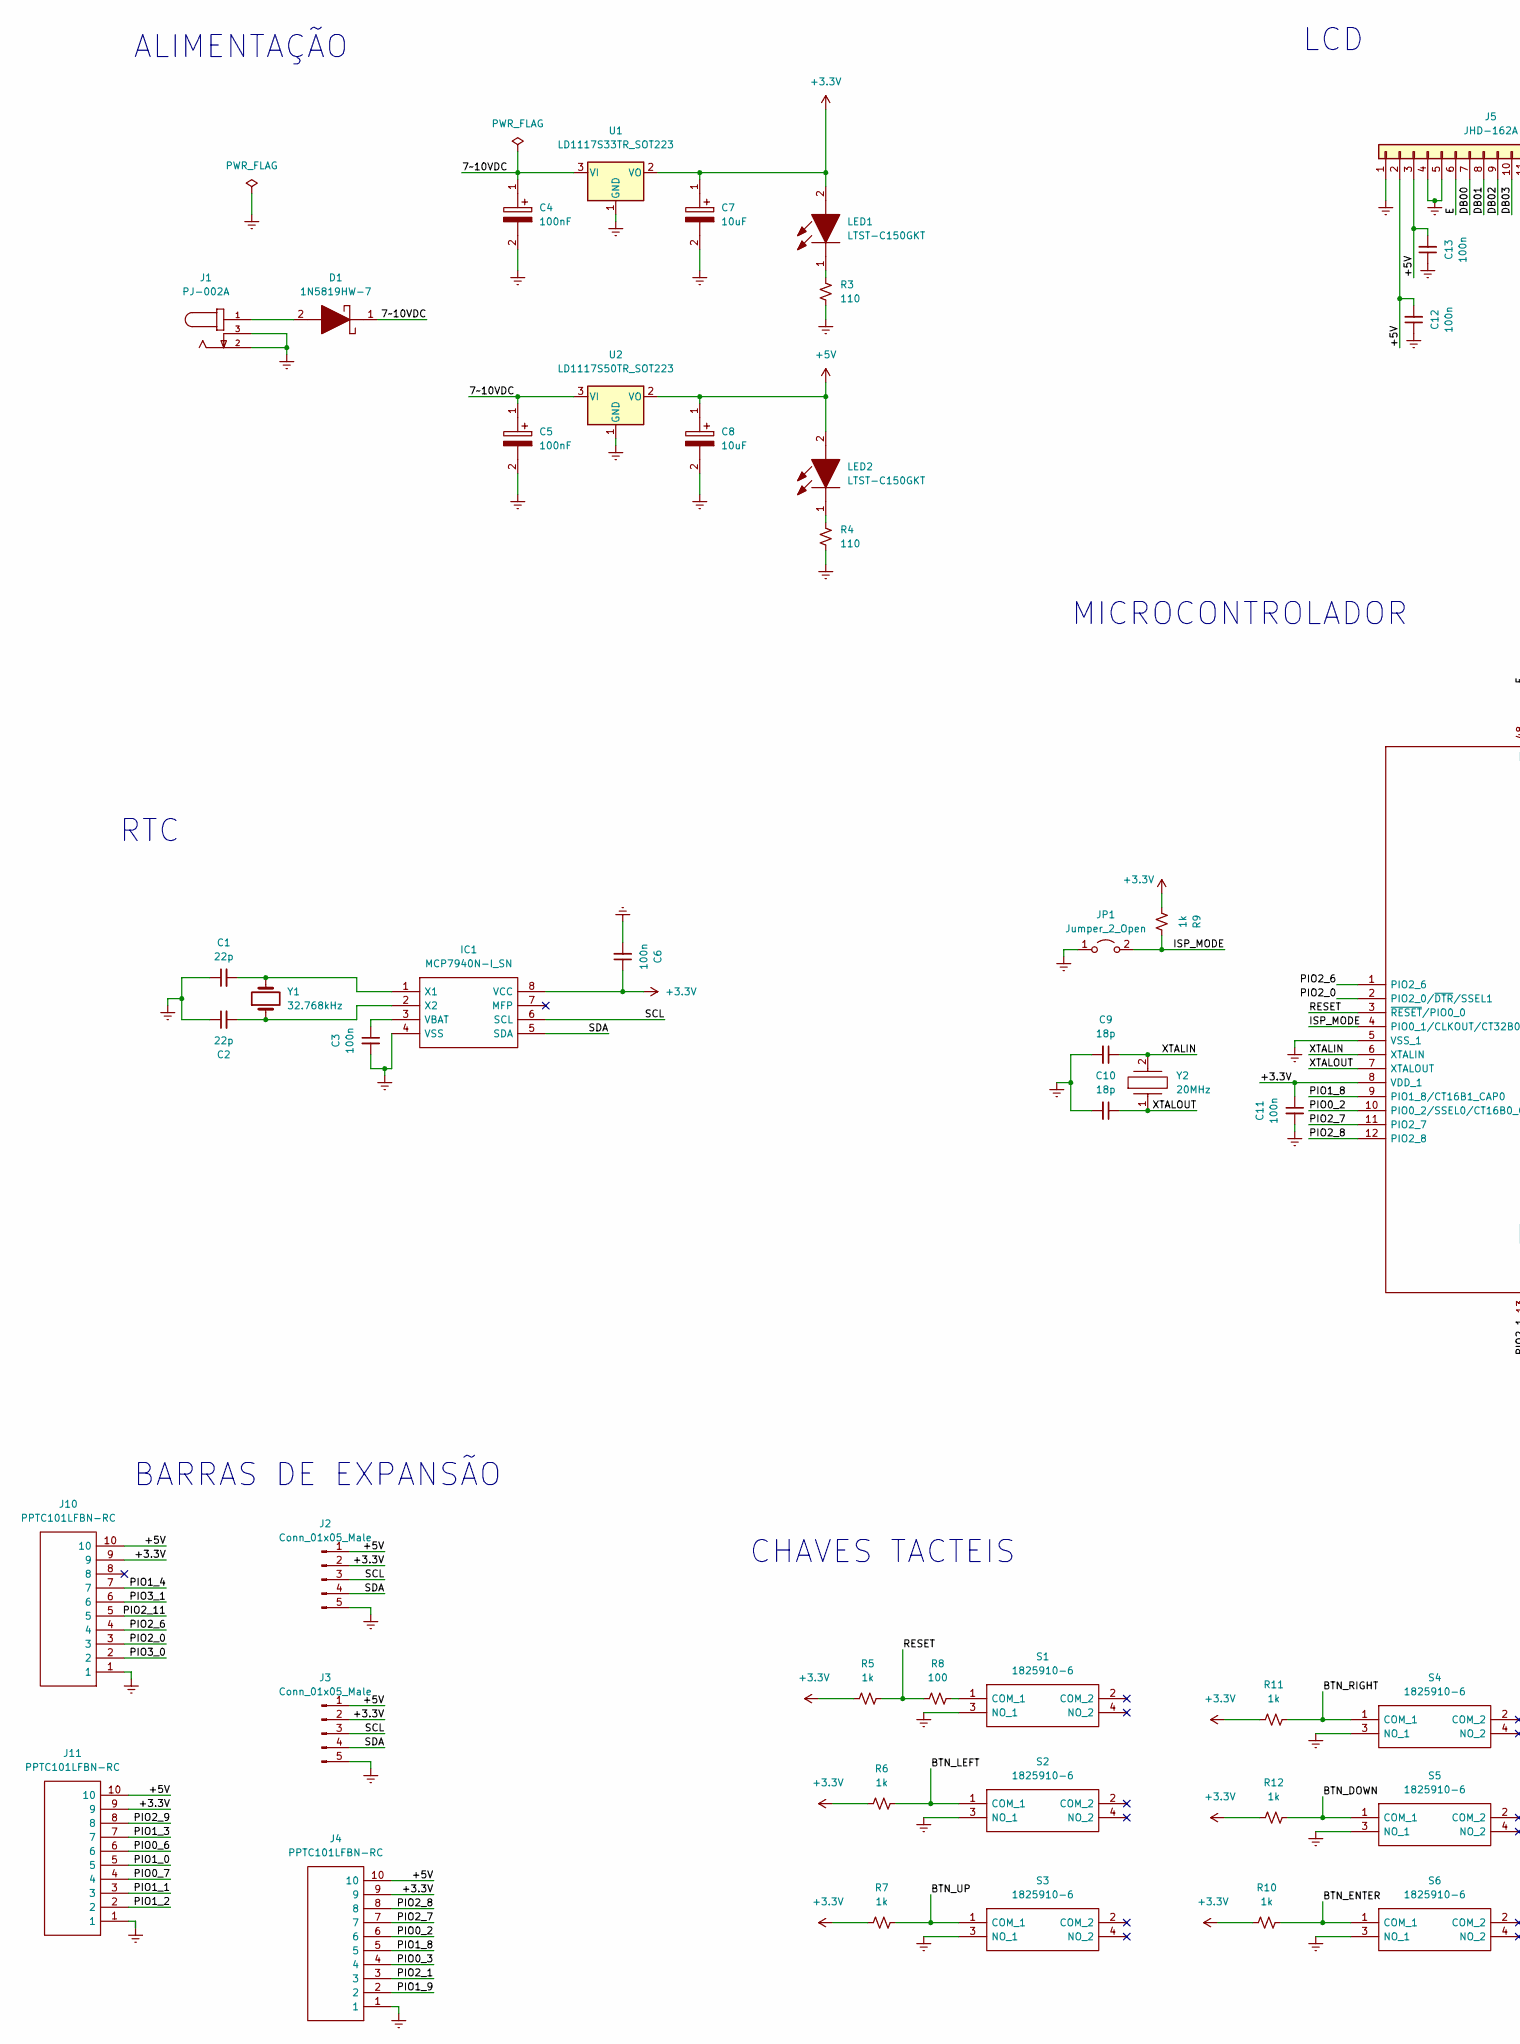
[picture p43: schematic projeto_grupo.1.kicad_sch, Projeto em grupo versão 1.0, part in row 1, column 1]

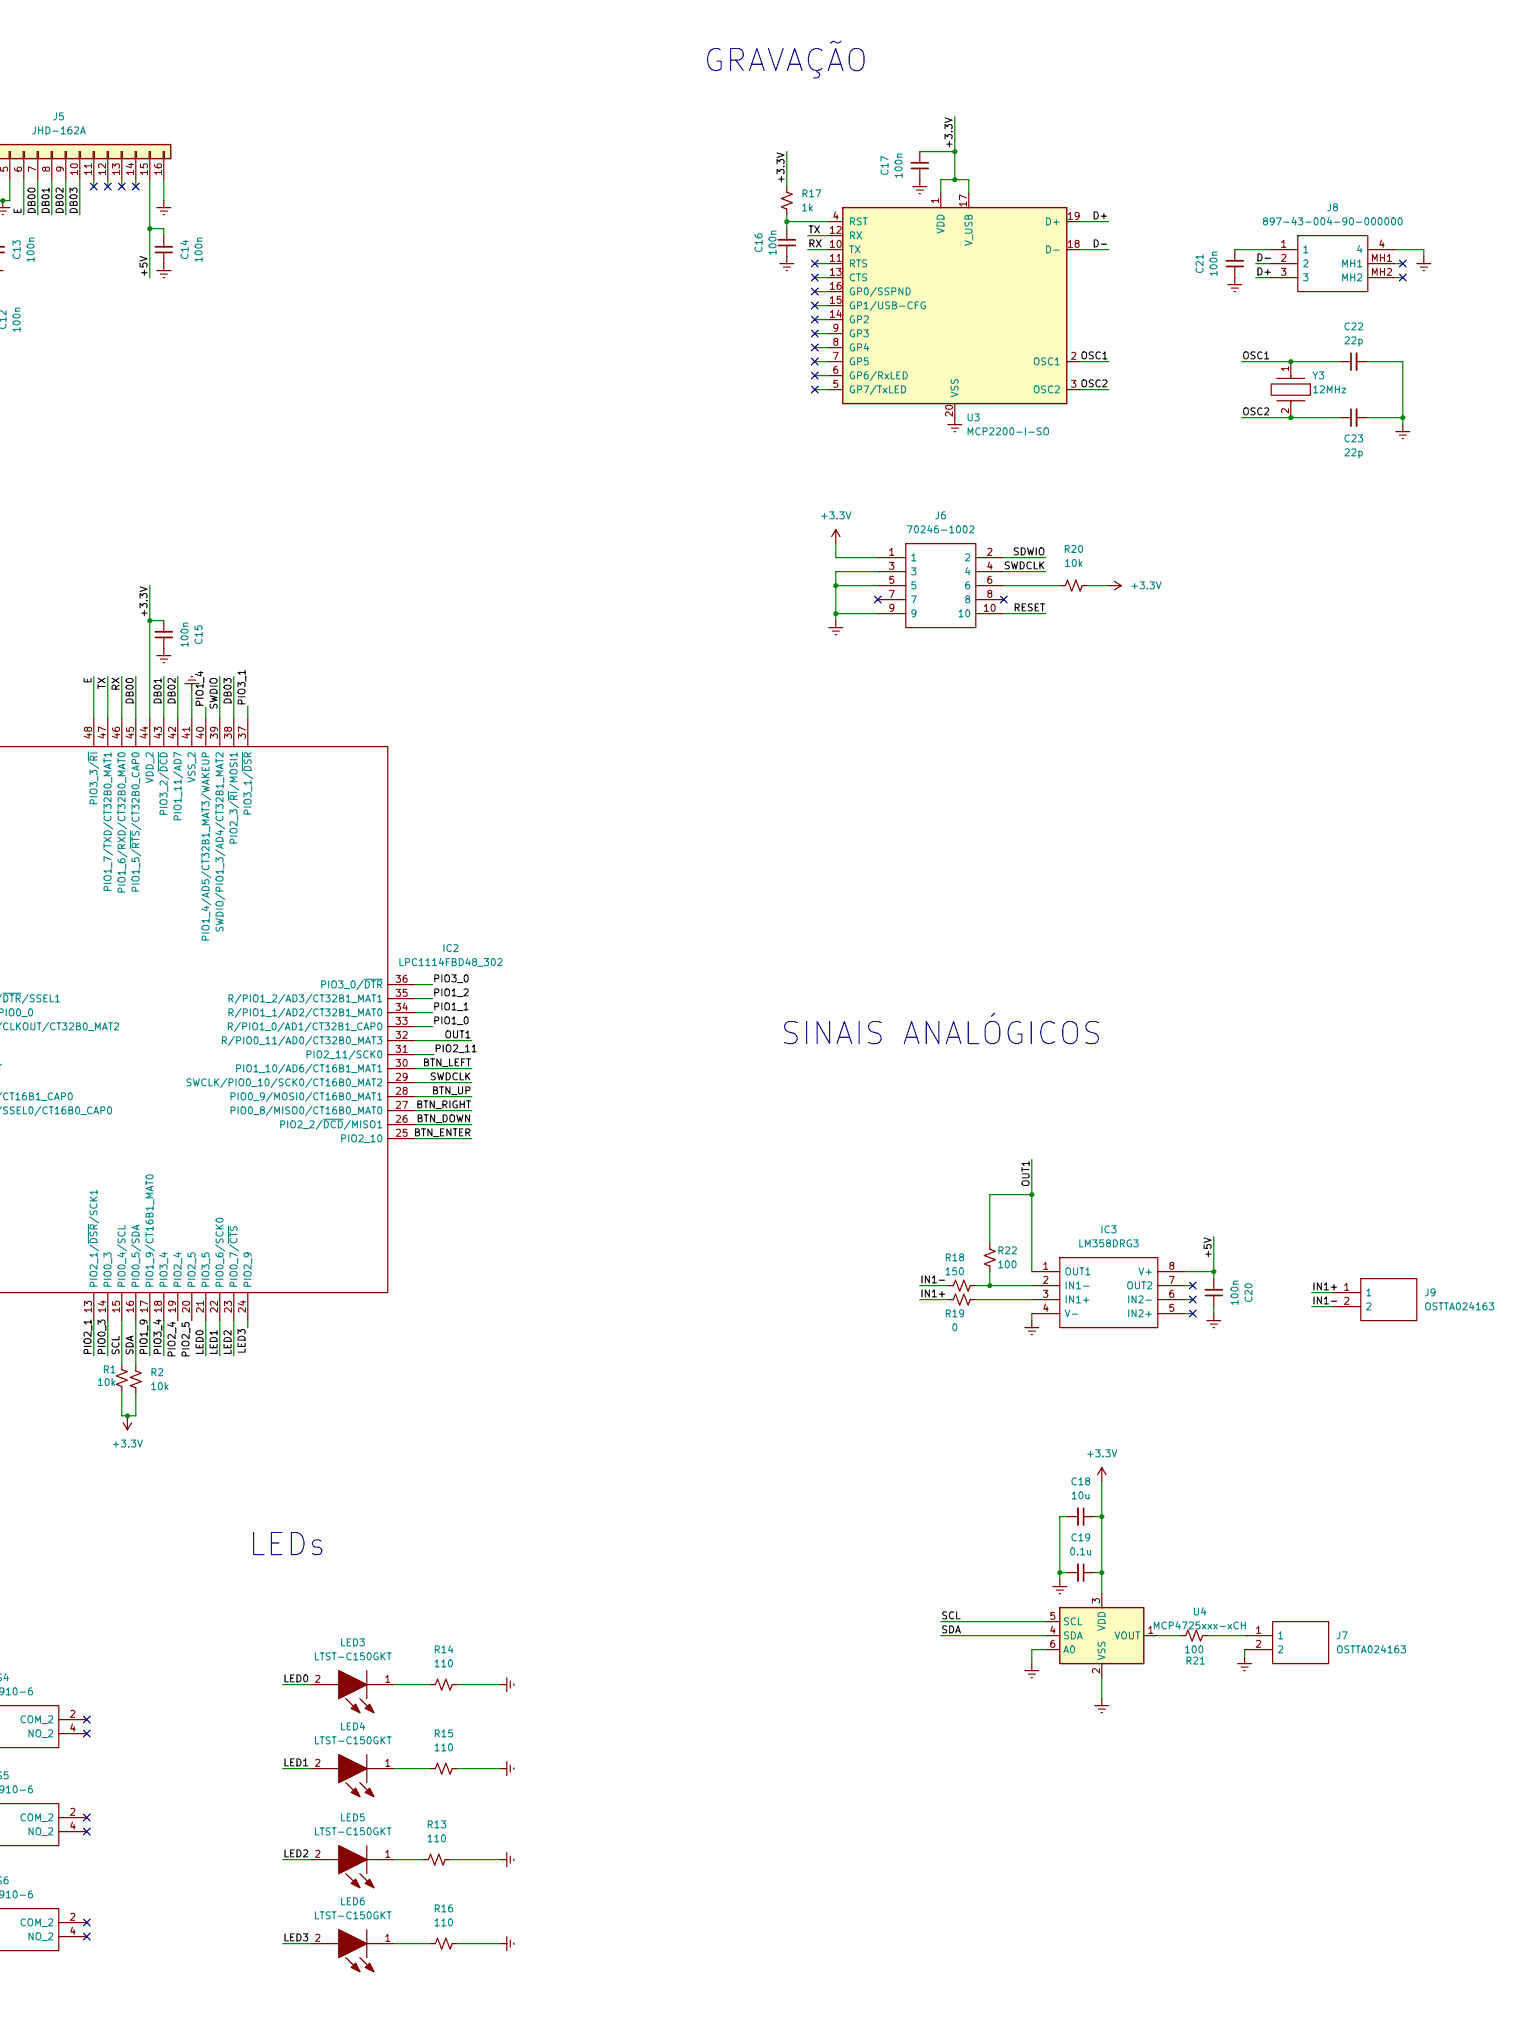
[picture p44: schematic projeto_grupo.1.kicad_sch, Projeto em grupo versão 1.0, part in row 1, column 2]

Parts:
C1, C2, C22, C23: 22p; C_0805_2012Metric
C3, C6, C11, C12, C13, C14, C15, C16, C17, C20, C21: 100n; C_0805_2012Metric
C4, C5: 100nF; CAPAE330X550N; Mouser Part Number 710-865090368008
C7, C8: 10uF; CAPAE330X550N; Mouser Part Number 710-865090368008
C9, C10: 18p; C_0805_2012Metric
C18: 10u; C_0805_2012Metric
C19: 0.1u; C_0805_2012Metric
D1: 1N5819HW-7; SOD3716X135N; Manufacturer_Part_Number 1N5819HW-7; Mouser Part Number 621-1N5819HW
IC1: MCP7940N-I_SN; SOIC127P600X175-8N; Manufacturer_Part_Number MCP7940N-I/SN; Mouser Part Number 579-MCP7940N-I/SN
IC2: LPC1114FBD48_302; QFP50P900X900X160-48N; Manufacturer_Part_Number LPC1114FBD48/302; Mouser Part Number N/A
IC3: LM358DRG3; SOIC127P600X175-8N; Manufacturer_Part_Number LM358DRG3; Mouser Part Number 595-LM358DRG3
J1: PJ-002A; CUI_PJ-002A
J2, J3: Conn_01x05_Male; PinHeader_1x05_P2.54mm_Horizontal
J4, J10, J11: PPTC101LFBN-RC; RHDR10W80P0X254_1X10_2590X254X850P; Manufacturer_Part_Number PPTC101LFBN-RC
J5: JHD-162A; PinHeader_1x16_P2.54mm_Vertical
J6: 70246-1002; SHDR10W99P254_2X5_2032X889X947P; Manufacturer_Part_Number 70246-1002; Mouser Part Number 538-70246-1002
J7, J9: OSTTA024163; Manufacturer_Part_Number OSTTA024163
J8: 897-43-004-90-000000; 8974300490000000; Manufacturer_Part_Number 897-43-004-90-000000; Mouser Part Number 575-8974349
JP1: Jumper_2_Open; PinHeader_1x02_P2.54mm_Vertical
LED1, LED2, LED3, LED4, LED5, LED6: LTST-C150GKT; LEDC3216X120N; Manufacturer_Part_Number LTST-C150GKT; Mouser Part Number 859-LTST-C150GKT
R1, R2, R20: 10k; R_0805_2012Metric
R3, R4, R13, R14, R15, R16: 110; R_0805_2012Metric
R5, R6, R7, R9, R10, R11, R12, R17: 1k; R_0805_2012Metric
R8, R21, R22: 100; R_0805_2012Metric
R18: 150; R_0805_2012Metric
R19: 0; R_0805_2012Metric
S1, S2, S3, S4, S5, S6: 1825910-6; 18259106; Manufacturer_Part_Number 1825910-6; Mouser Part Number N/A
U1: LD1117S33TR_SOT223; SOT223
U2: LD1117S50TR_SOT223; SOT230P700X180-4N
U3: MCP2200-I-SO; SOIC127P1030X265-20N
U4: MCP4725xxx-xCH; SOT95P270X145-6N
Y1: 32.768kHz; AB38T32768KHZ
Y2: 20MHz; ATS20A; Manufacturer_Part_Number ATS12A; Mouser Part Number 774-ATS12A
Y3: 12MHz; ATS12A; Manufacturer_Part_Number ATS12A; Mouser Part Number 774-ATS12A

Connections:
+3.3V: C6.1, C7.1, C11.1, C15.2, C17.2, C18.1, C19.1, IC1.8 (VCC), IC2.8 (VDD_1), IC2.44 (VDD_2), J2.2, J3.2, J4.9, J6.1, J10.9, J11.9, LED1.2, R1.2, R2.2, R5.2, R6.2, R7.2, R9.2, R10.2, R11.2, R12.2, R17.1, R20.1, U1.2 (VO), U3.1 (VDD), U3.16 (GP0/SSPND), U3.17 (V_USB), U4.3 (VDD)
+5V: C8.1, C12.2, C13.2, C14.2, C20.2, IC3.8 (V+), J2.1, J3.1, J4.10, J5.2, J5.3, J5.15, J10.10, J11.10, LED2.2, U2.2 (VO)
/7~10VDC: C4.1, C5.1, D1.1, U1.3 (VI), U2.3 (VI)
/BTN_DOWN: IC2.26 (PIO2_2/~DCD/MISO1), R12.1, S5.1 (COM_1)
/BTN_ENTER: IC2.25 (PIO2_10), R10.1, S6.1 (COM_1)
/BTN_LEFT: IC2.30 (PIO1_10/AD6/CT16B1_MAT1), R6.1, S2.1 (COM_1)
/BTN_RIGHT: IC2.27 (PIO0_8/MISO0/CT16B0_MAT0), R11.1, S4.1 (COM_1)
/BTN_UP: IC2.28 (PIO0_9/MOSI0/CT16B0_MAT1), R7.1, S3.1 (COM_1)
/D+: J8.3, U3.19 (D+)
/D-: J8.2, U3.18 (D-)
/DB00: IC2.45 (PIO1_5/~RTS/CT32B0_CAP0), J5.7
/DB01: IC2.43 (PIO3_2/~DCD), J5.8
/DB02: IC2.42 (PIO1_11/AD7), J5.9
/DB03: IC2.38 (PIO2_3/~RI/MOSI1), J5.10
/E: IC2.48 (PIO3_3/~RI), J5.6
/IN1+: J9.1, R19.2
/IN1-: J9.2, R18.1
/ISP_MODE: IC2.4 (PIO0_1/CLKOUT/CT32B0_MAT2), JP1.2 (B), R9.1
/LED0: IC2.21 (PIO3_5), LED3.2
/LED1: IC2.22 (PIO0_6/SCK0), LED4.2
/LED2: IC2.23 (PIO0_7/~CTS), LED5.2
/LED3: IC2.24 (PIO2_9), LED6.2
/OSC1: C22.1, U3.2 (OSC1), Y3.1
/OSC2: C23.1, U3.3 (OSC2), Y3.2
/OUT1: IC2.32 (R/PIO0_11/AD0/CT32B0_MAT3), IC3.1 (OUT1), R22.1
/PIO0_2: IC2.10 (PIO0_2/SSEL0/CT16B0_CAP0), J4.6
/PIO0_3: IC2.14 (PIO0_3), J4.4
/PIO0_6: J11.6
/PIO0_7: J11.4
/PIO1_0: IC2.33 (R/PIO1_0/AD1/CT32B1_CAP0), J11.5
/PIO1_1: IC2.34 (R/PIO1_1/AD2/CT32B1_MAT0), J11.3
/PIO1_2: IC2.35 (R/PIO1_2/AD3/CT32B1_MAT1), J11.2
/PIO1_3: J11.7
/PIO1_4: IC2.40 (PIO1_4/AD5/CT32B1_MAT3/WAKEUP), J10.7
/PIO1_8: IC2.9 (PIO1_8/CT16B1_CAP0), J4.5
/PIO1_9: IC2.17 (PIO1_9/CT16B1_MAT0), J4.2
/PIO2_0: IC2.2 (PIO2_0/~DTR/SSEL1), J10.3
/PIO2_1: IC2.13 (PIO2_1/~DSR/SCK1), J4.3
/PIO2_4: IC2.19 (PIO2_4)
/PIO2_5: IC2.20 (PIO2_5)
/PIO2_6: IC2.1 (PIO2_6), J10.4
/PIO2_7: IC2.11 (PIO2_7), J4.7
/PIO2_8: IC2.12 (PIO2_8), J4.8
/PIO2_9: J11.8
/PIO2_11: IC2.31 (PIO2_11/SCK0), J10.5
/PIO3_0: IC2.36 (PIO3_0/~DTR), J10.2
/PIO3_1: IC2.37 (PIO3_1/~DSR), J10.6
/PIO3_4: IC2.18 (PIO3_4)
/RESET: IC2.3 (~RESET/PIO0_0), J6.10, R5.1, R8.2
/RX: IC2.46 (PIO1_6/RXD/CT32B0_MAT0), U3.10 (TX)
/SCL: IC1.6 (SCL), IC2.15 (PIO0_4/SCL), J2.3, J3.3, R1.1, U4.5 (SCL)
/SDA: IC1.5 (SDA), IC2.16 (PIO0_5/SDA), J2.4, J3.4, R2.1, U4.4 (SDA)
/SDWIO: J6.2
/SWDCLK: IC2.29 (SWCLK/PIO0_10/SCK0/CT16B0_MAT2), J6.4
/SWDIO: IC2.39 (SWDIO/PIO1_3/AD4/CT32B1_MAT2)
/TX: IC2.47 (PIO1_7/TXD/CT32B0_MAT1), U3.12 (RX)
/XTALIN: C9.1, IC2.6 (XTALIN), Y2.2
/XTALOUT: C10.1, IC2.7 (XTALOUT), Y2.1
Earth: C1.1, C2.1, C3.2, C4.2, C5.2, C6.2, C7.2, C8.2, C9.2, C10.2, C11.2, C12.1, C13.1, C14.1, C15.1, C16.1, C17.1, C18.2, C19.2, C20.1, C21.1, C22.2, C23.2, IC1.4 (VSS), IC2.5 (VSS_1), IC2.41 (VSS_2), IC3.4 (V-), J1.2, J1.3, J2.5, J3.5, J4.1, J5.1, J5.4, J5.5, J5.16, J6.3, J6.5, J6.9, J7.2, J8.4, J10.1, J11.1, JP1.1 (A), R3.2, R4.2, R13.1, R14.1, R15.1, R16.1, S1.3 (NO_1), S2.3 (NO_1), S3.3 (NO_1), S4.3 (NO_1), S5.3 (NO_1), S6.3 (NO_1), U1.1 (GND), U2.1 (GND), U3.20 (VSS), U4.2 (VSS), U4.6 (A0)
unnamed: C1.2, IC1.1 (X1), Y1.2
unnamed: C2.2, IC1.2 (X2), Y1.1
unnamed: C3.1, IC1.3 (VBAT)
unnamed: C16.2, R17.2, U3.4 (RST)
unnamed: C21.2, J8.1
unnamed: D1.2, J1.1
unnamed: IC3.2 (IN1-), R18.2, R22.2
unnamed: IC3.3 (IN1+), R19.1
unnamed: J6.6, R20.2
unnamed: J7.1, R21.1
unnamed: LED1.1, R3.1
unnamed: LED2.1, R4.1
unnamed: LED3.1, R14.2
unnamed: LED4.1, R15.2
unnamed: LED5.1, R13.2
unnamed: LED6.1, R16.2
unnamed: R8.1, S1.1 (COM_1)
unnamed: R21.2, U4.1 (VOUT)

Notes on the sheet:
SINAIS ANALÓGICOS
LEDs
GRAVAÇÃO
CHAVES TACTEIS
MICROCONTROLADOR
RTC
ALIMENTAÇÃO
LCD
BARRAS DE EXPANSÃO

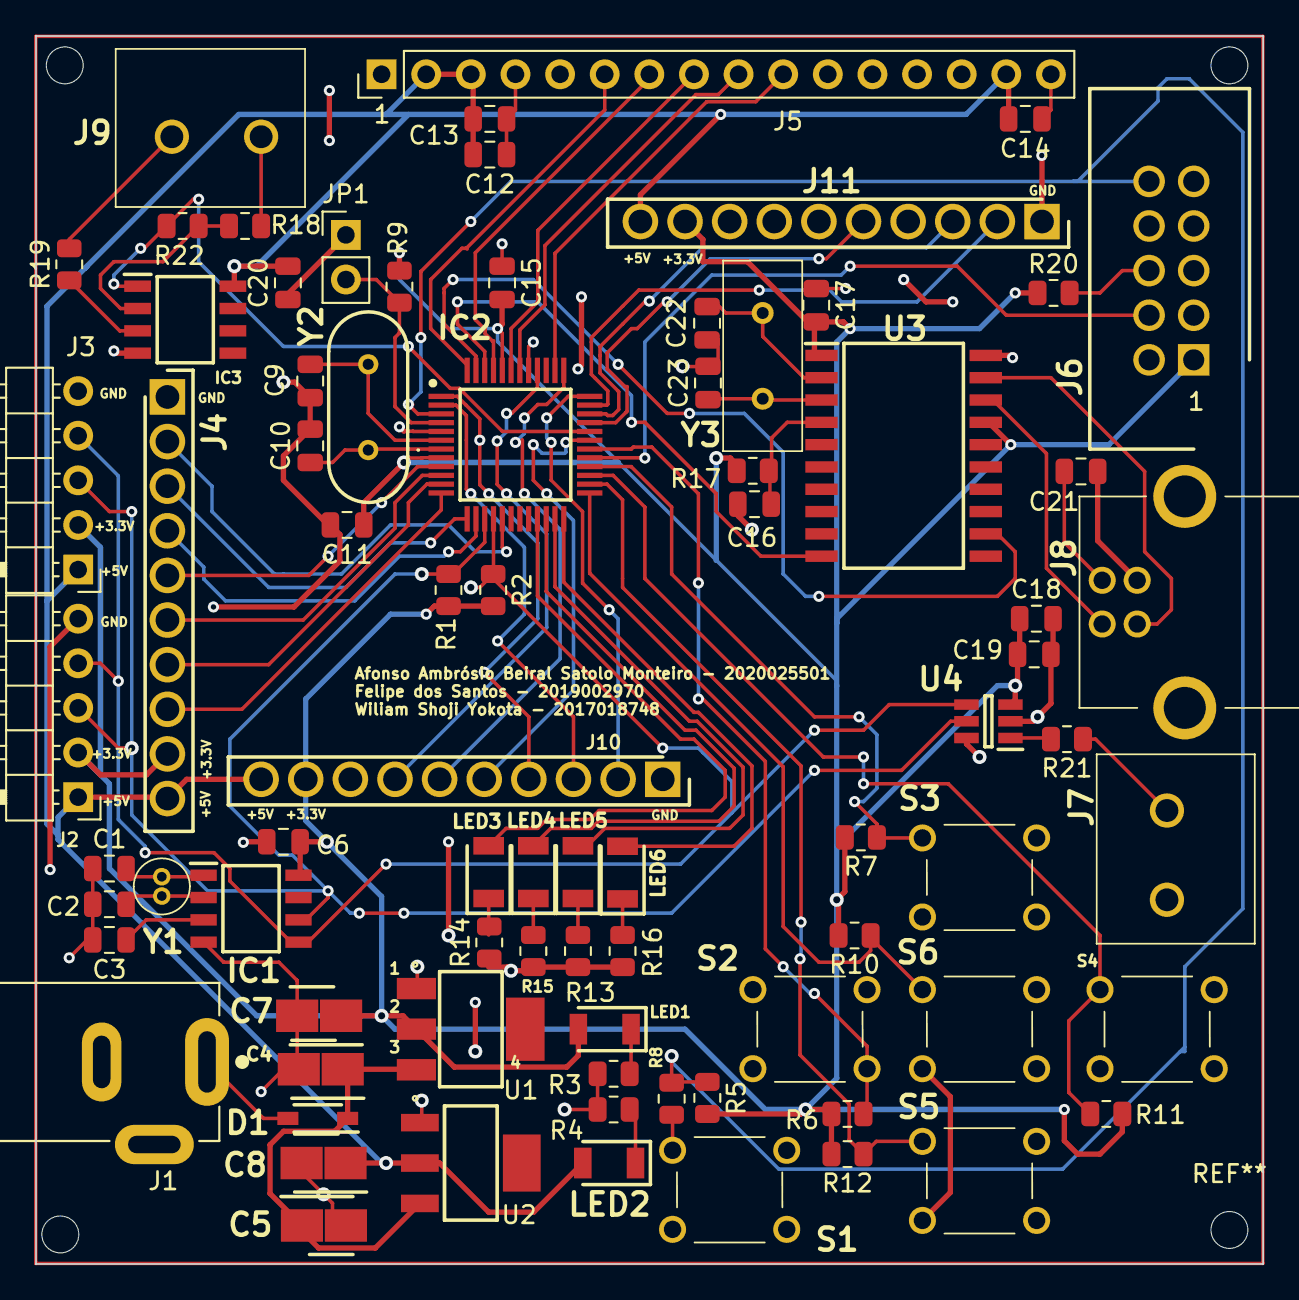
[picture p45: board projeto_grupo.1.kicad_pcb from above]

Board: 2 copper layers, 69.9 x 69.9 mm, 80 parts (0 on the bottom side), 68 nets.
