Felipedsi97/development-board-CAD/PI/projeto_individual.kicad_pcb

## KiCad design PI/projeto_individual.kicad_pcb (2023-08-02)

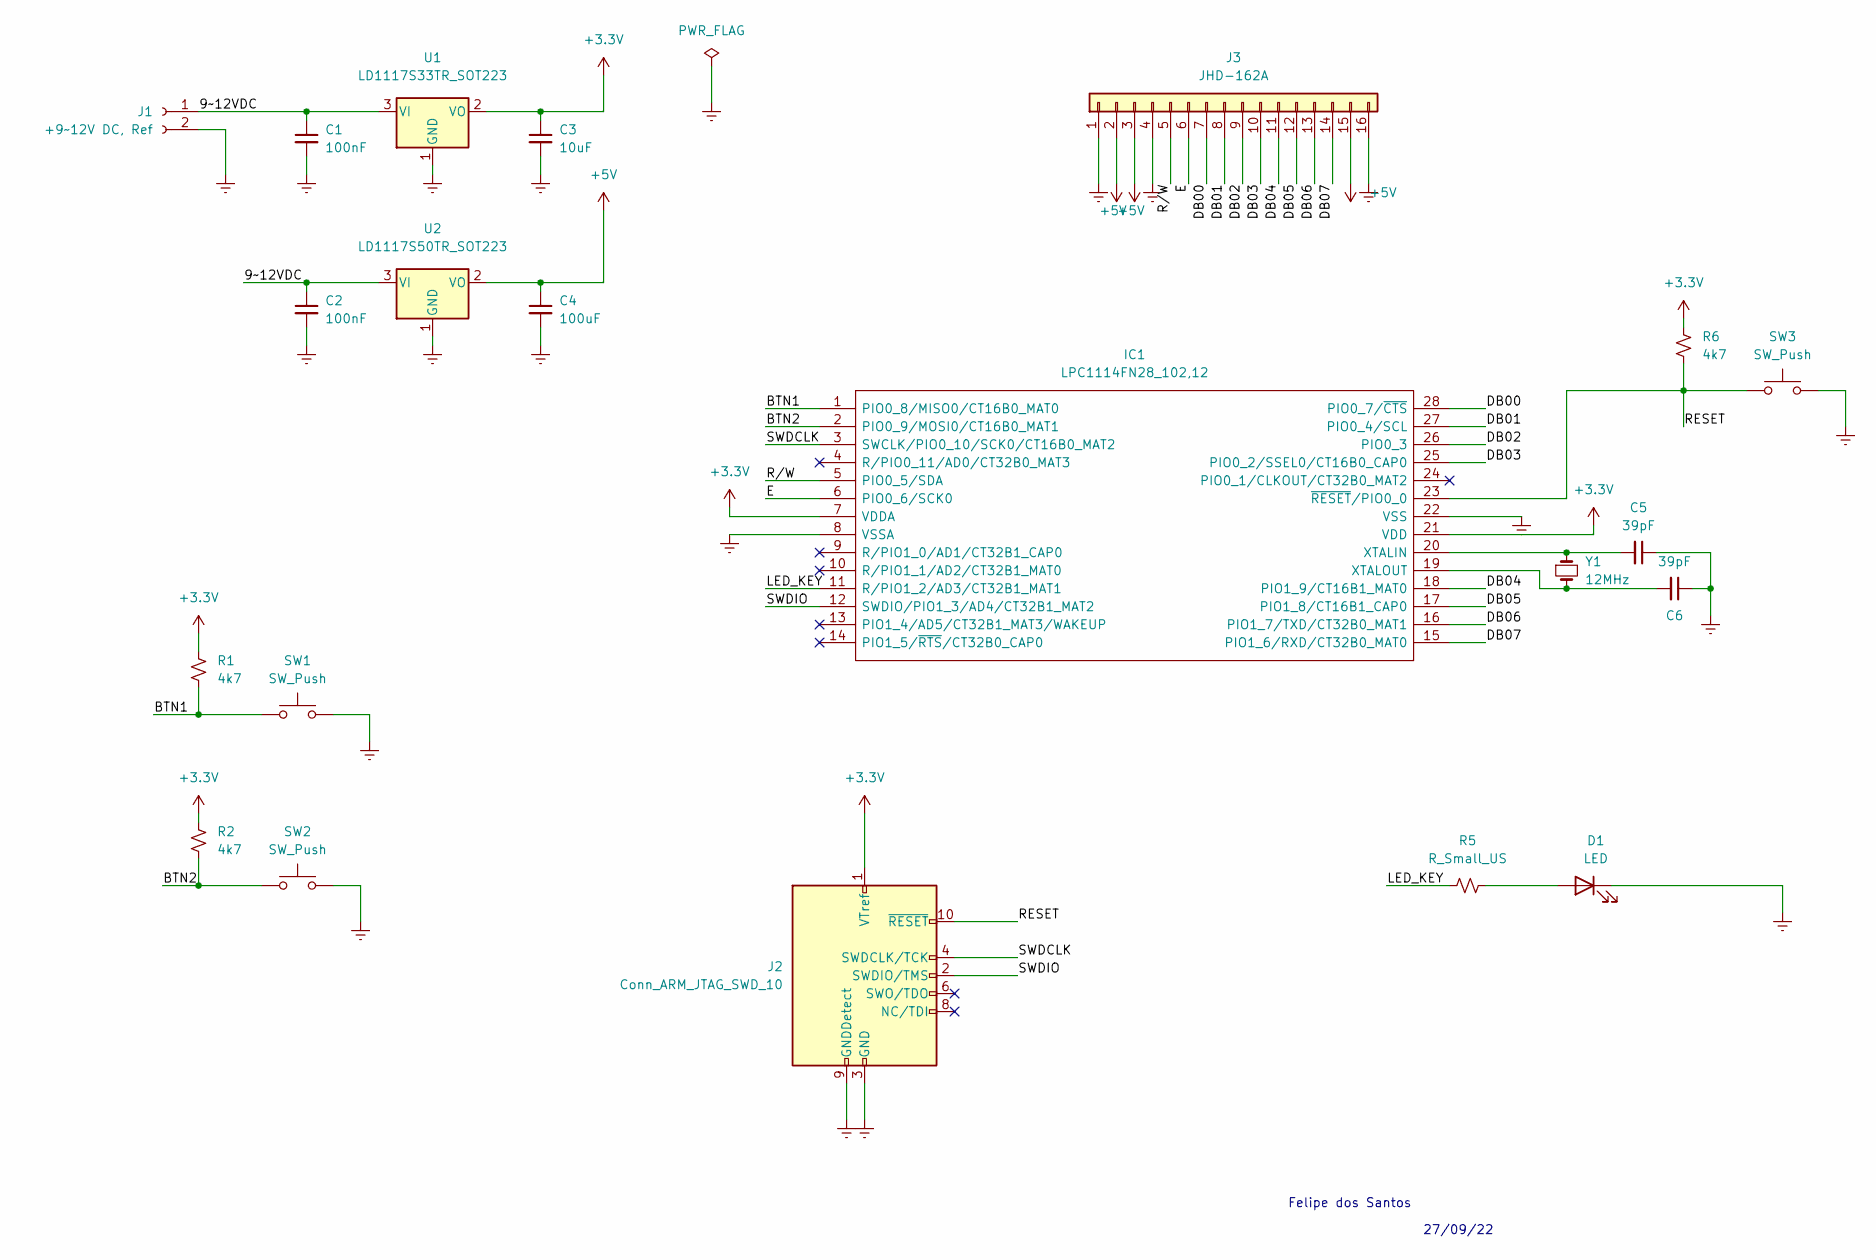
[picture p46: schematic projeto_individual.kicad_sch]

Parts:
C1, C2: 100nF; C_0805_2012Metric
C3: 10uF; C_0805_2012Metric
C4: 100uF; C_0805_2012Metric
C5, C6: 39pF; C_0805_2012Metric
D1: LED; LEDC3216X120N
IC1: LPC1114FN28_102,12; DIP1552W53P254L3550H510Q28N; Manufacturer_Part_Number LPC1114FN28/102,12; Mouser Part Number 771-LPC1114FN28/1021
J1: +9~12V DC, Ref; CUI_PJ-002A
J2: Conn_ARM_JTAG_SWD_10; PinHeader_2x05_P2.54mm_Horizontal
J3: JHD-162A; PinHeader_1x16_P1.00mm_Horizontal
R1, R2, R6: 4k7; R_0805_2012Metric
R5: R_Small_US; R_0805_2012Metric
SW1, SW2, SW3: SW_Push; 1825910-6
U1: LD1117S33TR_SOT223; SOT-223-3_TabPin2
U2: LD1117S50TR_SOT223; SOT-223-3_TabPin2
Y1: 12MHz; XTAL_HC49P488W43L1085T450H368

Connections:
+3.3V: C3.1, IC1.7 (VDDA), IC1.21 (VDD), J2.1 (VTref), R1.1, R2.1, R6.1, U1.2 (VO)
+5V: C4.1, J3.2, J3.3, J3.15, U2.2 (VO)
/BTN1: IC1.1 (PIO0_8/MISO0/CT16B0_MAT0), R1.2, SW1.1
/BTN2: IC1.2 (PIO0_9/MOSI0/CT16B0_MAT1), R2.2, SW2.1
/DB00: IC1.28 (PIO0_7/~CTS), J3.7
/DB01: IC1.27 (PIO0_4/SCL), J3.8
/DB02: IC1.26 (PIO0_3), J3.9
/DB03: IC1.25 (PIO0_2/SSEL0/CT16B0_CAP0), J3.10
/DB04: IC1.18 (PIO1_9/CT16B1_MAT0), J3.11
/DB05: IC1.17 (PIO1_8/CT16B1_CAP0), J3.12
/DB06: IC1.16 (PIO1_7/TXD/CT32B0_MAT1), J3.13
/DB07: IC1.15 (PIO1_6/RXD/CT32B0_MAT0), J3.14
/E: IC1.6 (PIO0_6/SCK0), J3.6
/LED_KEY: IC1.11 (R/PIO1_2/AD3/CT32B1_MAT1), R5.1
/RESET: IC1.23 (~RESET/PIO0_0), J2.10 (~RESET), R6.2, SW3.1
/R/W: IC1.5 (PIO0_5/SDA), J3.5
/SWDCLK: IC1.3 (SWCLK/PIO0_10/SCK0/CT16B0_MAT2), J2.4 (SWDCLK/TCK)
/SWDIO: IC1.12 (SWDIO/PIO1_3/AD4/CT32B1_MAT2), J2.2 (SWDIO/TMS)
Earth: C1.2, C2.2, C3.2, C4.2, C5.1, C6.1, D1.1 (K), IC1.8 (VSSA), IC1.22 (VSS), J1.2, J2.3 (GND), J2.5 (GND), J2.9 (GNDDetect), J3.1, J3.4, J3.16, SW1.2, SW2.2, SW3.2, U1.1 (GND), U2.1 (GND)
unnamed: C5.2, IC1.20 (XTALIN), Y1.1
unnamed: C6.2, IC1.19 (XTALOUT), Y1.2
unnamed: D1.2 (A), R5.2

Notes on the sheet:
27/09/22
Felipe dos Santos

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
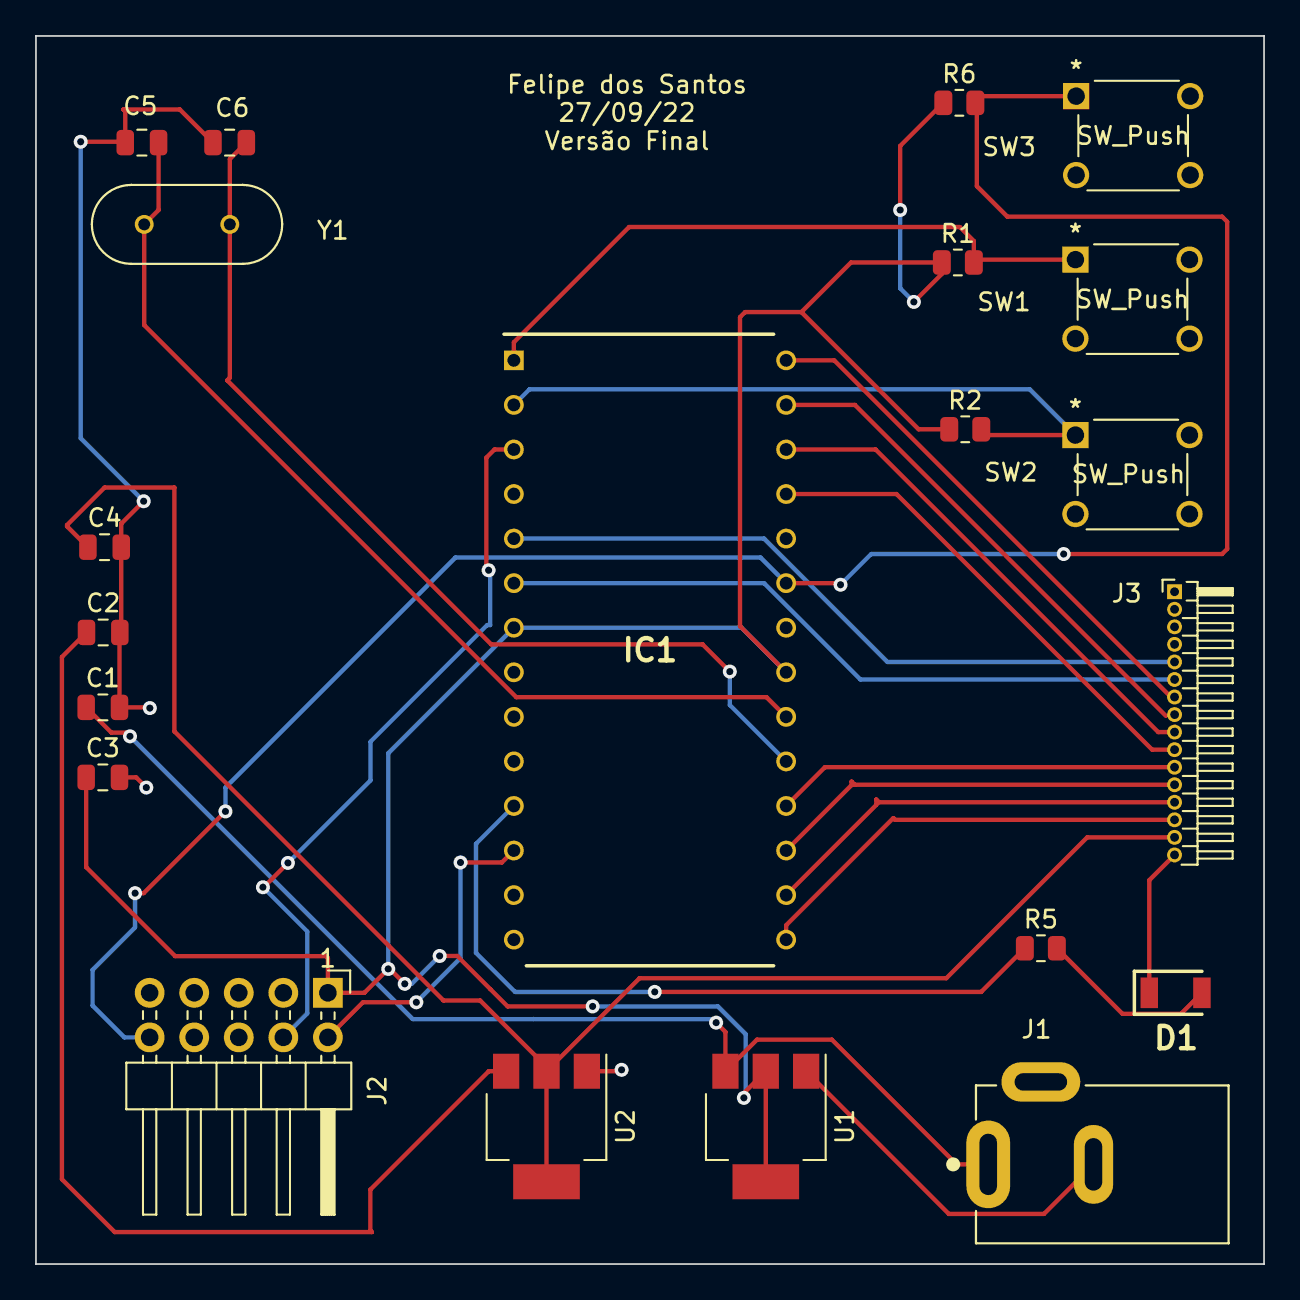
[picture p47: board projeto_individual.kicad_pcb from above]

Board: 2 copper layers, 70.0 x 70.0 mm, 21 parts (0 on the bottom side), 24 nets.
